Klagarge/Compressor/EliseZanou_RemiHeredero_Compresseur.pdf

# CCO : PROJET

## Compresseur Monocylindre

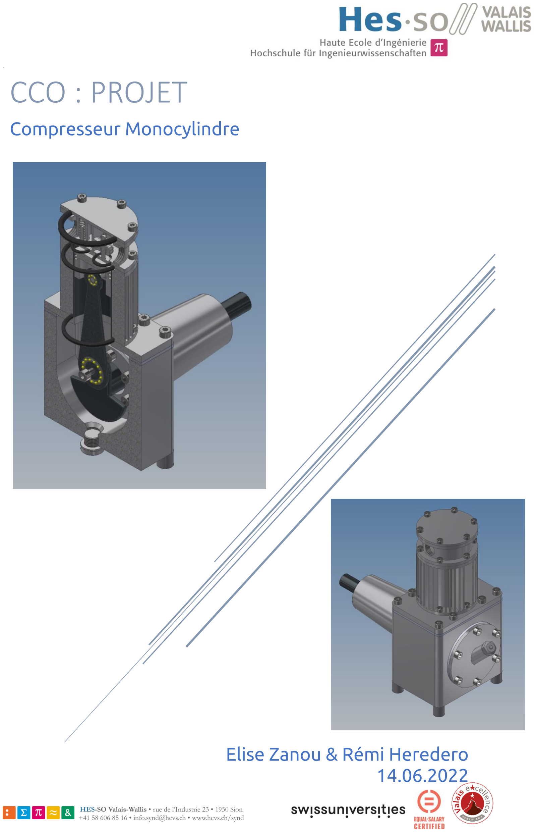
[picture p3: page 1]

HES-SO Valais-Wallis • rue de l’Industrie 23 • 1950 Sion +41 58 606 85 16 • info.synd@hevs.ch • www.hevs.ch/synd

CC

## Elise Zanou & Rémi Heredero

14.06.2022

Elise Zanou & Rémi Heredero | Projet Compresseur | CCO

## Table des matières

5.8 | Carter chapeau P017 | 10
5.9 | Vilebrequin P015 | 10
6 | Bielle P012 | 10
7 | Les roulements | 11
8 | Synthèses et conclusion | 11
9 | Annexes | 12
9.1 | Rapport analyse roulement | 12
9.2 | Choix ressorts | 16
9.3 | Lexique des abréviations et valeurs | 17
Figure 1 Air entrant dans la chambre | 4
Figure 2 Chambre remplie | 4
Figure 3 L'aire ressort | 4
Figure 4 Vue en coupe de la chambre | 5
Figure 7 Piston | 7
Figure 8 Vue en coupe carter | 9

## 1 Introduction

Dans le cours de CCO nous sommes amenés à créer un compresseur monocylindre.

Ce projet est un travail de groupe. Les compétences et les connaissances de chacun ont été nécessaire à la réalisation de ce travail.

Pour cela nous allons utiliser nos connaissances emmagasinées durant le premier et second semestre.

Les notions des propriétés des matériaux, de physique et de statique sont utilisées.

Nous utiliserons essentiellement le logiciel Autodesk Inventor 2021.3 pour la conception 3D et la mise en plan, Pivot V0.62 pour nos roulements. Les logiciels Word et Excel seront utilisés pour la rédaction de ce rapport.

Le projet a été diviser en 3 grande étape :

- Les croquis
- Le dimensionnement
- La réalisation 3D

## 2 Cahier des charges

Les données ci-dessous doivent être respectées tout au long du projet

SP-01 : Fréquence de rotation n 1440 [t/min]

SP-02 : Débit d'air Q 1.85 [m3/h]

SP-03 : Pression nominale P 6 [bar]

SP-04 : Facteur de dimensionnement à la pression nominale Kp 1.5 [-]

SP-05 : Rapport alésage course 1.2 à 1.3

SP-06 : Ø arbre d’entrée D 12 [mm]

SP-07 : Filetage entrée d'air G 1/4

SP-08 : Filetage sortie d'air G 1/4

## 3 Description fonctionnelle

Le compresseur est totalement géré mécaniquement. Nous pouvons diviser en trois parties son principe de fonctionnement.

### 3.1 L’air entre

Dès que le piston se déplace vers le bas, un vide est créé cela fait descendre la soupape de droite et l’aire peut s’introduire à l’intérieur de la chambre.

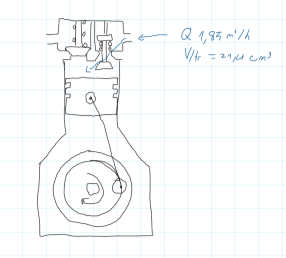
[picture p4: figure]

Figure 1 Air entrant dans la chambre

### 3.2 La chambre est remplie

Une fois le piston au point le plus bas la chambre est remplie à son max.

Figure 2 Chambre remplie

### 3.3 L’air ressort

La soupape de droite va se refermer et celle de gauche va s’ouvrir sous la pression dû au piston qui remonte.

L’air comprimé va être expulsé du compresseur.

Figure 3 L'aire ressort

Une fois le piston de retour à sa position de départ le cycle reprend.

Le compresseur est entraîné par un moteur. Il créé un couple sur un arbre. Nous utilisons ce couple pour mettre en mouvement un vilebrequin qui avec la bielle déplace le piston de haut en bas.

## Chambre E001

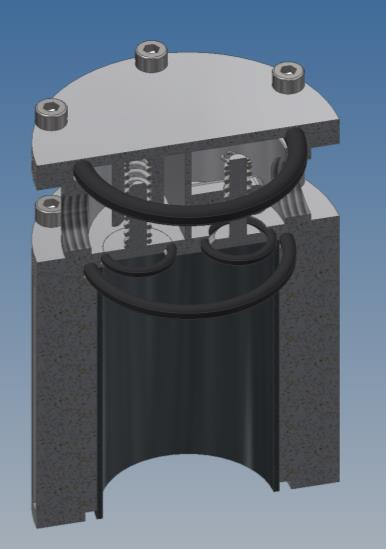
[picture p5: figure]

Figure 4 Vue en coupe de la chambre

### 3.4 Calcule volume du cylindre à 1 bar

Pour calculer le volume du cylindre nous prenons le débit d’air sur le fréquence en tour par heure.

V[m³
] =

Q [

m³
n

]

n [

t
min] ⋅ 60

= 21,41 ∗ 10³

[mm³
]

### 3.5 Calcule du Dcylindre

Afin de pouvoir calculer le diamètre du cylindre nous avons utilisé la formule du débit d’air :

Q =

π ∗ Dcyl
4

2
∗ course ∗ n

A l’aide de la formule établie au point 3.6 sur l’alésage nous pouvons établir l’équation suivante :

Q =

π ∗ Dcyl²
4

∗

Dcyl
1.2

∗ n

Donc nous pouvons isoler le diamètre du cylindre et en déduire la formule suivante :

Dcyl = √
Q∗4∗d
π∗n∗60

3

= √
1.85∗4∗1.2
π∗1440∗60

3
= 31.98 mm

### 3.6 Calcule alésage de la course

L’alésage de la course correspond au rapport entre le diamètre du cylindre et la course :

Dcyl
cours

= 1.2 => course =

Dcyl
1.2

### 3.7 Calcul de la hauteur du cylindre Hcyl

Pour calculer la hauteur du cylindre nous faisons appel à la loi des gaz parfaits

P1 ∗ V1 = P2 ∗ V2

P2 = 9 ∗ P1

↔ V1 = 9 ∗ V2

A une pression de 9 bar (à 9 bar, le facteur de sécurité de 1,5 est compris) donc le volume doit être 9 fois plus petit :

π ∗ d

2
4

∗ Hcyl = 9 ∗

πd

2
4

∗ ( Hcyl − course)

↔ Hcyl = 9 ∗ Hcyl − 9 ∗ course

Hcyl =

9
8

∗

Dcyl
d

=

9
8

∗

31.98
1.2

= 29.98

### 3.8 Calcul de la course

L’alésage de la course correspond au rapport entre le diamètre et la course.

course =

Dcycle
d

=

31.98
1.2

= 26.65

### 3.9 Calcul de la pression max de la chambre

Pmax = Pnominale ∗ kp = 6 ∗ 1.5 = 9Pa

### 3.10Chapeau tête chambre P 0019

La pièce chapeau tête chambre permet de mettre la soupape avec le ressort pour la sortie de l’air.

### 3.11Chapeau chambre P011

La pièce chapeau chambre gère l’entrée et la sortie de l’air. Elle tient les joints d’étanchéité des soupapes. Elle tient la soupape d’entrée.

### 3.12Soupape P006

La Soupape In laisse rentrer l’air. A contrario la Out laisse sortir l’air.

### 3.12.1Calcule des ressorts de soupapes P029 et P030

Pour dimensionner les ressorts il nous faut connaitre la force appliquée sur eux :

w = 2 ∗ π ∗

f
60 = 2 ∗ π ∗

1440
60 = 150.796 m/s

2

accelération piston = w

2

∗ rb ∗ (1 +

course
lb ) ∗ 10⁻³ = 150.796²

∗ 15 ∗ ( 1 +

30
64.8

) ∗ 10⁻³

= 499.004 m/s

2

masse bielle = 29,172g

masse piston = 21,797g

masse roulement = 4g

masse fixarion roulement = 0,739g

mtot = mb + mp + mr + mf = 55.708g = 0.055708 kg

F = a ∗ mtot = 499.004 ∗ 0.055708 = 27.8 N

Le choix des ressorts a été fait sur Inventor avec l’option design voir annexe 9.3.

### 3.13Bati Chambre P002

Il fait le refroidissement du compresseur. Il sert de bâti pour la chambre de compression.

### 3.14Couverture P001

La couverture a été faite en acier. Pour les segments qui sont aussi en acier fassent étanchéité.

Le calcul du diamètre de la couverture est calculé au point 4.1

### 3.15 Joint

Joint Oring bien que les éléments soient normalisés, il faut se veiller lors de la commande à prendre des joints FKM ( Viton ) ou tout autre dérivé de polytétrafluoréthylène car cette matière tient sans problème jusqu’à 200°C.

### 3.16Circlip

Il est posé sur la soupape afin de retenir le ressort

## 4 Piston

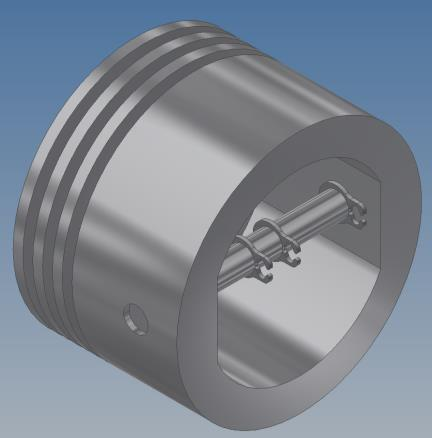
[picture p6: figure]

Figure 5 Piston

### 4.1 Calcule du diamètre extérieur du piston par rapport à la dilation thermique

Lors du fonctionnement du compresseur de la chaleur est générée.

Cela engendre pour le piston une situation critique de 190°C et pour le cylindre 100°C

Nous admettons que la température ambiante est de 20°C

αacier = 12 ∗ 10⁻⁶1/k

αalu = 23 ∗ 10⁻⁶1/k

Variation unitaire de longeur = ε = α( Tfinale − Tinitiale)

Variation de dimension Diamètre linéarie = D( Tfinale) = D(Tinitlae) ∗ ( 1 + ε)

Le diamètre de référence pris est celui de la chemise à 20°C qui est de 30 mm

Le diamètre du piston est calculé en fonction de celui de la chemise – le jeu

Nous devons avoir un jeu afin que dans le cylindre le piston se déplace de haut en bas.

Diamètre piston

T = 20°C | 29.9437 | [mm]
T = 100°C | 29.9988 | [mm]
T = 190°C | 29.9988 | [mm]

Diamètre cylindre

T = 20°C | 32 | [mm]
T = 100°C | 32.05888 | [mm]
T = 190°C | 32.1179 | [mm]

Diamètre chemise

T = 20°C | 30 | [mm]
T = 100°C | 30.0288 | [mm]
T = 190°C | 30.0612 | [mm]

Jeu chemise piston

T = 20°C | 0.0563
T = 100&20°C | 0.03

### 4.2 Axe P005

Cette pièce fait tient le roulement sur le piston pour faire la liaison entre le piston et la bielle.

### 4.3 Corp P003

Cette pièce permet de tenir les segments.

### 4.4 Segments P027 et P028

Fait la jointure dynamique pour compresser l’air avec la couverture.

### 4.5 Circlip

Sur l’axe du piston : tient l’axe et le roulement du piston.

## 5 Carter

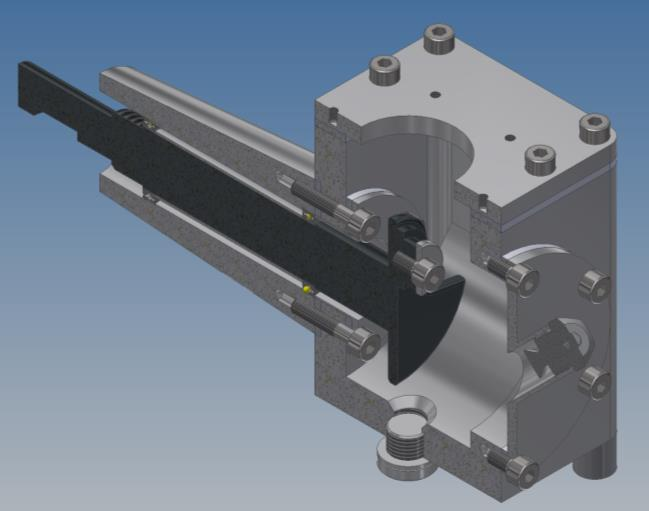
[picture p7: figure]

Figure 6 Vue en coupe carter

T = 190°C | 0.0292

Jeu chemise cylindre

T = 20°C | 0
T = 100&20°C | -0.03008
T = 190°C | 0.0567

### 5.1 Carter Corps P016

Il a été créé de la façon suivante :

- Pour faciliter la sortie
- Un coté fixation vilebrequin
- De l’autre ouverture
- Pour passer la bielle par-dessus

### 5.2 Butée P026

Fixe la bague extérieure du roulement de l’arbre coté carter.

### 5.3 Joint P018, P022 et P025

Ils sont en polytétrafluoréthylène

Ce sont des plaques de jointure découpées au jet d’eau. Elles servent à faire l’étanchéité de l’huile entre deux pièces.

### 5.4 Entretoise P024

Sert à fixer les deux bagues intérieures des roulements.

### 5.5 Cage P023

Maintient l’arbre au travers des roulement.

### 5.6 Bouchon vilebrequin P021

Cette pièce sert de montage pour rentrer le vilebrequin dans le carter. Et sert à remplir d’huile et mettre le bouchon du respirateur.

### 5.7 Fixation roulement P020

Cet élément fixe le roulement qui maintient le vilebrequin et la bielle.

### 5.8 Carter chapeau P017

Cette pièce ferme le carter sur le haut. On y vient viser la chambre.

### 5.9 Vilebrequin P015

Le système dispose d’une tenue d’un côté.

Les deux roulements qui tiennent le vilebrequin sont du même côté afin de simplifier le montage.

Il a déjà l’arbre relier au moteur avec la place pour la clavette.

## 6 Bielle P012

Le rapport suivant est fixé

rb =

course
2

= 13.325

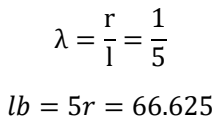
[picture p8: figure]

## 7 Les roulements

Voir annexe 11.1 Rapport analyse roulement

Fpiston = ( mPiston + mBielle) ∗ apmax

Fcarter = mCompresseur ∗ aCompresseur

aCompresseur = Fpiston/mCompresseur = aSoupape

= (mPiston + mBielle) ∗ w

2
∗ r ∗

1 + λ
mCompresseur

Fressort > mSoupape ∗ aSoupape =

(mPiston + mBielle)w

2
∗ r ( 1 + λ)
mCompresseur | ∗ mSoupape

## 8 Synthèses et conclusion

Lors de la conception de ce projet, nous avons utilisé essentiellement de l’aluminium. Ses propriétés sont très intéressantes. Il est léger, robuste et a un coefficient de température élevé. Nous avons aussi utilisé le l’acier pour la chemise et pour les ressorts.

La lubrification est faite selon le processus suivant : L’huile dans le carter, à chaque passage du vilebrequin est tapée et donc repartie dans le carter.

Sion le 17.06.2022

Elise Zanou | Rémi Heredero

## 9 Annexes

### 9.1 Rapport analyse roulement

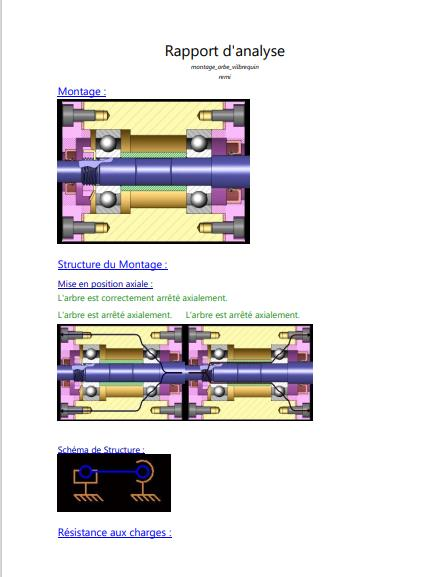
[picture p9: figure]

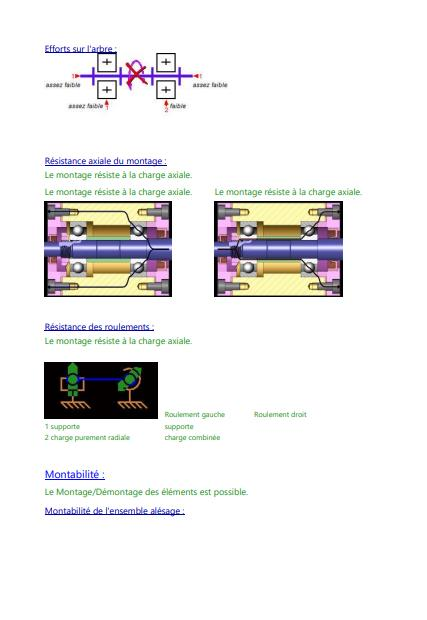
[picture p10: figure]

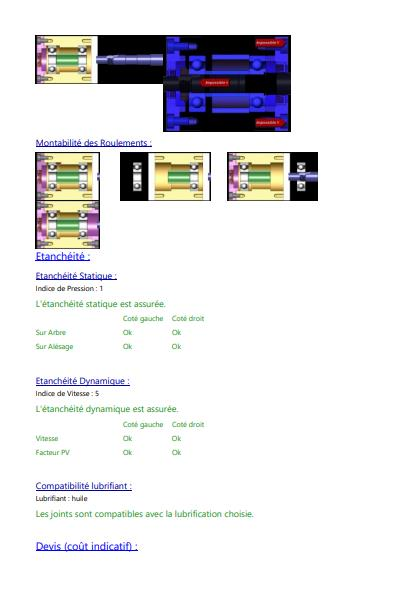
[picture p11: figure]
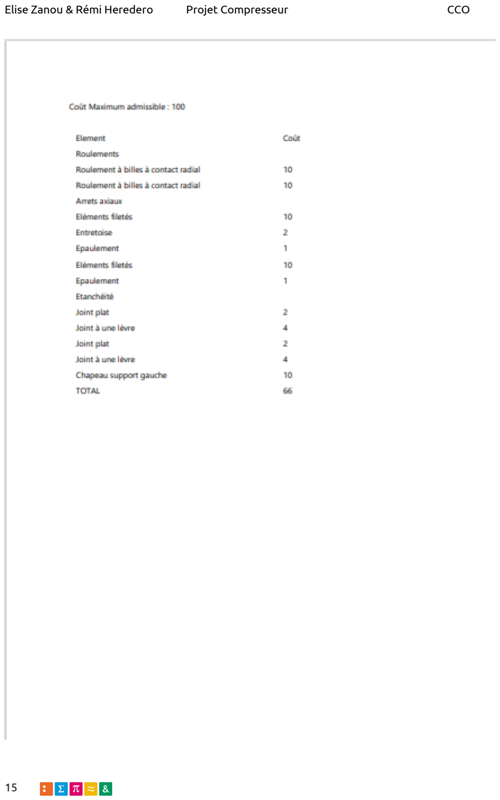
[picture p12: page 16]

### 9.2 Choix ressorts

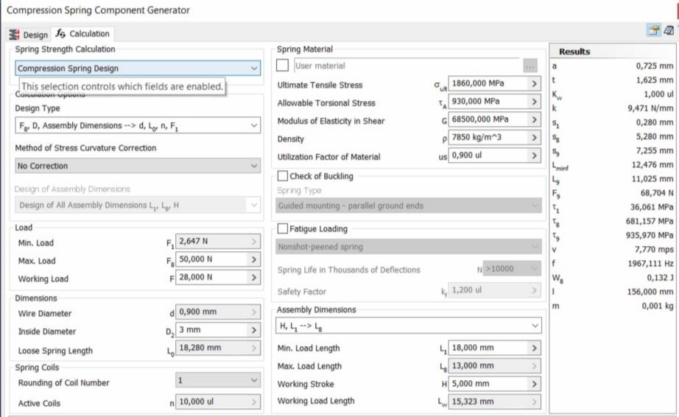
[picture p13: figure]
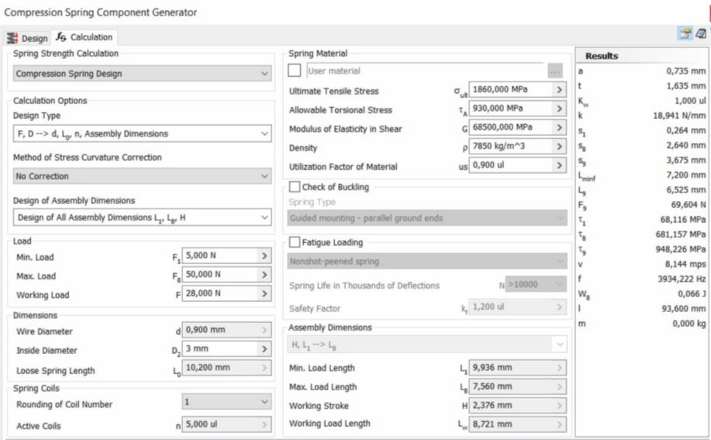
[picture p14: figure]

### 9.3 Lexique des abréviations et valeurs

Q = Débit d’aire [ m3/h]

n = Vitesse de rotation[ tr/h]

P = Pression

f= fréquence de rotation = 1440

Dcyl =diamètre cylindre =

Vcyl = Volume cylindre [mm3]

Hcyl =Hauteur cylindre = 30[ mm]

mb = masse bielle = 29,172[g]

mp = masse piston = 21,797[g]

mr = masse roulement = 0,739 [g]

mf= masse fixation roulement = 0,739[g]

a= accélération

Rb = rayon bielle = 15

Lb = longueur bielle= 64.8

α= Coefficient de dilatation thermique

T = température
