Klagarge/Compressor/R2021/part-nr-12140-45013-part-name-piston-ring-set-std-1.snapshot.4/olieschraapveer-01.jpg

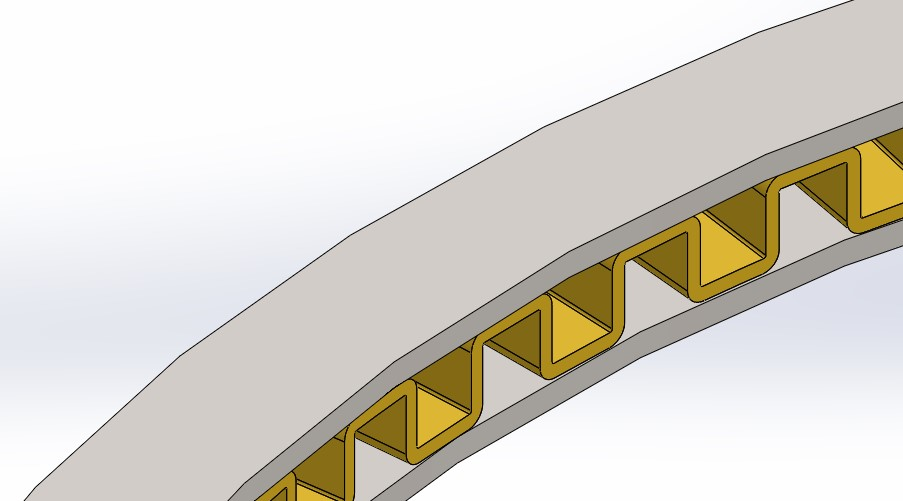
R2021/part-nr-12140-45013-part-name-piston-ring-set-std-1.snapshot.4/olieschraapveer-01.jpg
