Klagarge/Compressor/Circlips/einbaufertig_61799403.stp

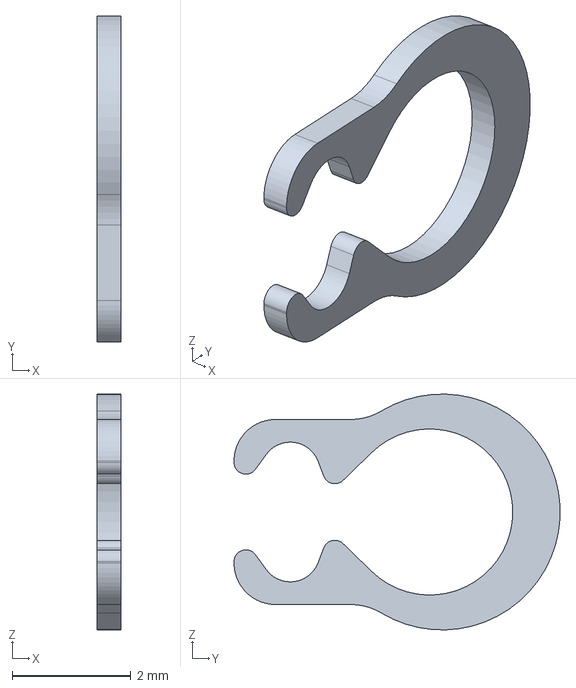
[picture p20: CAD file, 2022-05-29]
Circlips/einbaufertig_61799403.stp
0.4 x 5.50 x 3.98 mm
