Klagarge/Compressor/P016-Carter_corps.stl

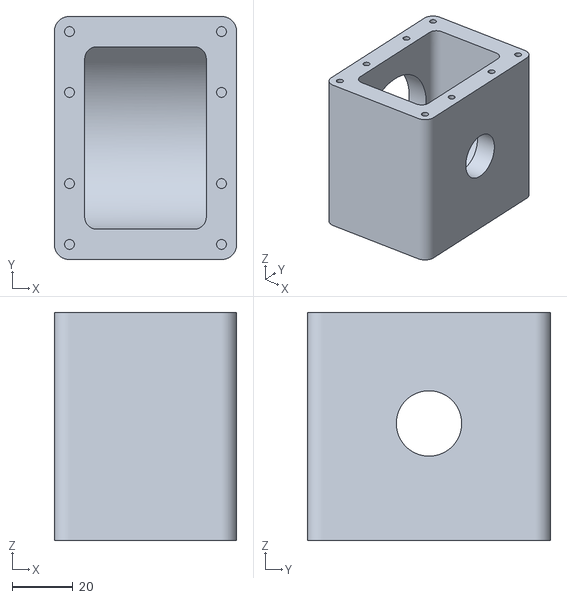
[picture p21: CAD file, 2022-06-11]
P016-Carter_corps.stl
60.0 x 80.0 x 75.0
