Klagarge/Compressor/Circlips/ungespannt_61799403.stp

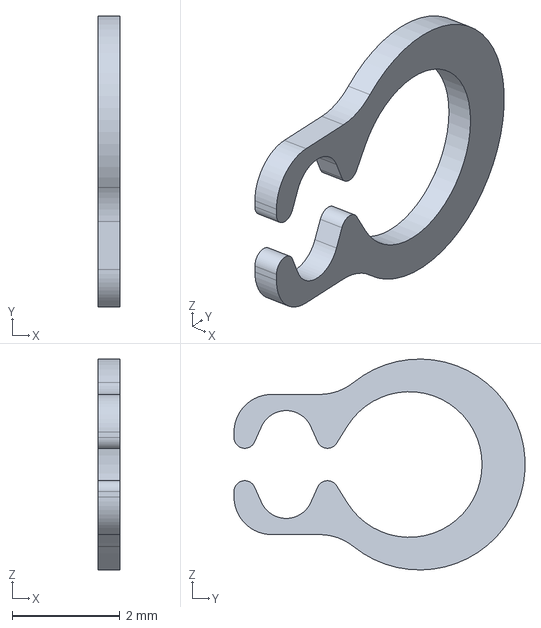
[picture p22: CAD file, 2022-05-29]
Circlips/ungespannt_61799403.stp
0.4 x 5.40 x 3.91 mm
