Klagarge/Compressor/P011-Chapeau_chambre.stl

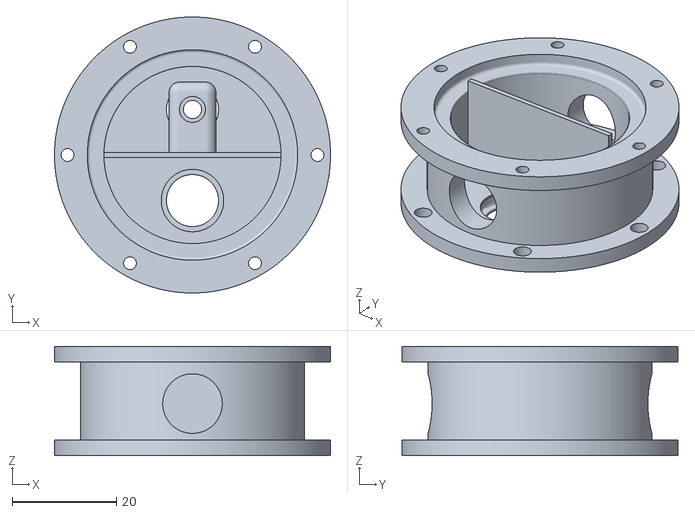
[picture p23: CAD file, 2022-06-03]
P011-Chapeau_chambre.stl
53.0 x 53.0 x 21.0
