Klagarge/Compressor/R2021/part-nr-12140-45013-part-name-piston-ring-set-std-1.snapshot.4/12140-45013.SLDASM

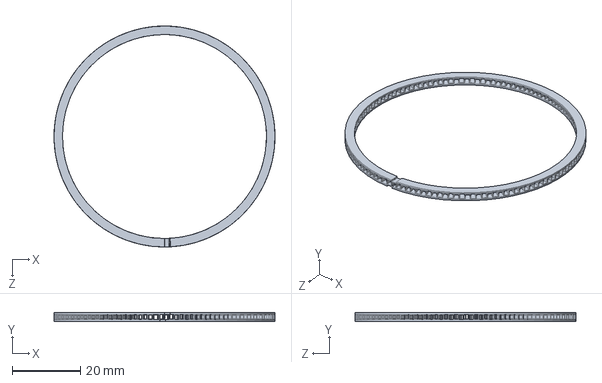
[picture p24: CAD file, 2022-06-15]
R2021/part-nr-12140-45013-part-name-piston-ring-set-std-1.snapshot.4/12140-45013.SLDASM
65.0 x 2.50 x 65.0 mm
