Klagarge/Compressor/R2021/piston-assembly-68.snapshot.2/12111-45002.SLDASM

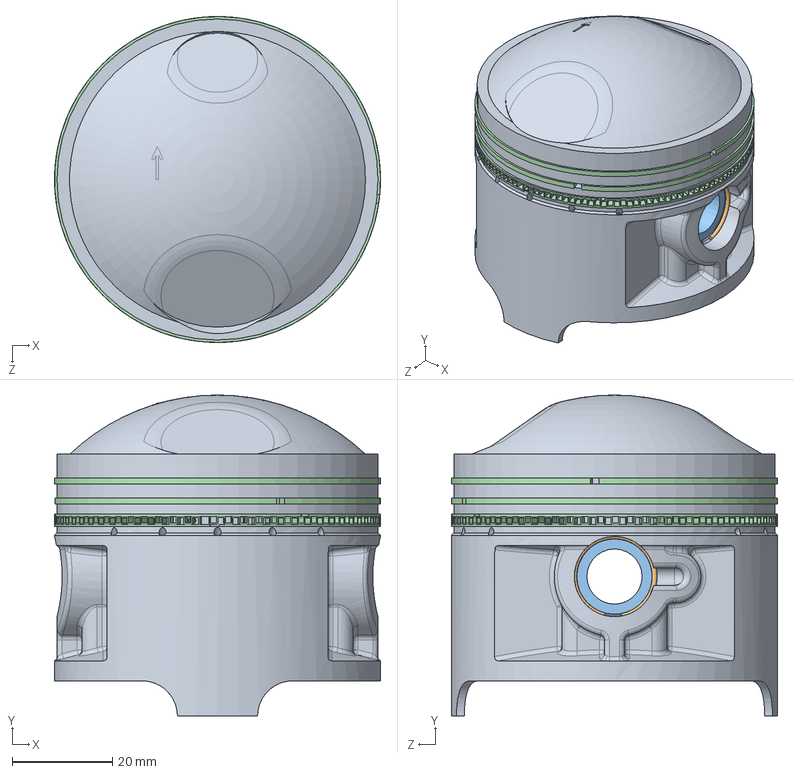
[picture p25: CAD file, 2022-06-15]
R2021/piston-assembly-68.snapshot.2/12111-45002.SLDASM
65.0 x 64.0 x 65.0 mm
