Klagarge/Compressor/R2021/piston-assembly-68.snapshot.2/12140-45013.SLDASM

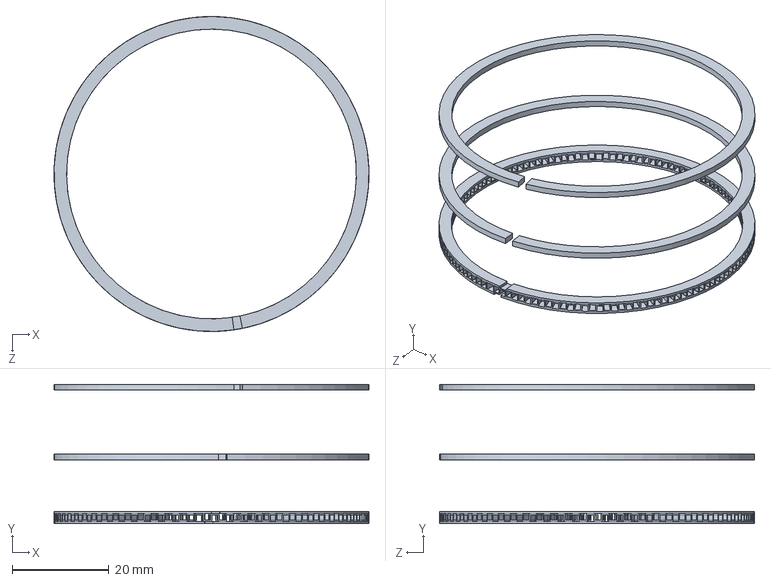
[picture p26: CAD file, 2022-06-15]
R2021/piston-assembly-68.snapshot.2/12140-45013.SLDASM
65.0 x 28.7 x 65.0 mm
