Klagarge/Compressor/R2021/64790059.stp

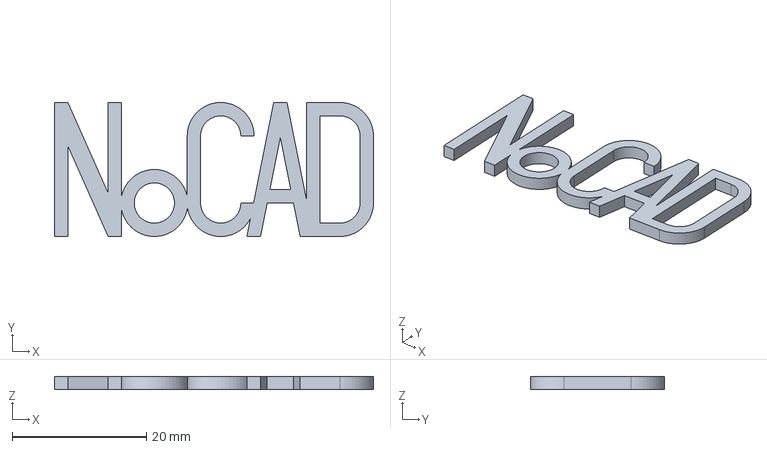
[picture p27: CAD file, 2022-06-15]
R2021/64790059.stp
47.6 x 20.0 x 2.00 mm
