Klagarge/Compressor/R2021/piston-assembly-68.snapshot.2/12151-29001.SLDPRT

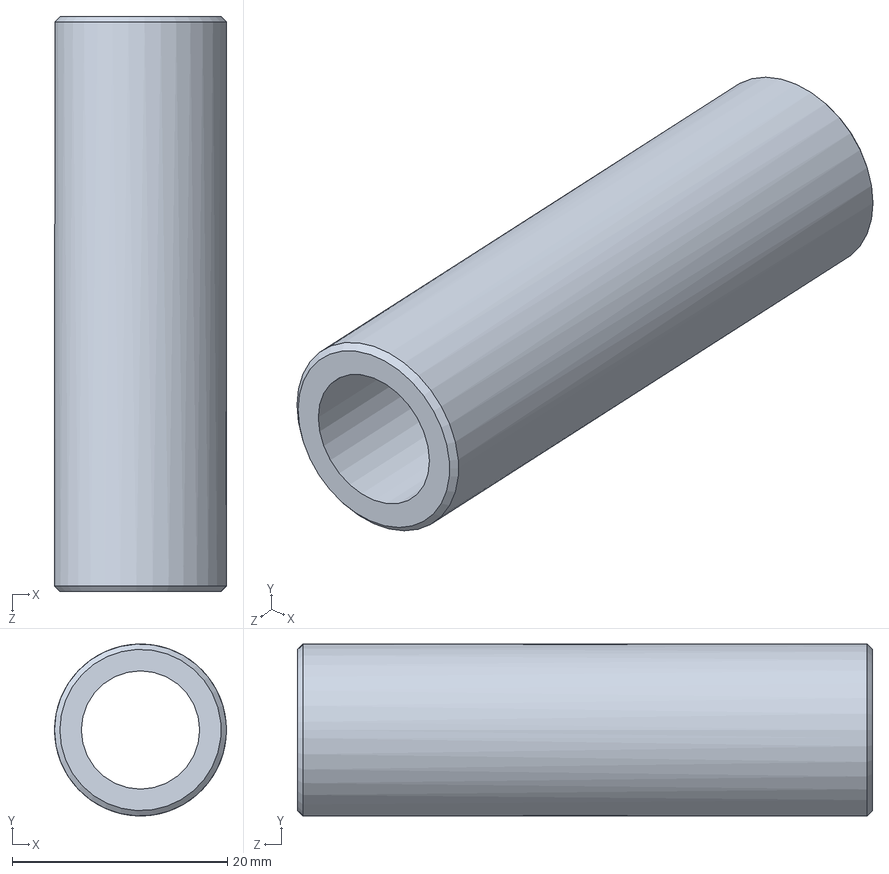
[picture p28: CAD file, 2022-06-15]
R2021/piston-assembly-68.snapshot.2/12151-29001.SLDPRT
16.0 x 16.0 x 53.5 mm
