Klagarge/Compressor/R2021/part-nr-12140-45013-part-name-piston-ring-set-std-1.snapshot.4/12111-45013.SLDPRT

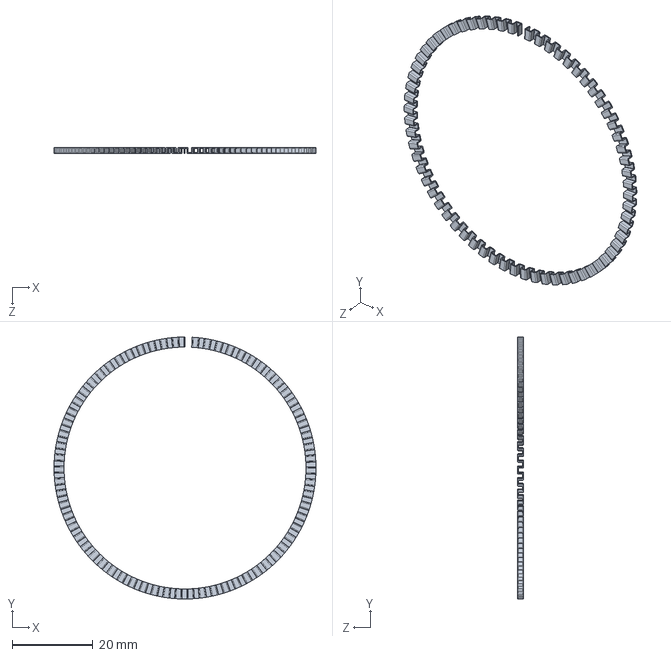
[picture p29: CAD file, 2022-06-15]
R2021/part-nr-12140-45013-part-name-piston-ring-set-std-1.snapshot.4/12111-45013.SLDPRT
65.0 x 65.0 x 1.60 mm
