Klagarge/Compressor/R2021/piston-assembly-68.snapshot.2/12111-45013.SLDPRT

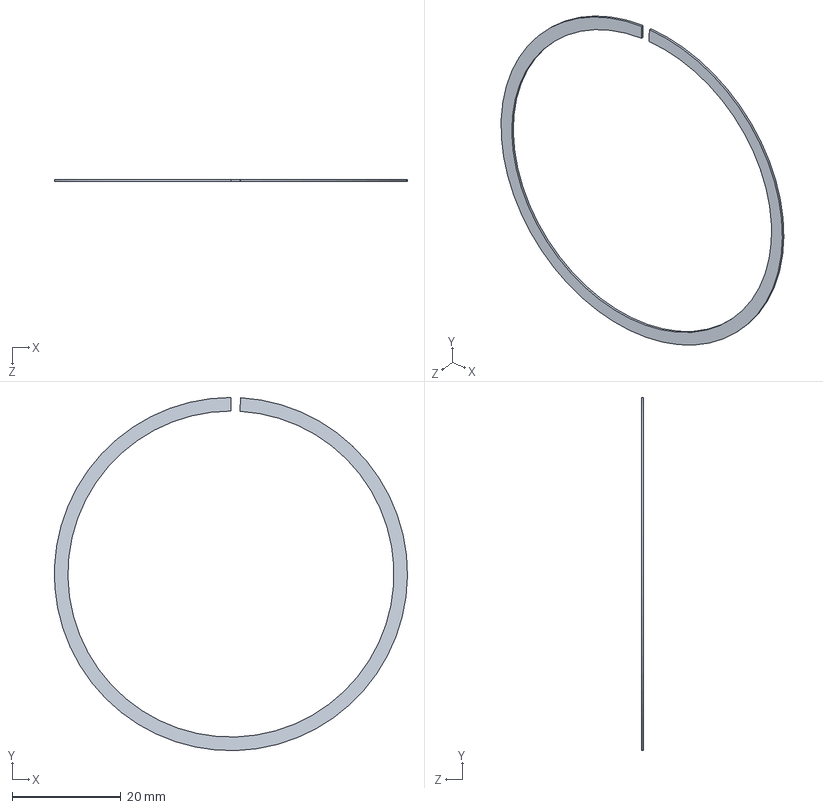
[picture p30: CAD file, 2022-06-15]
R2021/piston-assembly-68.snapshot.2/12111-45013.SLDPRT
65.0 x 65.0 x 0.45 mm
