Klagarge/Compressor/R2021/piston-assembly-68.snapshot.2/09381-16002.SLDPRT

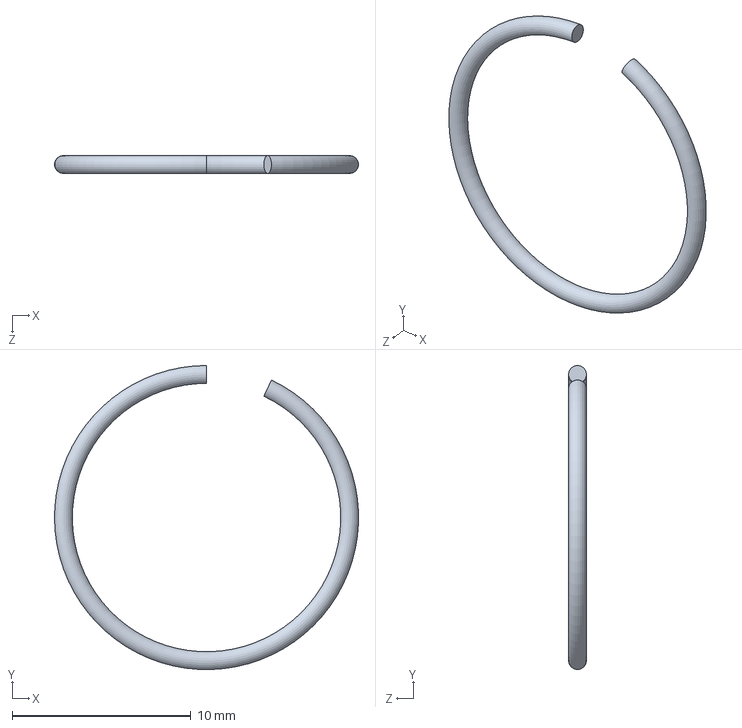
[picture p31: CAD file, 2022-06-15]
R2021/piston-assembly-68.snapshot.2/09381-16002.SLDPRT
17.0 x 17.0 x 1.00 mm
