Klagarge/Compressor/(list of files, cad)

Other CAD files:
R2021/64790021.stp
Circlips/OldVersions/ungespannt_61799403.0001.ipt
Circlips/einbaufertig_61799403.ipt
Circlips/ungespannt_61799403.ipt
Compress Spring14.ipt
Compress Spring15.ipt
Drawing/E000-Compresseur.idw
Drawing/E001-Chambre.idw
Drawing/E002-Piston.idw
Drawing/E006-Carter.idw
Drawing/OldVersions/E000-Compresseur.0011.idw
Drawing/OldVersions/E001-Chambre.0013.idw
Drawing/OldVersions/E002-Piston.0015.idw
Drawing/OldVersions/E006-Carter.0009.idw
Drawing/OldVersions/P001-Couverture.0006.idw
Drawing/OldVersions/P002-Bati_chambre.0014.idw
Drawing/OldVersions/P003-Corps_piston.0011.idw
Drawing/OldVersions/P005-Axe_piston.0007.idw
Drawing/OldVersions/P006-Soupape_IN.0008.idw
Drawing/OldVersions/P006-Soupape_OUT.0003.idw
Drawing/OldVersions/P011-Chapeau_chambre.0018.idw
Drawing/OldVersions/P012-Bielle.0008.idw
Drawing/OldVersions/P014-Chapeau_bielle.0002.idw
Drawing/OldVersions/P015-Vilbrequin.0013.idw
Drawing/OldVersions/P016-Carter_corps.0004.idw
Drawing/OldVersions/P016-Carter_corps.0013.idw
Drawing/OldVersions/P016-Carter_corps_V2.0002.idw
Drawing/OldVersions/P017-Carter_chapeau.0006.idw
Drawing/OldVersions/P018-Joint_carter_chapeau.0008.idw
Drawing/OldVersions/P019-Chapeau_tete_chambre.0009.idw
Drawing/OldVersions/P020-Fixation_roulement_vilebrequin.0004.idw
Drawing/OldVersions/P021-Bouchon_carter_vilbrequin.0010.idw
Drawing/OldVersions/P022-Joint_carter_bouchon_vilbrequin.0005.idw
Drawing/OldVersions/P023-Cage_arbre.0006.idw
Drawing/OldVersions/P024-Entretoise_roulements.0004.idw
Drawing/OldVersions/P025-Joint_carter_arbre.0005.idw
Drawing/OldVersions/P026-Butée_carter_arbre.0004.idw
Drawing/OldVersions/P027-Segment.0002.idw
Drawing/OldVersions/P028-Segment_racleur.0004.idw
Drawing/OldVersions/P029-Ressort.0002.idw
Drawing/OldVersions/P030-Ressort.0002.idw
Drawing/P001-Couverture.idw
Drawing/P002-Bati_chambre.idw
Drawing/P003-Corps_piston.idw
Drawing/P005-Axe_piston.idw
Drawing/P006-Soupape_IN.idw
Drawing/P006-Soupape_OUT.idw
Drawing/P011-Chapeau_chambre.idw
Drawing/P012-Bielle.idw
Drawing/P015-Vilbrequin.idw
Drawing/P016-Carter_corps.idw
Drawing/P016-Carter_corps_V2.idw
Drawing/P017-Carter_chapeau.idw
Drawing/P018-Joint_carter_chapeau.idw
Drawing/P019-Chapeau_tete_chambre.idw
Drawing/P020-Fixation_roulement_vilebrequin.idw
Drawing/P021-Bouchon_carter_vilbrequin.idw
Drawing/P022-Joint_carter_bouchon_vilbrequin.idw
Drawing/P023-Cage_arbre.idw
Drawing/P024-Entretoise_roulements.idw
Drawing/P025-Joint_carter_arbre.idw
Drawing/P026-Butée_carter_arbre.idw
Drawing/P027-Segment.idw
Drawing/P028-Segment_racleur.idw
Drawing/P029-Ressort.idw
Drawing/P030-Ressort.idw
E000-Compresseur.iam
E000-Compresseur/Design Accelerator/O-Ring1.iam
E001-Chambre.iam
E001-Chambre/Design Accelerator/O-Ring1.iam
E001-Chambre/Design Accelerator/O-Ring2.iam
E001-Chambre/Design Accelerator/O-Ring3.iam
E001-Chambre/Design Accelerator/O-Ring4.iam
E001-Chambre/Design Accelerator/O-Ring5.iam
E001-Chambre/Design Accelerator/O-Ring6.iam
E001-Chambre/Design Accelerator/O-Ring8.iam
E002-Piston.iam
E006-Carter.iam
E006-Carter/Design Accelerator/Key Connection2.iam
E006-Carter/Design Accelerator/O-Ring1.iam
E006-Carter/Design Accelerator/OldVersions/Key Connection2.0001.iam
OldVersions/Compress Spring14.0001.ipt
OldVersions/Compress Spring15.0001.ipt
OldVersions/E000-Compresseur.0072.iam
OldVersions/E001-Chambre.0042.iam
OldVersions/E002-Piston.0026.iam
OldVersions/E005-Bielle.0005.iam
OldVersions/E006-Carter.0088.iam
OldVersions/P001-Couverture.0007.ipt
OldVersions/P002-Bati_chambre.0014.ipt
OldVersions/P003-Corps_piston.0015.ipt
OldVersions/P005-Axe_piston.0011.ipt
OldVersions/P005_Axe_piston.0001.ipt
OldVersions/P006-Soupape.0012.ipt
OldVersions/P006-Soupape_entree.0001.ipt
OldVersions/P006-Soupape_entree.0002.ipt
OldVersions/P011-Chapeau_chambre.0024.ipt
OldVersions/P012-Bielle.0019.ipt
OldVersions/P012-Corps_bielle.0012.ipt
OldVersions/P014-Chapeau_bielle.0006.ipt
OldVersions/P015-Vilbrequin.0024.ipt
OldVersions/P016-Carter_corps.0040.ipt
OldVersions/P017-Carter_chapeau.0024.ipt
OldVersions/P018-Joint_carter_chapeau.0013.ipt
OldVersions/P019-Chapeau_tete_chambre.0018.ipt
OldVersions/P019-Joint_chambre_chapeau.0002.ipt
OldVersions/P020-Fixation_roulement_vilebrequin.0003.ipt
OldVersions/P021-Bouchon_carter_vilbrequin.0007.ipt
OldVersions/P022-Joint_carter_bouchon_vilbrequin.0006.ipt
OldVersions/P023-Cage_arbre.0011.ipt
OldVersions/P024-Entretoise_roulements.0002.ipt
OldVersions/P025-Joint_carter_arbre.0006.ipt
OldVersions/P026-Butée_carter_arbre.0008.ipt
OldVersions/P027-Segment.0004.ipt
OldVersions/P027-Segments.0002.ipt
OldVersions/P028-Segment_racleur.0006.ipt
OldVersions/P029-Ressort.0002.ipt
OldVersions/P030-Ressort.0002.ipt
P001-Couverture.ipt
P002-Bati_chambre.ipt
P003-Corps_piston.ipt
P005-Axe_piston.ipt
P005_Axe_piston.ipt
P006-Soupape.ipt
P006-Soupape/OldVersions/P006-Soupape_IN.0005.ipt
P006-Soupape/OldVersions/P006-Soupape_OUT.0003.ipt
P006-Soupape/P006-Soupape_IN.ipt
P006-Soupape/P006-Soupape_OUT.ipt
P006-Soupape_entree.ipt
P011-Chapeau_chambre.ipt
P012-Bielle.ipt
P012-Corps_bielle.ipt
P015-Vilbrequin.ipt
P016-Carter_corps.ipt
P017-Carter_chapeau.ipt
P018-Joint_carter_chapeau.ipt
P019-Chapeau_tete_chambre.ipt
P020-Fixation_roulement_vilebrequin.ipt
P021-Bouchon_carter_vilbrequin.ipt
P022-Joint_carter_bouchon_vilbrequin.ipt
P023-Cage_arbre.ipt
P024-Entretoise_roulements.ipt
P025-Joint_carter_arbre.ipt
P026-Butée_carter_arbre.ipt
P027-Segment.ipt
P028-Segment_racleur.ipt
P029-Ressort.ipt
P030-Ressort.ipt
R2021/54-2-3-Durovis.ipt
R2021/64790021.ipt
R2021/64790059.ipt
R2021/68978100.ipt
R2021/8631T11_Breather Vent.ipt
R2021/en-US/AS 1420/AS 1420 - 1973 - M3 x 6.ipt
R2021/en-US/AS 1420/AS 1420 - 1973 - M3 x 8.ipt
R2021/en-US/AS 1420/AS 1420 - 1973 - M4 x 12.ipt
R2021/en-US/AS 1420/AS 1420 - 1973 - M4 x 14.ipt
R2021/en-US/AS 1420/AS 1420 - 1973 - M4 x 20.ipt
R2021/en-US/AS 1420/AS 1420 - 1973 - M4 x 8.ipt
R2021/en-US/AS 1420/OldVersions/AS 1420 - 1973 - M3 x 6.0001.ipt
R2021/en-US/AS 1420/OldVersions/AS 1420 - 1973 - M3 x 8.0001.ipt
R2021/en-US/AS 1420/OldVersions/AS 1420 - 1973 - M4 x 12.0001.ipt
R2021/en-US/AS 1420/OldVersions/AS 1420 - 1973 - M4 x 8.0001.ipt
R2021/en-US/AS 1427(02)/AS 1427 - M10 x 20(2).ipt
R2021/en-US/Bearing GB_T 5800-2003/Rolling bearing GB_T 5800-2003 -619_3.ipt
R2021/en-US/Bearing GB_T 5800-2003/Rolling bearing GB_T 5800-2003 -639_3.ipt
R2021/en-US/DIN 7985 (Z)/DIN 7985 (Z) - M2,5x3-Z.ipt
R2021/en-US/DIN 7985 (Z)/DIN 7985 (Z) - M2,5x5-Z.ipt
R2021/en-US/DIN 7985 (Z)/DIN 7985 (Z) - M4x10-Z.ipt
R2021/en-US/DIN 7985 (Z)/DIN 7985 (Z) - M4x5-Z.ipt
R2021/en-US/E 2076/_E 2076-10_.ipt
R2021/en-US/E 2076/_E 2076-14_.ipt
R2021/en-US/ISO 2491 - A/ISO 2491 - A 6 x 4 x 14.ipt
R2021/en-US/ISO 3601-1(2)/ISO 3601-1 - A 0018 G(2).ipt
R2021/en-US/ISO 3601-1(3)/ISO 3601-1 - B 0170 G(3).ipt
R2021/en-US/ISO 3601-1(5)/ISO 3601-1 - B 0325 G 32(5).ipt
R2021/en-US/ISO 3601-1(8)/ISO 3601-1 - A 0100 G 10(8).ipt
R2021/en-US/ISO 3601-1(8)/ISO 3601-1 - A 0112 G 11(8).ipt
R2021/en-US/ISO 3601-1(8)/ISO 3601-1 - A 0118 G 12(8).ipt
R2021/en-US/ISO 3601-1(8)/ISO 3601-1 - B 0236 G 23(8).ipt
R2021/en-US/ISO 3601-1(8)/ISO 3601-1 - B 0325 G 32(8).ipt
R2021/en-US/ISO 3601-1(8)/ISO 3601-1 - C 0300 G 30(8).ipt
R2021/en-US/ISO 3601-1(8)/ISO 3601-1 - C 0345 G 34(8).ipt
R2021/en-US/ISO 3601-1(8)/ISO 3601-1 - D 0412 G 40(8).ipt
R2021/en-US/ISO 4027/ISO 4027 - M2 x 6 - ISO.ipt
R2021/en-US/ISO 4027/ISO 4027 - M4 x 6 - ISO.ipt
R2021/en-US/ISO 7434(2)/ISO 7434 - M4 x 6ISO.ipt
R2021/en-US/UNI 6049/UNI 6049 - M4 x 20 - 0,7.ipt
R2021/piston-assembly-68.snapshot.2/12111-45002.SLDPRT
Roulements/AIS2021/OldVersions/SKF_W 61701-2RS1.0001.iam
Roulements/AIS2021/OldVersions/SKF_W 61701-2RS1.0002.iam
Roulements/AIS2021/OldVersions/SKF_W 61701-2RS1_PART1.0001.ipt
Roulements/AIS2021/OldVersions/SKF_W 61701-2RS1_PART2.0001.ipt
Roulements/AIS2021/OldVersions/SKF_W 61701-2RS1_PART3.0001.ipt
Roulements/AIS2021/OldVersions/SKF_W 61701-2RS1_PART4.0001.ipt
Roulements/AIS2021/OldVersions/SKF_W 619_3-2Z.0001.iam
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
