Klagarge/Compressor/Roulements/rapport_montage_arbre_vilbrequin.pdf

## Rapport d'analyse

montage_arbe_vilbrequin
remi

### Montage :

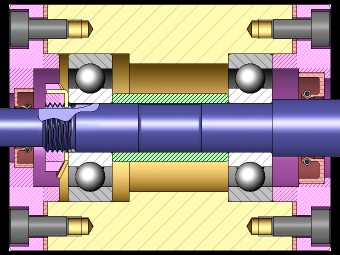
[picture p32: figure]

### Structure du Montage :

Mise en position axiale :
L'arbre est correctement arrêté axialement.
L'arbre est arrêté axialement. L'arbre est arrêté axialement.

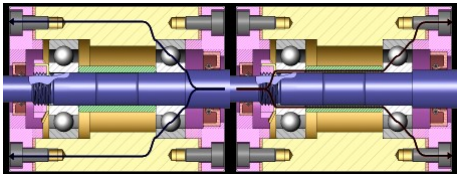
[picture p33: figure]

Schéma de Structure :

### Résistance aux charges :

Efforts sur l'arbre :

Résistance axiale du montage :
Le montage résiste à la charge axiale.
Le montage résiste à la charge axiale. Le montage résiste à la charge axiale.

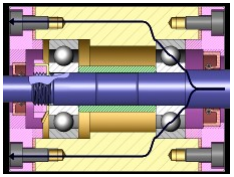
[picture p34: figure]

Résistance des roulements :
Le montage résiste à la charge axiale.

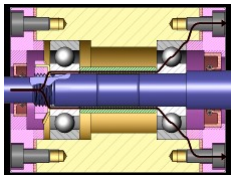
[picture p35: figure]

Roulement gauche | Roulement droit
1 supporte | supporte
2 charge purement radiale | charge combinée

### Montabilité :

Le Montage/Démontage des éléments est possible. Montabilité de l'ensemble alésage :

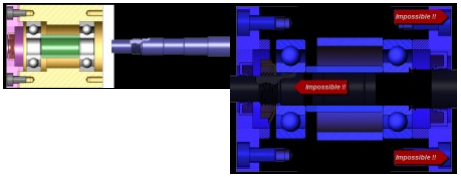
[picture p36: figure]

Montabilité des Roulements :

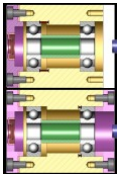
[picture p37: figure]

### Etanchéité :

Etanchéité Statique :
Indice de Pression : 1

L'étanchéité statique est assurée.
Coté gauche Coté droit
Sur Arbre | Ok | Ok
Sur Alésage | Ok | Ok

Etanchéité Dynamique :
Indice de Vitesse : 5
L'étanchéité dynamique est assurée.
Coté gauche Coté droit
Vitesse | Ok | Ok
Facteur PV | Ok | Ok

Compatibilité lubrifiant :
Lubrifiant : huile

Les joints sont compatibles avec la lubrification choisie.

### Devis (coût indicatif) :

Coût Maximum admissible : 100

Element | Coût
Roulements
Roulement à billes à contact radial | 10
Roulement à billes à contact radial | 10
Arrets axiaux
Eléments filetés | 10
Entretoise | 2
Epaulement | 1
Eléments filetés | 10
Epaulement | 1
Etanchéité
Joint plat | 2
Joint à une lèvre | 4
Joint plat | 2
Joint à une lèvre | 4
Chapeau support gauche | 10
TOTAL | 66
