Klagarge/Compressor/R2021/piston-assembly-68.snapshot.2/piston-01.jpg

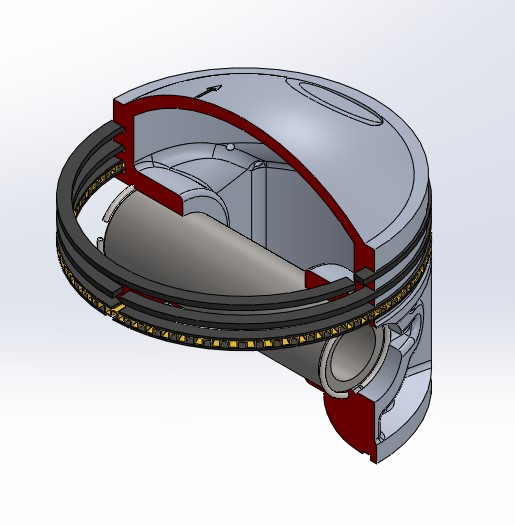
R2021/piston-assembly-68.snapshot.2/piston-01.jpg
