Klagarge/Compressor/R2021/piston-assembly-68.snapshot.2/piston-07.jpg

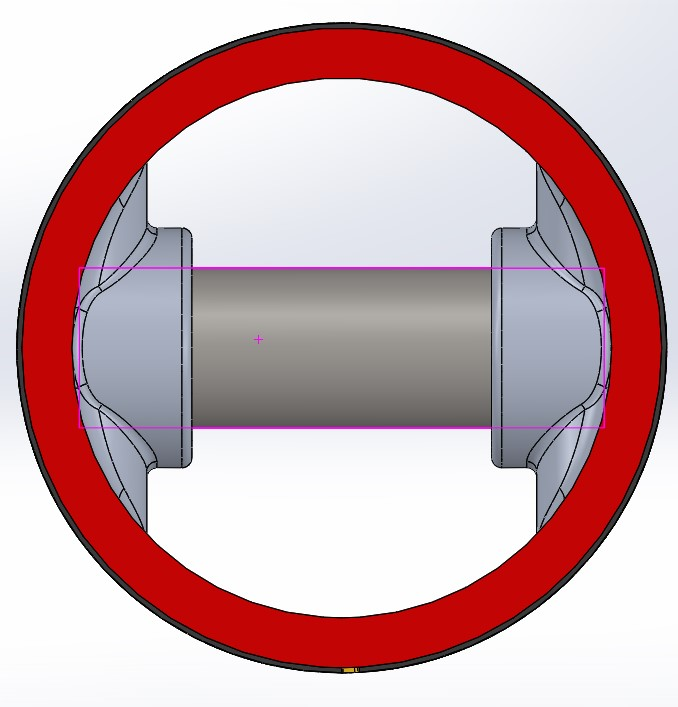
R2021/piston-assembly-68.snapshot.2/piston-07.jpg
