Klagarge/Compressor/R2021/piston-assembly-68.snapshot.2/piston.jpg

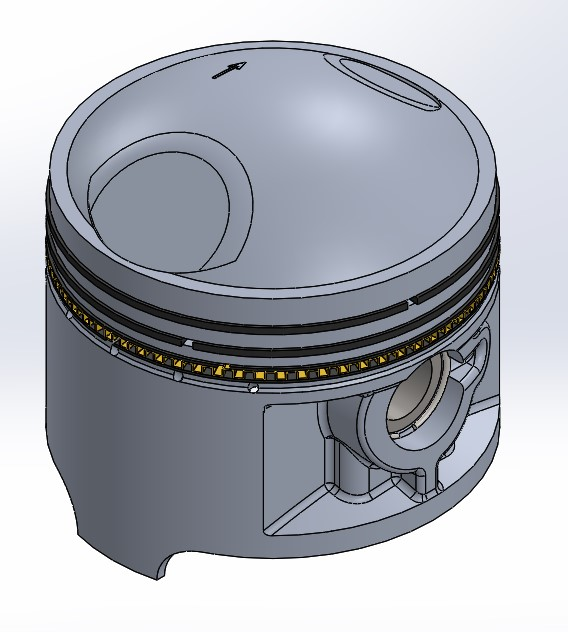
R2021/piston-assembly-68.snapshot.2/piston.jpg
