Klagarge/Compressor/PDF/E001-Chambre.pdf

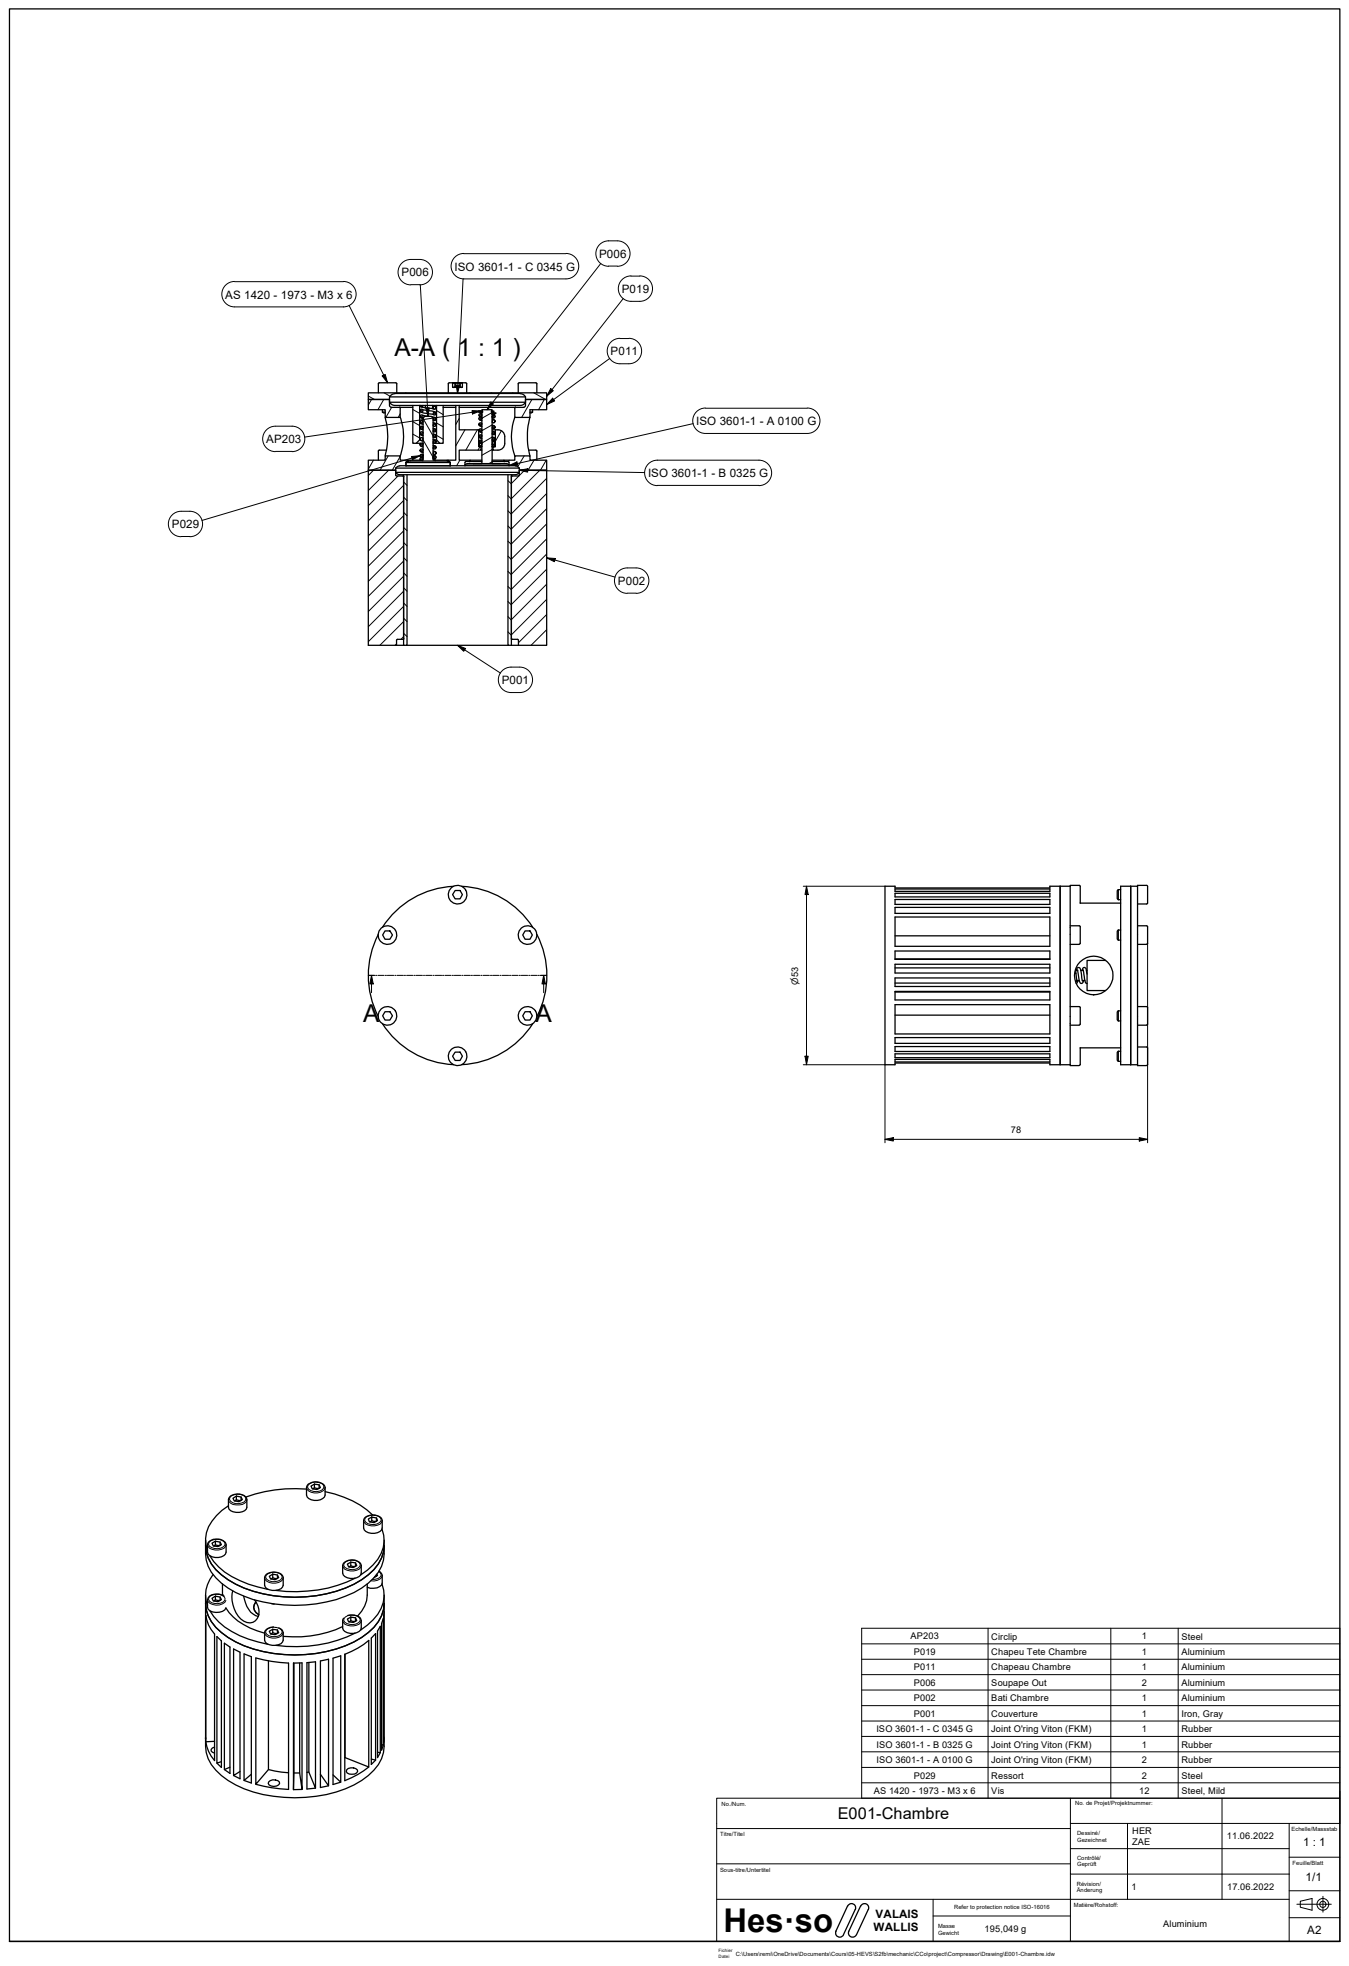
[picture p46: page 1]
ISO 3601-1 - C 0345 G P006; ISO 3601-1 - B 0325 G; ISO 3601-1 - A 0100 G

AP203 | Circlip | 1 | Steel
P019 | Chapeu Tete Chambre | 1 | Aluminium
P011 | Chapeau Chambre | 1 | Aluminium
P006 | Soupape Out | 2 | Aluminium
P002 | Bati Chambre | 1 | Aluminium
P001 | Couverture | 1 | Iron, Gray

ISO 3601-1 - C 0345 G | Joint O'ring Viton (FKM) | 1 | Rubber
ISO 3601-1 - B 0325 G | Joint O'ring Viton (FKM) | 1 | Rubber
ISO 3601-1 - A 0100 G | Joint O'ring Viton (FKM) | 2 | Rubber

P029 | Ressort | 2 | Steel

AS 1420 - 1973 - M3 x 6 | Vis | 12 | Steel, Mild

No./Num. E001-Chambre | No. de Projet/Projektnummer:

Dessinp/ Gezeichnet | HER ZAE | 11.06.2022 | Echelle/Massstab 1 : 1

Contr{lp/ Geprüft

Sous-titre/Untertitel

Rpvision/ bnderung | 1 | 17.06.2022

Hesso VALAIS WALLIS | Refer to protection notice ISO-16016 | Matiqre/Rohstoff: Aluminium

Masse 195,049 g Gewicht | | A2
