Klagarge/Compressor/PDF/E002-Piston.pdf

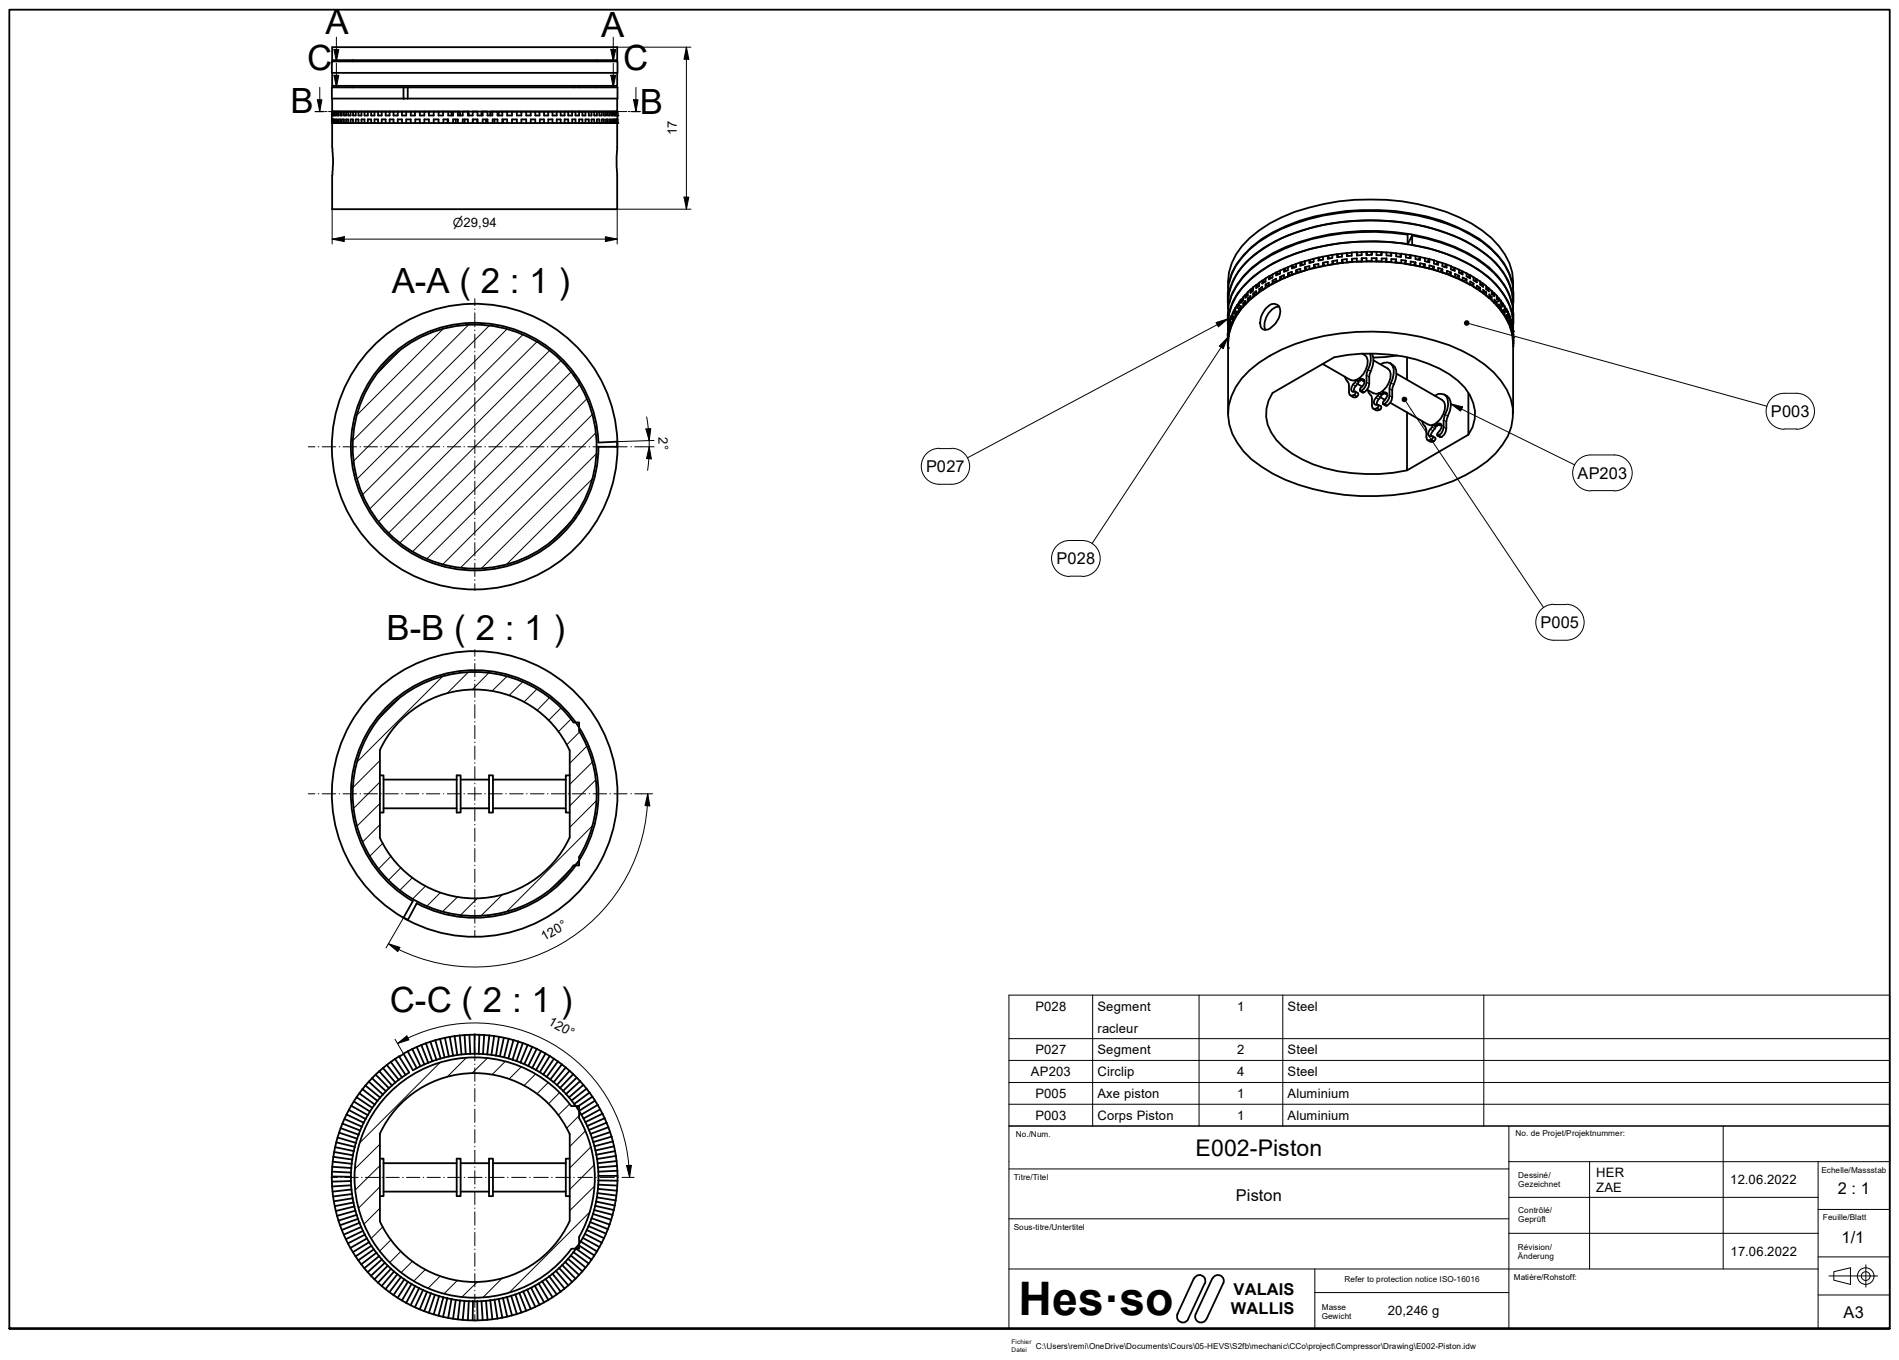
[picture p47: page 1]
Segment; Steel

P028 | racleur

P027 | Segment | 2 | Steel
AP203 | Circlip | 4 | Steel
P005 | Axe piston | 1 | Aluminium
P003 | Corps Piston | 1 | Aluminium
No./Num. E002-Piston | No. de Projet/Projektnummer:

Dessinp/ Gezeichnet | HER ZAE | 12.06.2022 | Echelle/Massstab 2 : 1

Contr{lp/ Geprüft

Sous-titre/Untertitel

Rpvision/ bnderung | | 17.06.2022

Hesso VALAIS WALLIS | R | Matiqre/Rohstoff: efer to protection notice ISO-16016

Masse 20,246 g Gewicht | | A3
