Klagarge/Compressor/PDF/E006-Carter.pdf

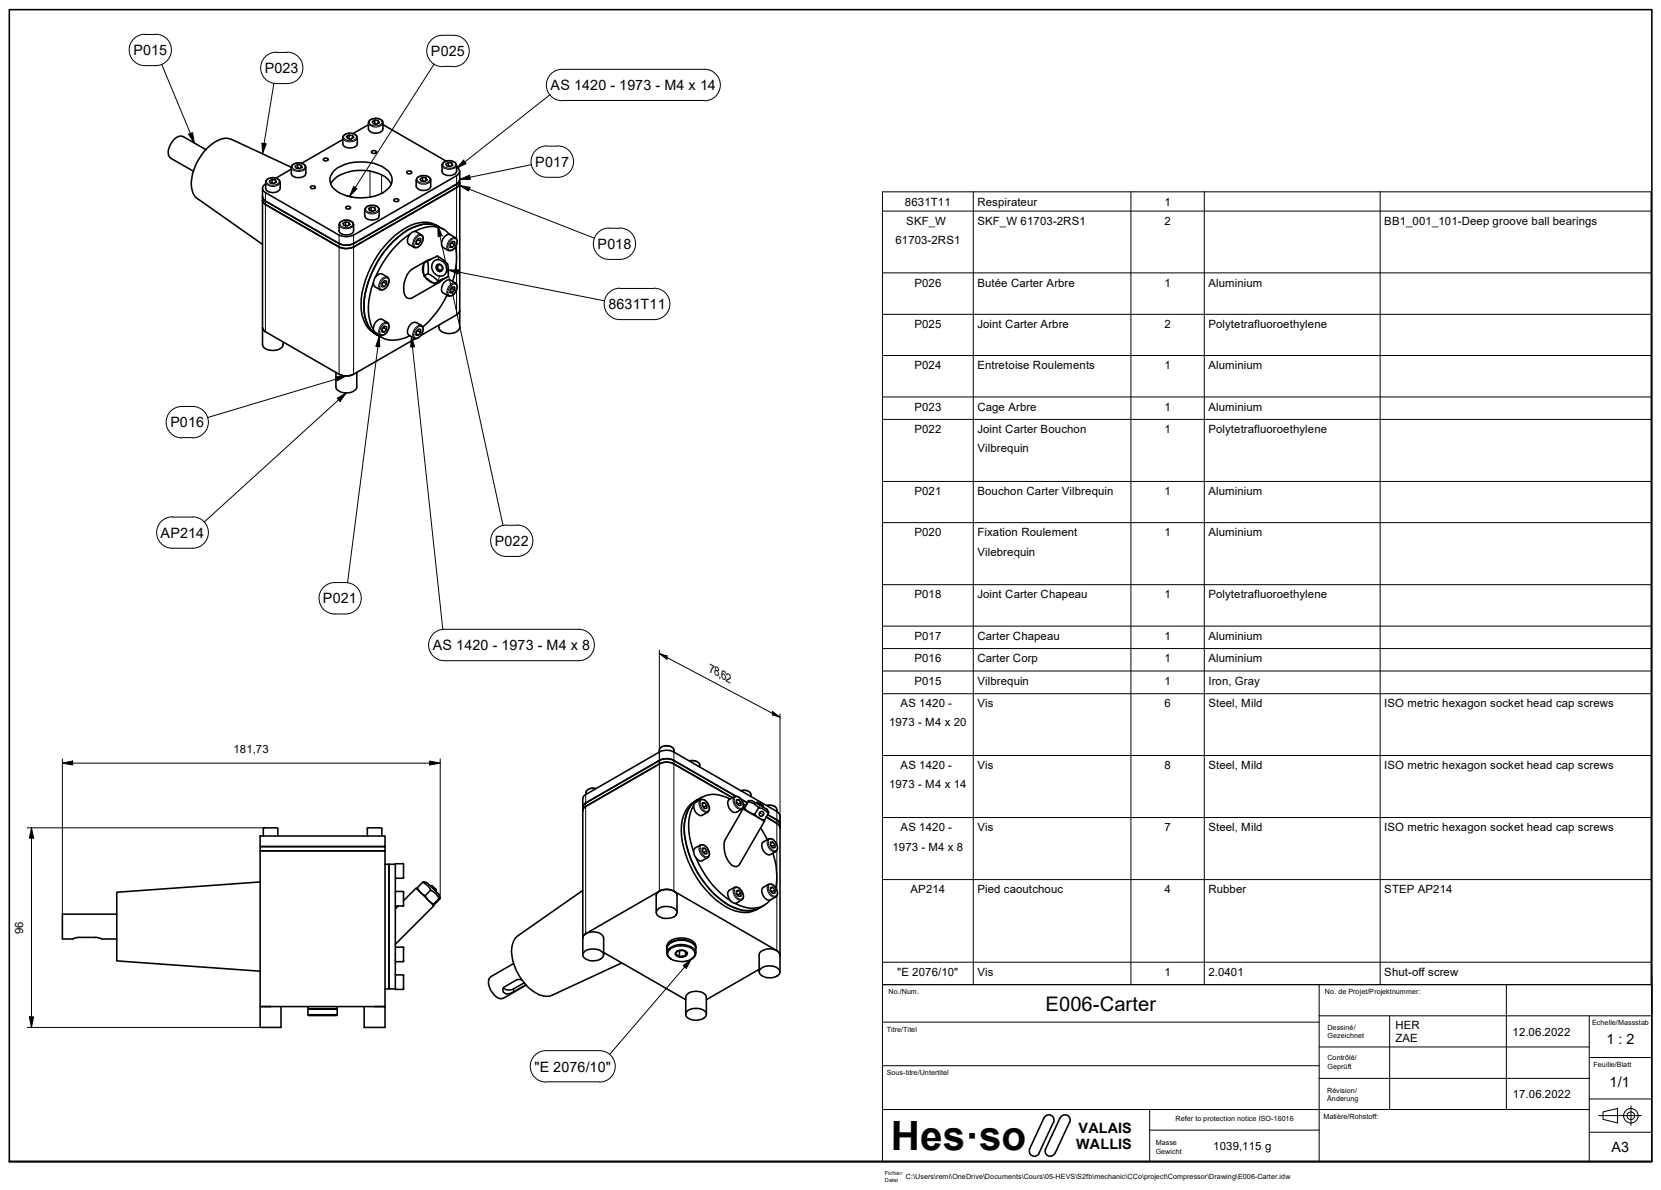
[picture p48: page 1]

8631T11 | Respirateur | 1
SKF_W 61703-2RS1 | SKF_W 61703-2RS1 | 2 | | BB1_001_101-Deep groove ball bearings

P026 | Butpe Carter Arbre | 1 | Aluminium

P025 | Joint Carter Arbre | 2 | Polytetrafluoroethylene

P024 | Entretoise Roulements | 1 | Aluminium

P023 | Cage Arbre | 1 | Aluminium

P022 | Joint Carter Bouchon Vilbrequin | 1 | Polytetrafluoroethylene

P021 | Bouchon Carter Vilbrequin | 1 | Aluminium

P020 | Fixation Roulement Vilebrequin | 1 | Aluminium

P016 | Carter Corp | 1 | Aluminium

P015 | Vilbrequin | 1 | Iron, Gray

AS 1420 -1973 - M4 x 20 | Vis | 6 | Steel, Mild | ISO metric hexagon socket head cap screws

AS 1420 -1973 - M4 x 14 | Vis | 8 | Steel, Mild | ISO metric hexagon socket head cap screws

AS 1420 -1973 - M4 x 8 | Vis | 7 | Steel, Mild | ISO metric hexagon socket head cap screws

AP214 | Pied caoutchouc | 4 | Rubber | STEP AP214

"E 2076/10" | Vis | 1 | 2.0401 | Shut-off screw
No./Num. E006-Carter | No. de Projet/Projektnummer:

Dessinp/ Gezeichnet | HER ZAE | 12.06.2022 | Echelle/Massstab 1 : 2

Contr{lp/ Geprüft

Rpvision/ bnderung | | 17.06.2022

Hesso VALAIS WALLIS | R | Matiqre/Rohstoff: efer to protection notice ISO-16016

Masse 1039,115 g Gewicht | | A3
