Klagarge/Compressor/PDF/P003-Corps_piston.pdf

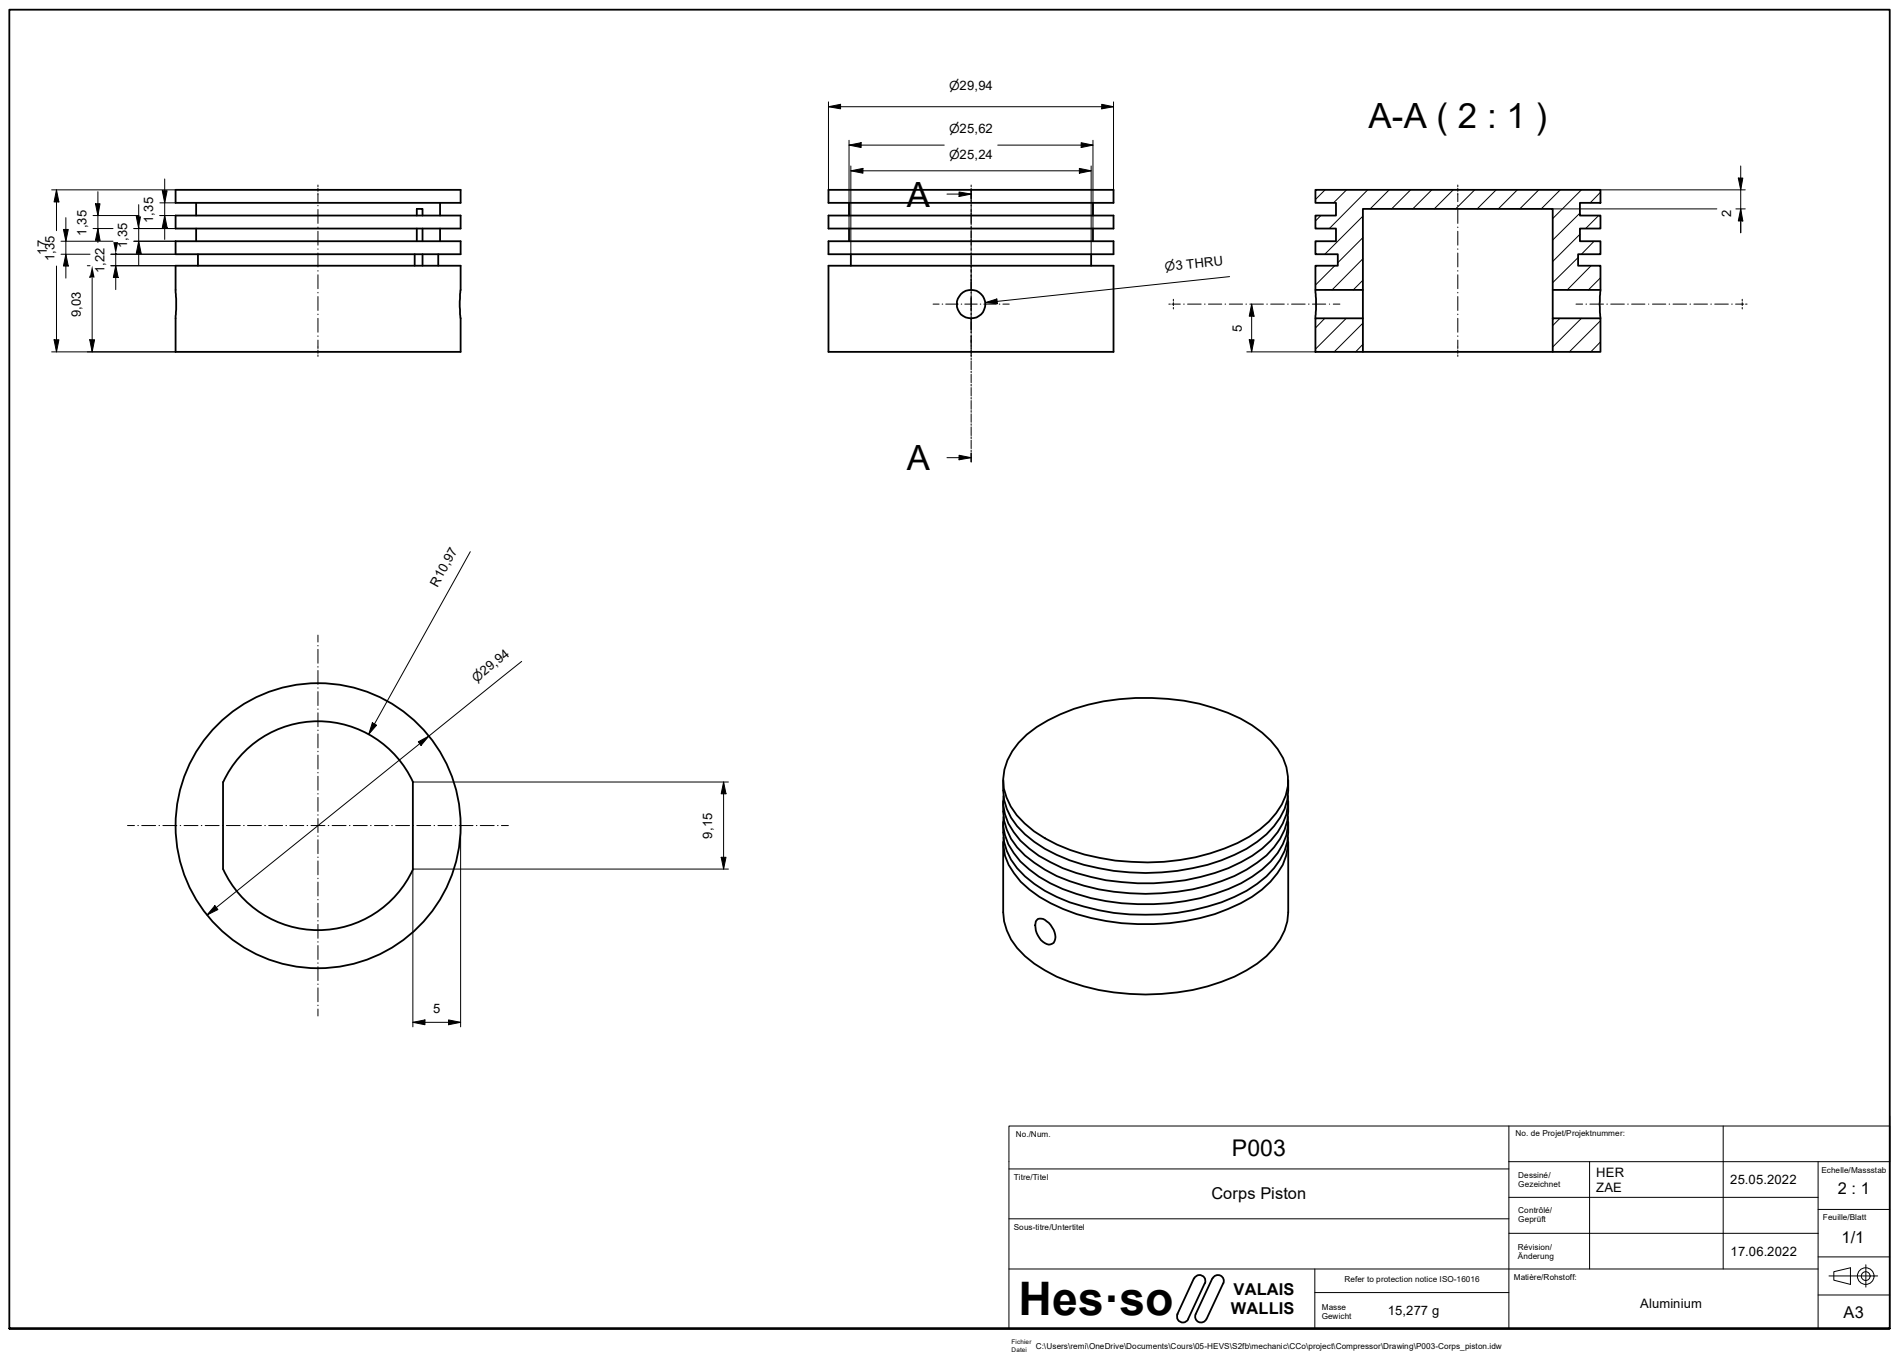
[picture p49: page 1]
Corps Piston

No./Num. P003 | No. de Projet/Projektnummer:

Dessinp/ Gezeichnet | HER ZAE | 25.05.2022 | Echelle/Massstab 2 : 1

Contr{lp/ Geprüft

Sous-titre/Untertitel

Rpvision/ bnderung | | 17.06.2022

Hesso VALAIS WALLIS | Refer to protection notice ISO-16016 | Matiqre/Rohstoff: Aluminium

Masse 15,277 g Gewicht | | A3
