Klagarge/Compressor/PDF/P005-Axe_piston.pdf

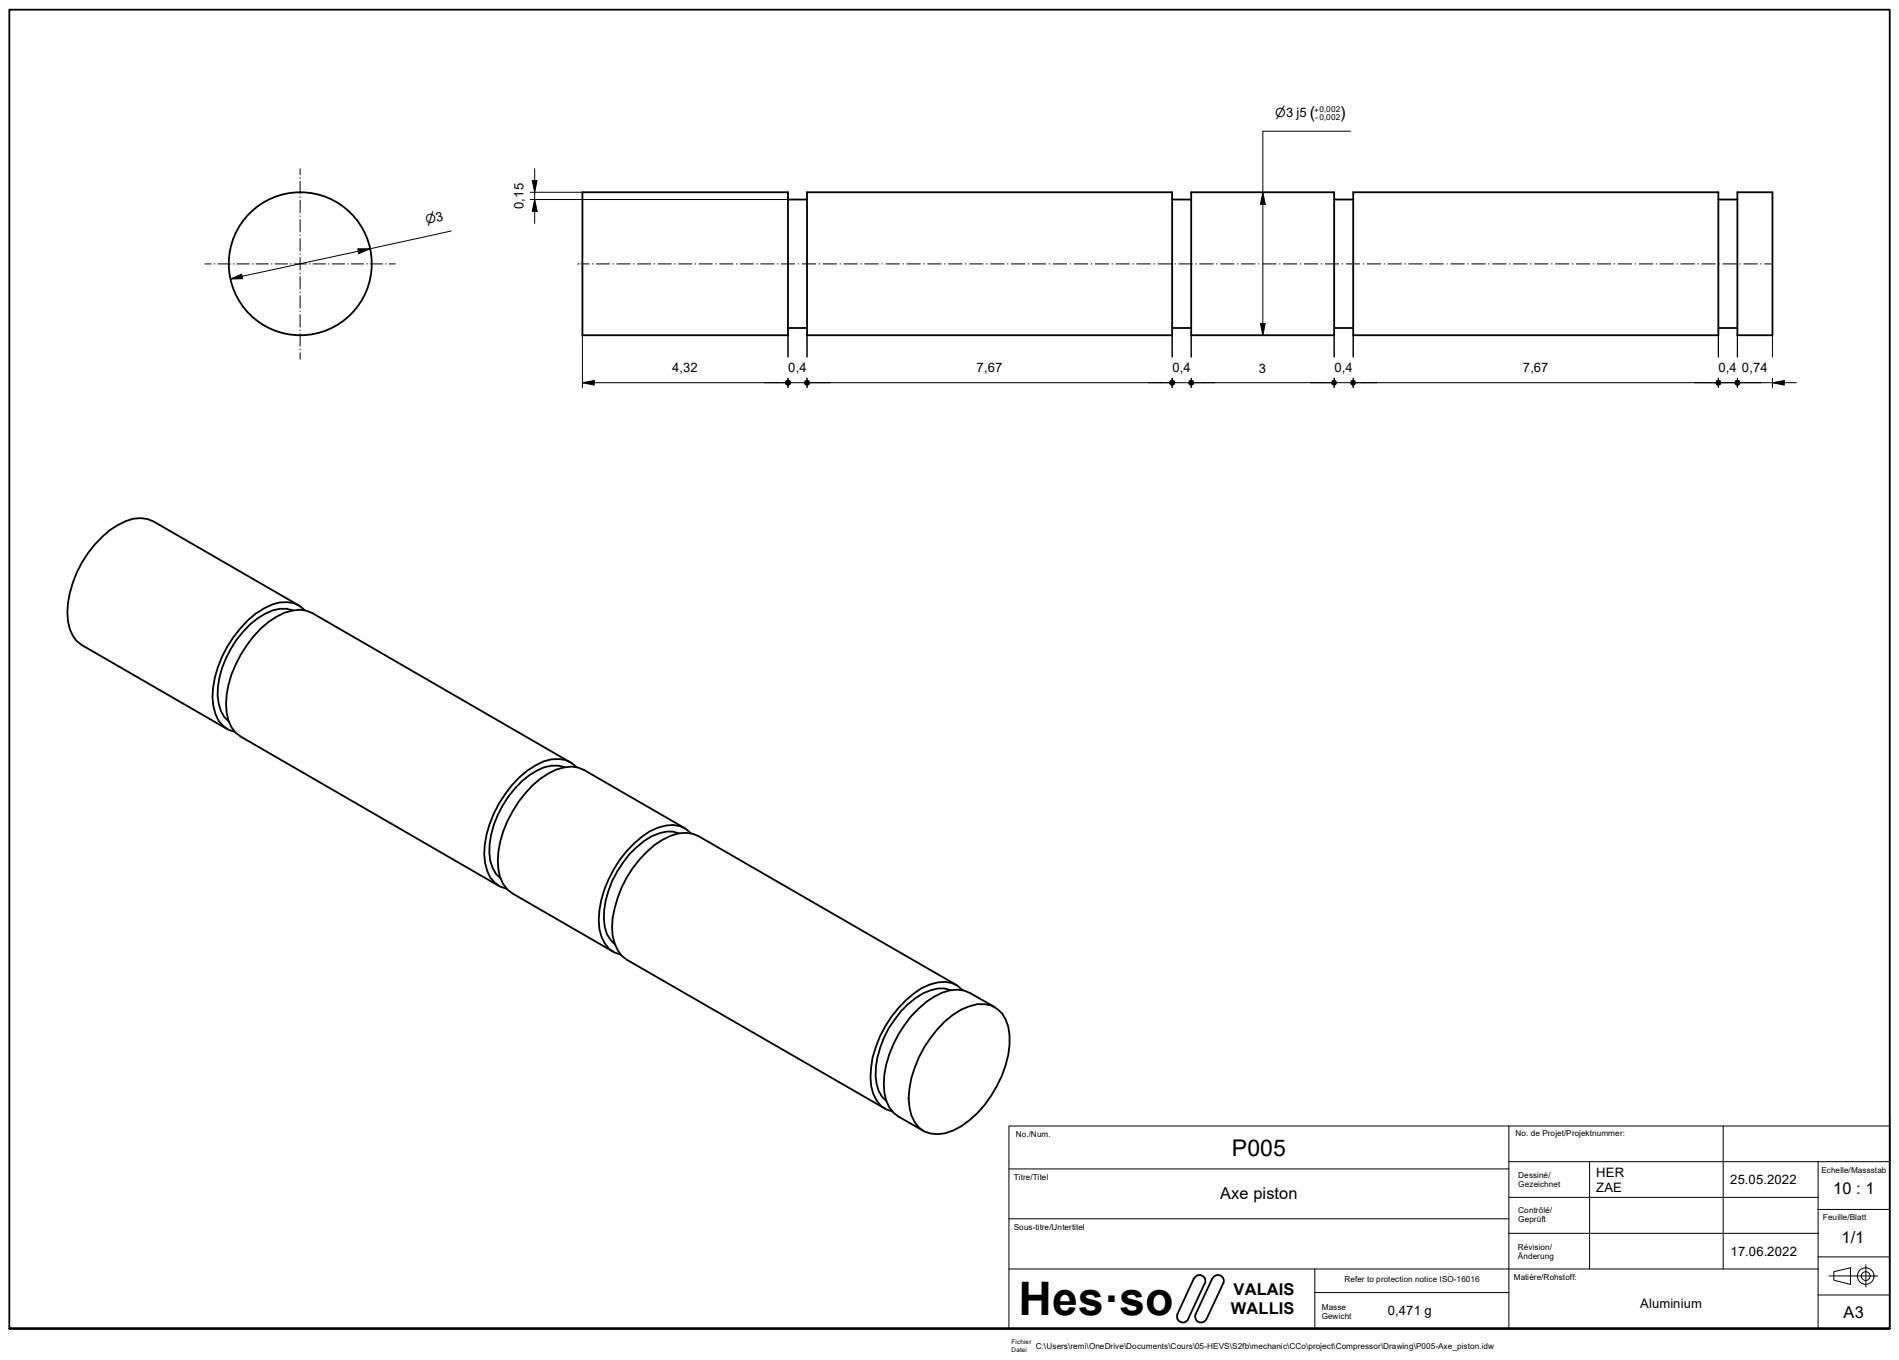
[picture p50: page 1]
Axe piston

No./Num. P005 | No. de Projet/Projektnummer:

Dessinp/ Gezeichnet | HER ZAE | 25.05.2022 | Echelle/Massstab 10 : 1

Contr{lp/ Geprüft

Sous-titre/Untertitel

Rpvision/ bnderung | | 17.06.2022

Hesso VALAIS WALLIS | Refer to protection notice ISO-16016 | Matiqre/Rohstoff: Aluminium

Masse 0,471 g Gewicht | | A3
