Klagarge/Compressor/PDF/P006-Soupape_IN.pdf

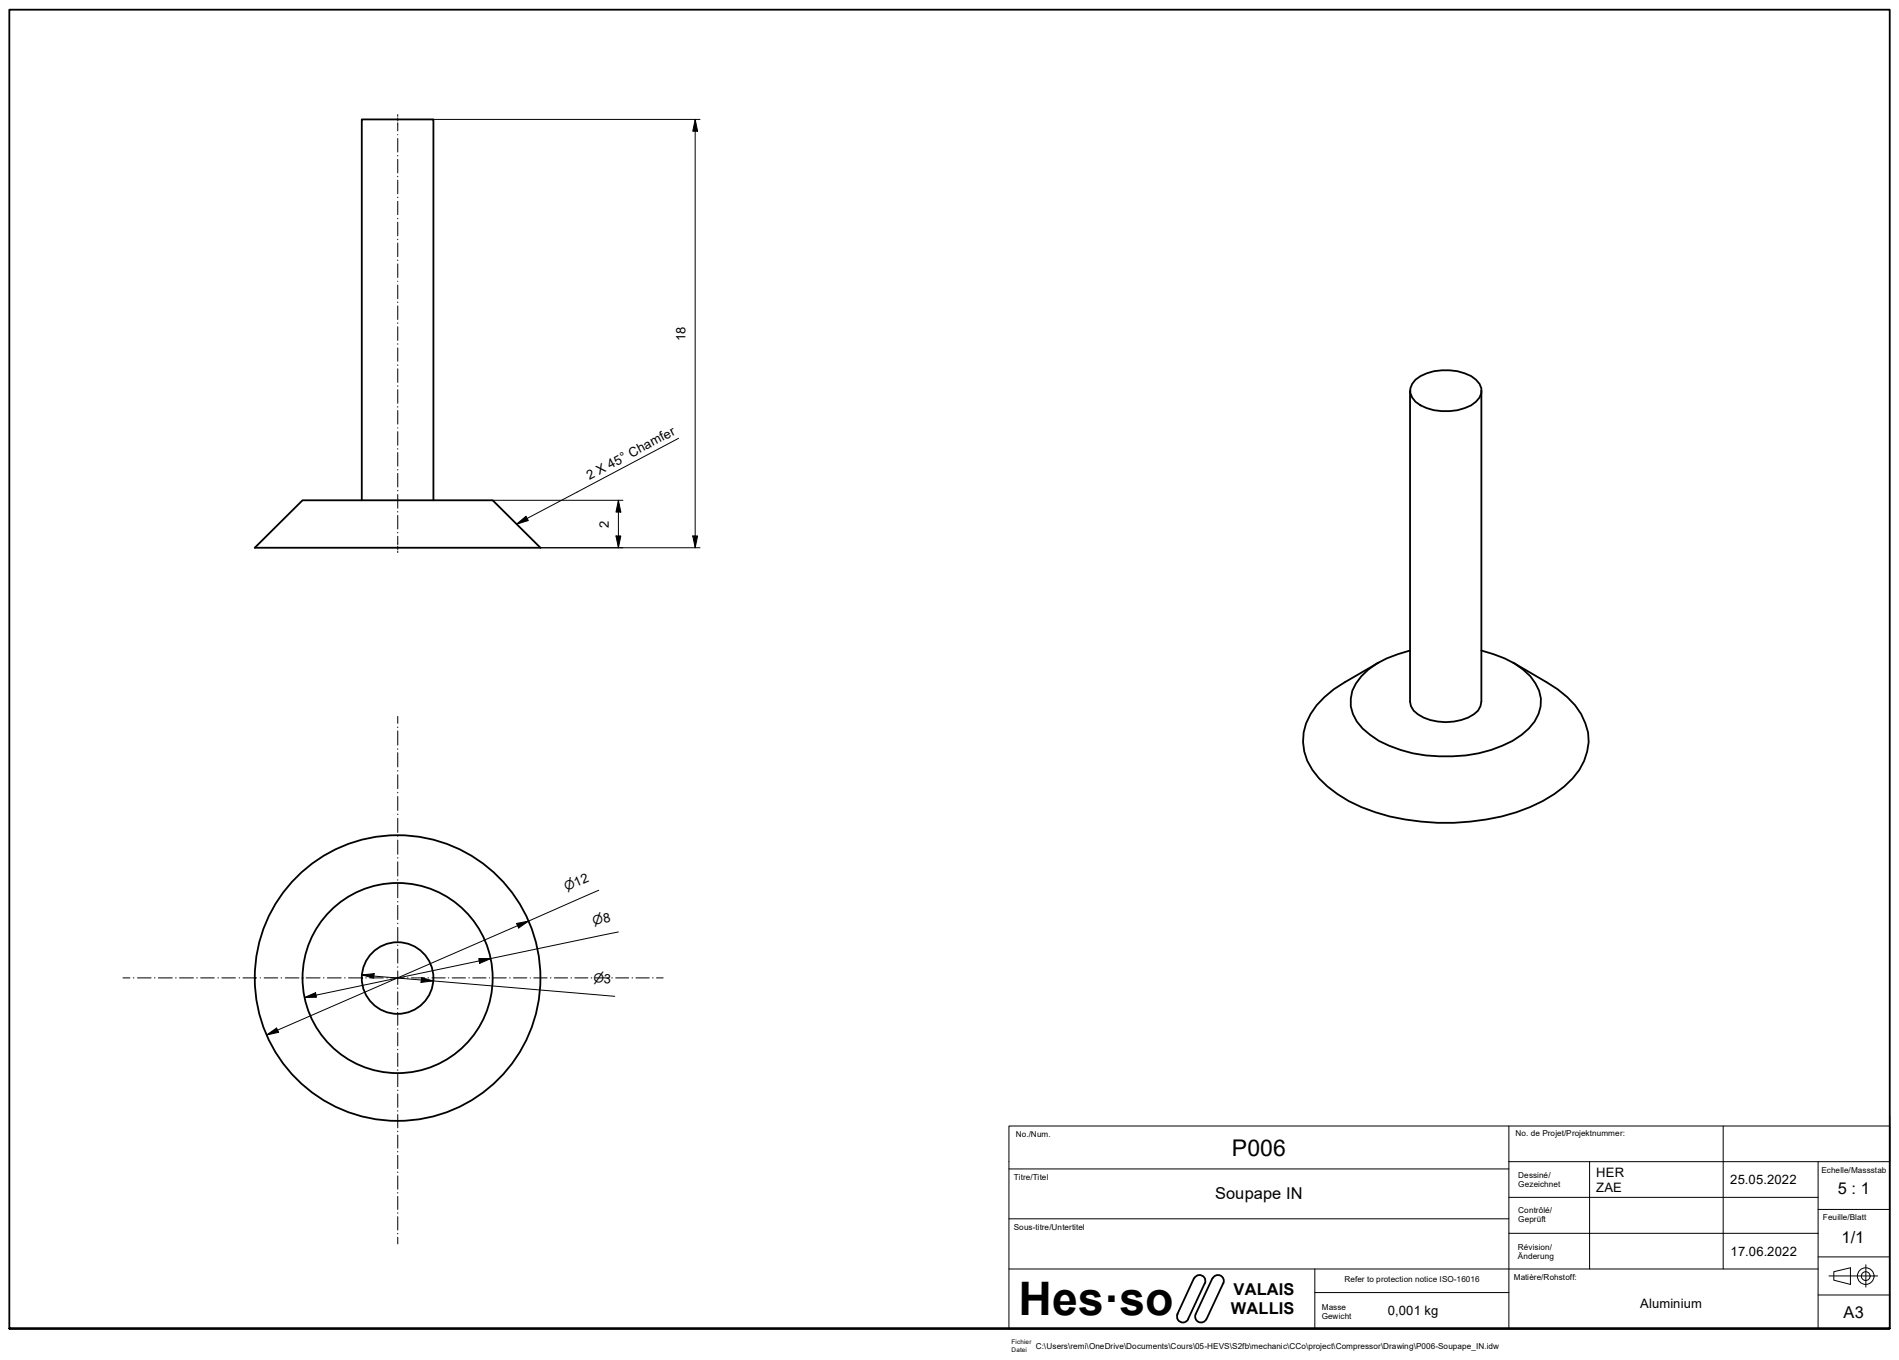
[picture p51: page 1]
Soupape IN; 2 X 45° Chamfer

No./Num. P006 | No. de Projet/Projektnummer:

Dessinp/ Gezeichnet | HER ZAE | 25.05.2022 | Echelle/Massstab 5 : 1

Contr{lp/ Geprüft

Sous-titre/Untertitel

Rpvision/ bnderung | | 17.06.2022

Hesso VALAIS WALLIS | Refer to protection notice ISO-16016 | Matiqre/Rohstoff: Aluminium

Masse 0,001 kg Gewicht | | A3
