Klagarge/Compressor/PDF/P018-Joint_carter_chapeau.pdf

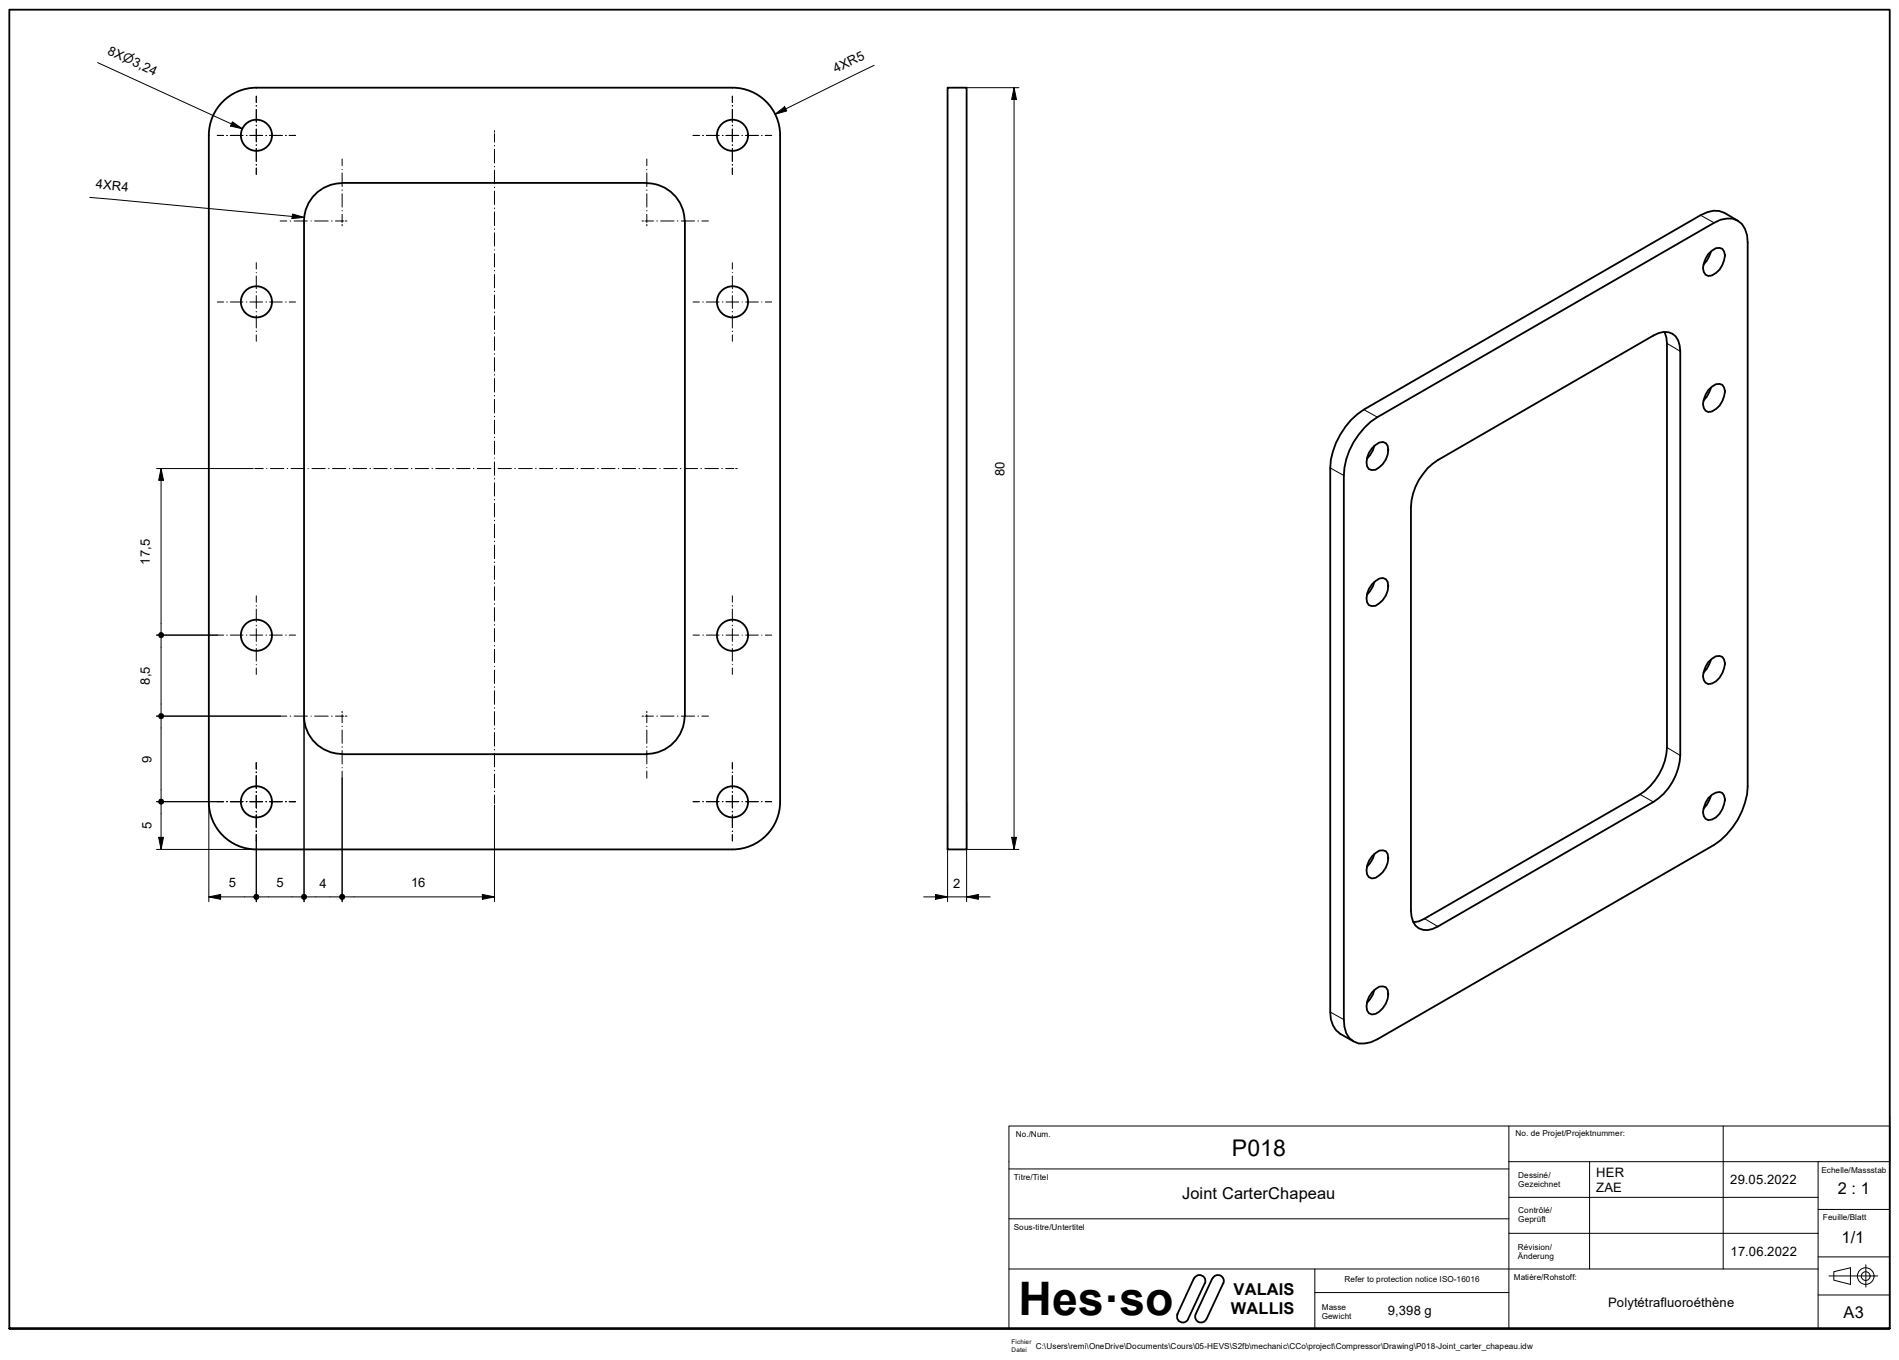
[picture p52: page 1]
Joint CarterChapeau

No./Num. P018 | No. de Projet/Projektnummer:

Dessinp/ Gezeichnet | HER ZAE | 29.05.2022 | Echelle/Massstab 2 : 1

Contr{lp/ Geprüft

Sous-titre/Untertitel

Rpvision/ bnderung | | 17.06.2022

Hesso VALAIS WALLIS | Refer to protection notice ISO-16016 | Matiqre/Rohstoff: Polytptrafluoropthqne

Masse 9,398 g Gewicht | | A3
