Klagarge/Compressor/PDF/P022-Joint_carter_bouchon_vilbrequin.pdf

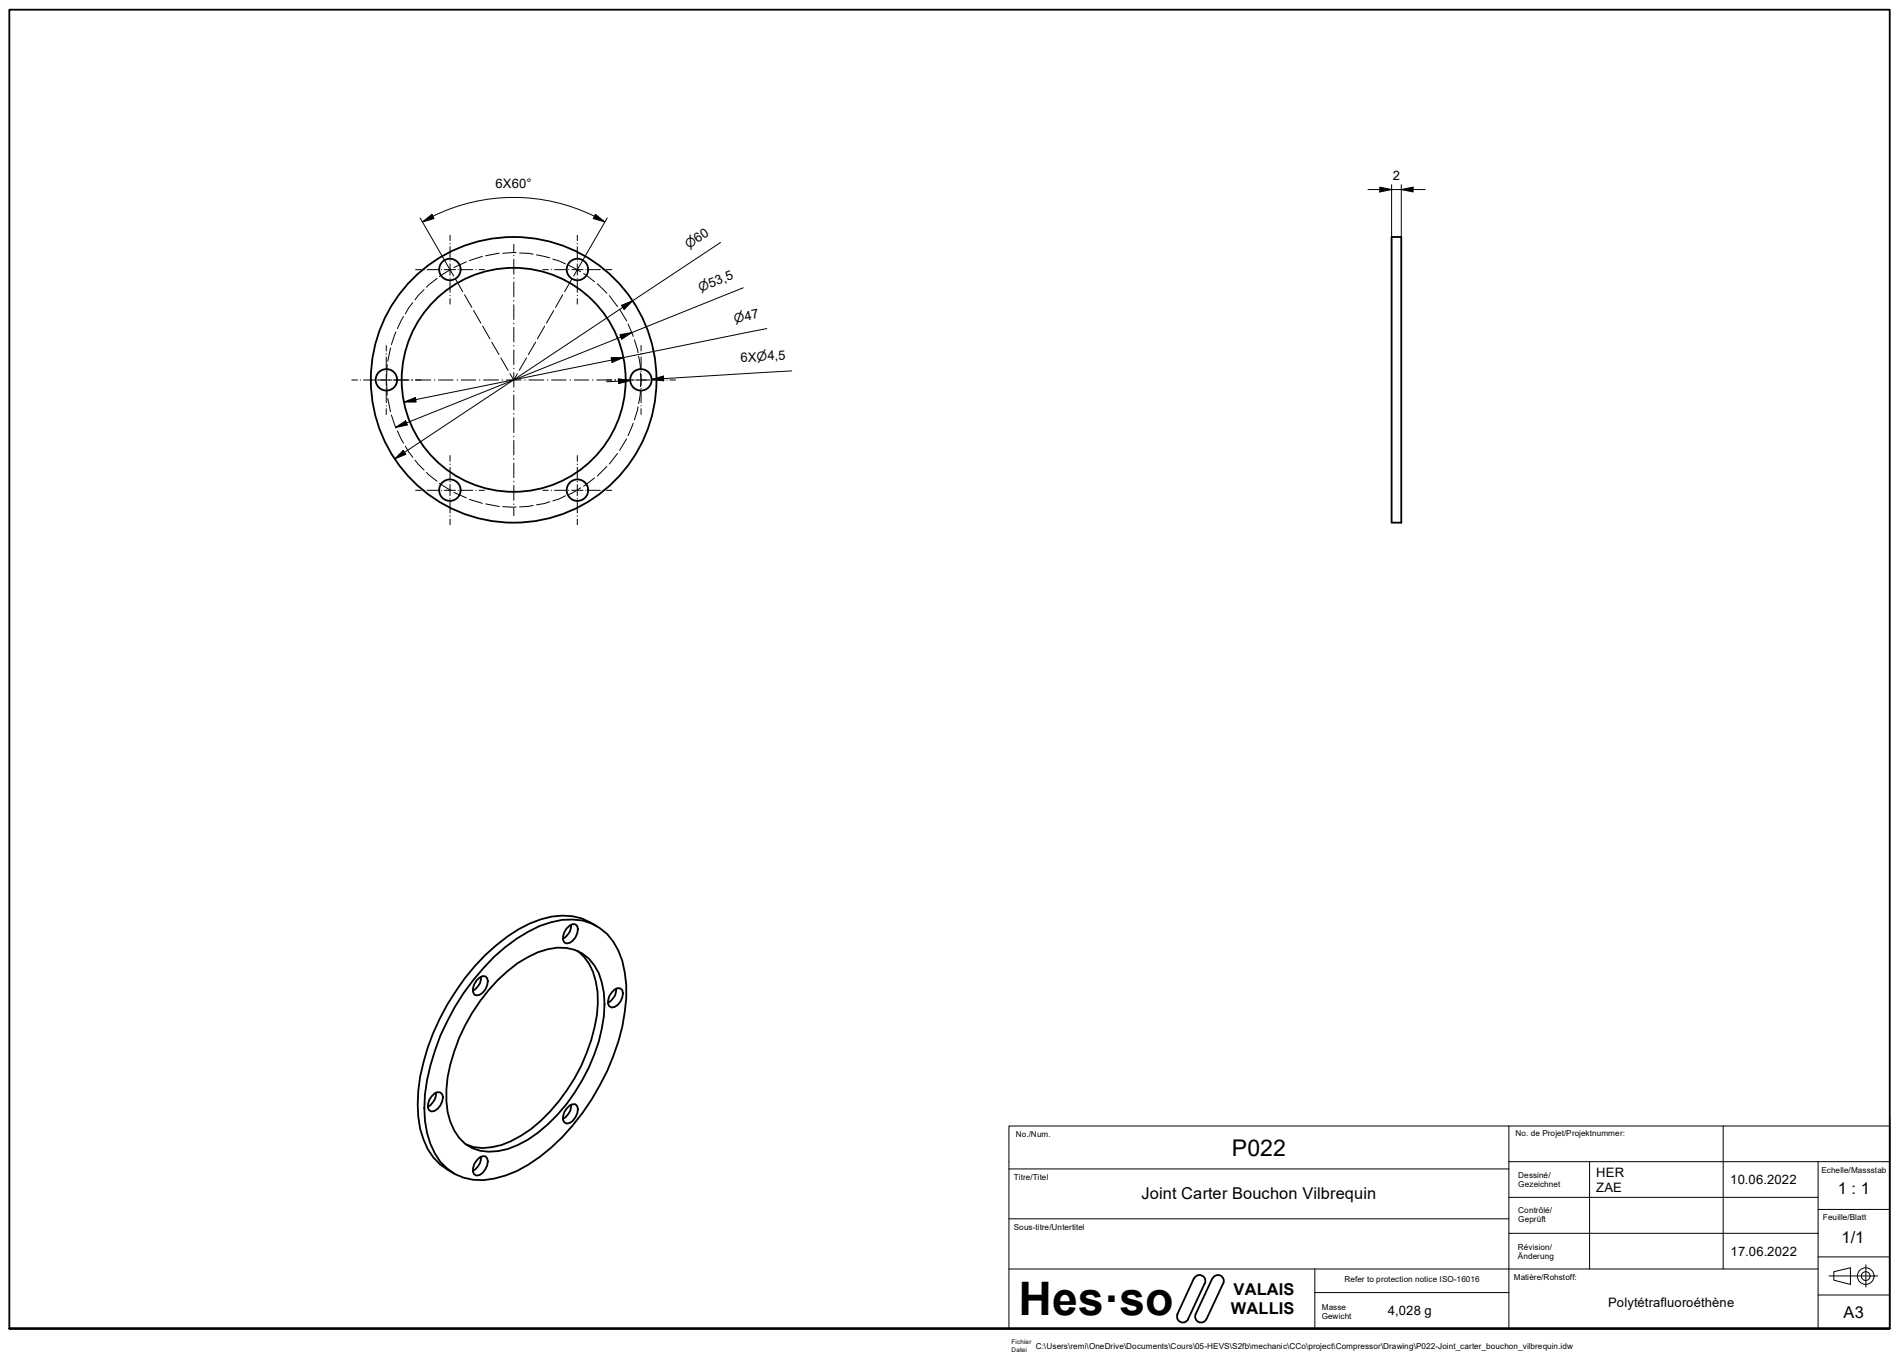
[picture p53: page 1]

No./Num. P022 | No. de Projet/Projektnummer:

Dessinp/ Gezeichnet | HER ZAE | 10.06.2022 | Echelle/Massstab 1 : 1

Joint Carter Bouchon Vilbrequin

Contr{lp/ Geprüft

Sous-titre/Untertitel

Rpvision/ bnderung | | 17.06.2022

Hesso VALAIS WALLIS | Refer to protection notice ISO-16016 | Matiqre/Rohstoff: Polytptrafluoropthqne

Masse 4,028 g Gewicht | | A3
