Klagarge/Compressor/PDF/P025-Joint_carter_arbre.pdf

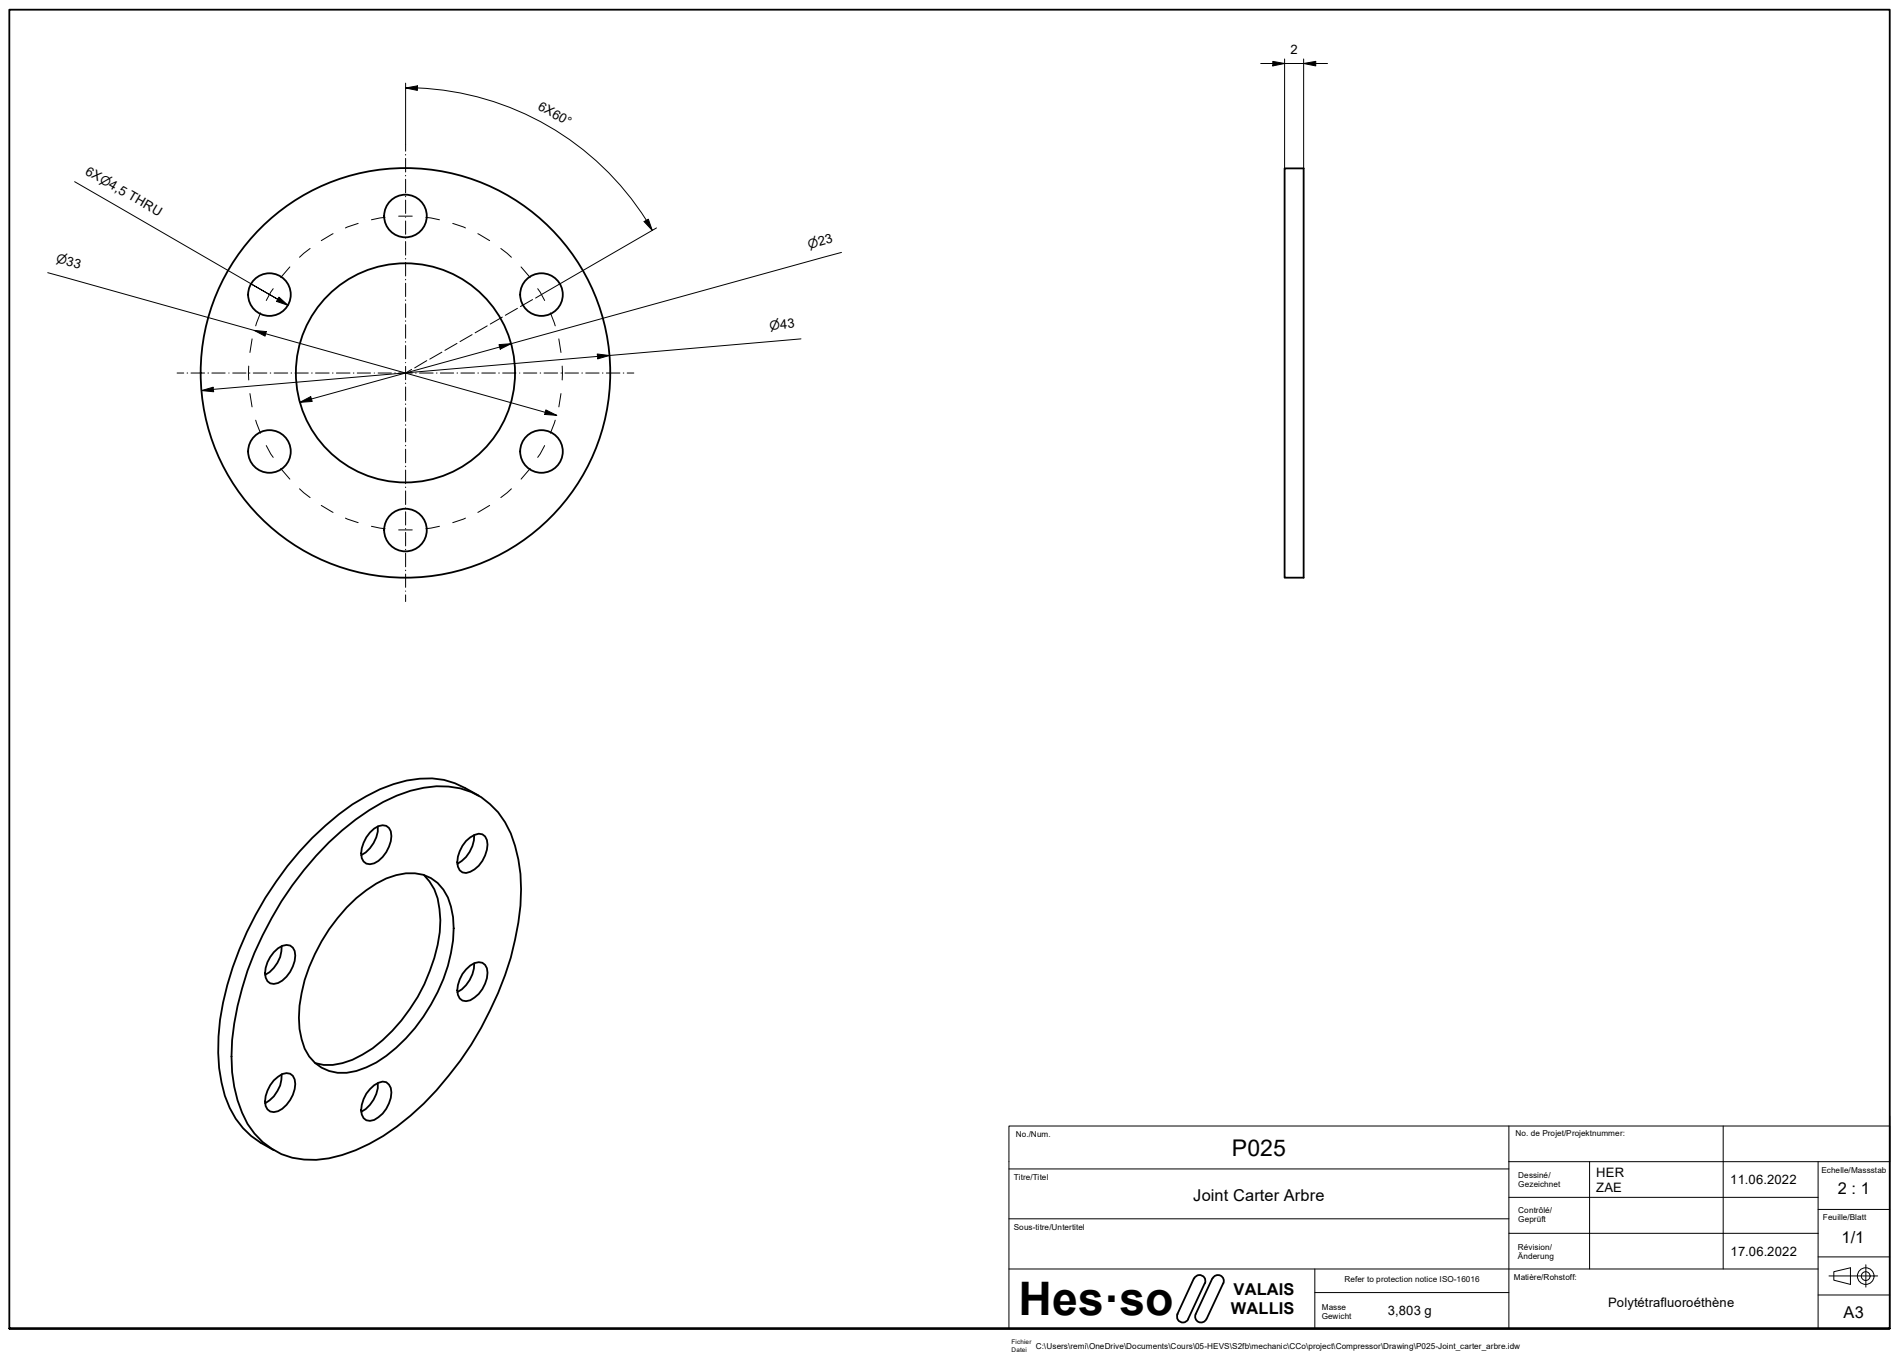
[picture p54: page 1]

No./Num. P025 | No. de Projet/Projektnummer:

Dessinp/ Gezeichnet | HER ZAE | 11.06.2022 | Echelle/Massstab 2 : 1

Joint Carter Arbre

Contr{lp/ Geprüft

Sous-titre/Untertitel

Rpvision/ bnderung | | 17.06.2022

Hesso VALAIS WALLIS | Refer to protection notice ISO-16016 | Matiqre/Rohstoff: Polytptrafluoropthqne

Masse 3,803 g Gewicht | | A3
