Klagarge/Compressor/PDF/P001-Couverture.pdf

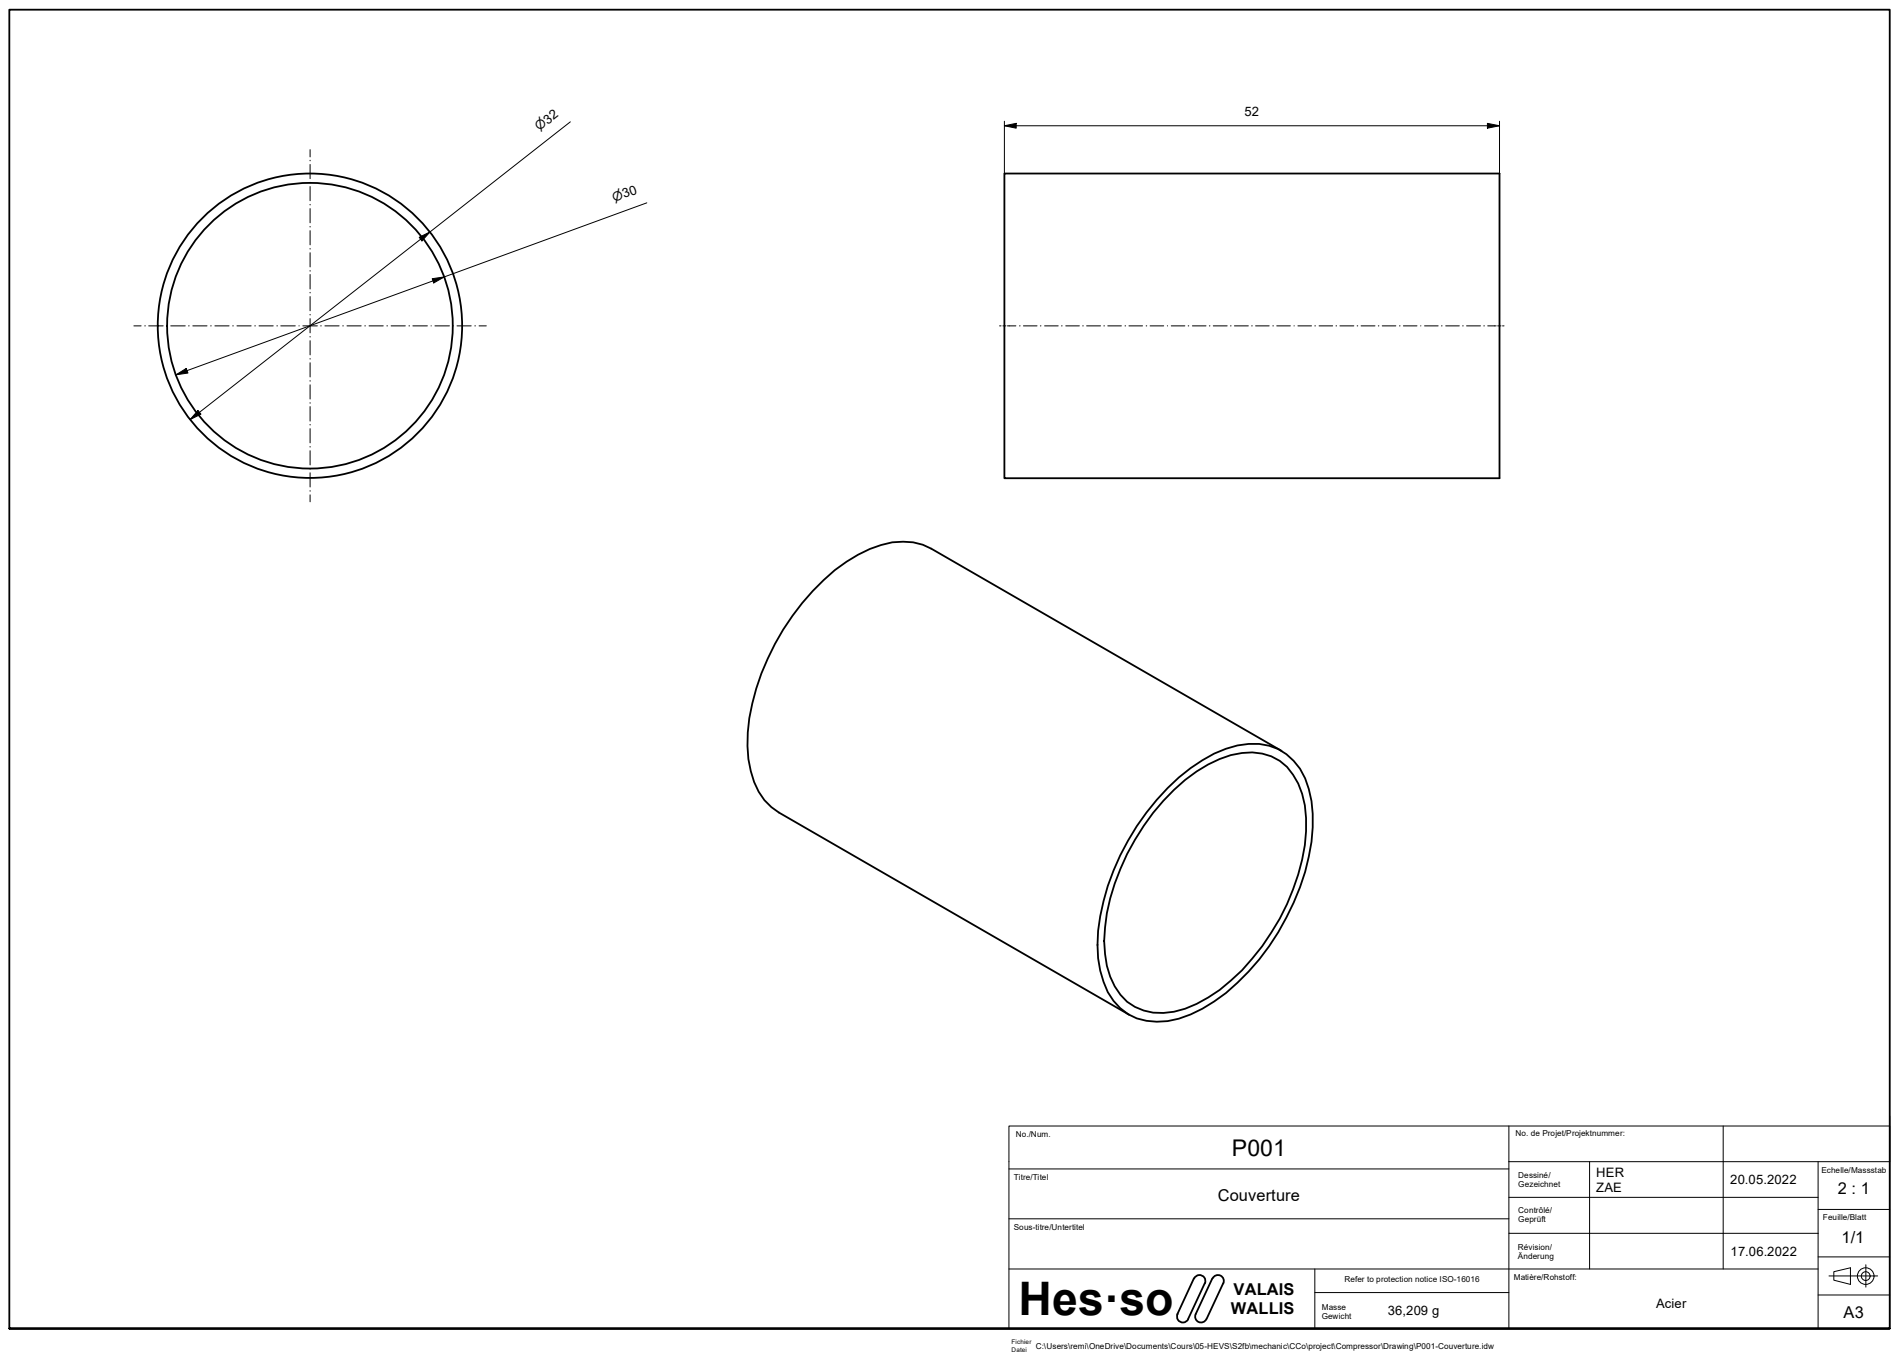
[picture p55: page 1]

No./Num. P001 | No. de Projet/Projektnummer:

Dessinp/ Gezeichnet | HER ZAE | 20.05.2022 | Echelle/Massstab 2 : 1

Contr{lp/ Geprüft

Sous-titre/Untertitel

Rpvision/ bnderung | | 17.06.2022

Hesso VALAIS WALLIS | Refer to protection notice ISO-16016 | Matiqre/Rohstoff: Acier

Masse 36,209 g Gewicht | | A3
