Klagarge/Compressor/PDF/P002-Bati_chambre.pdf

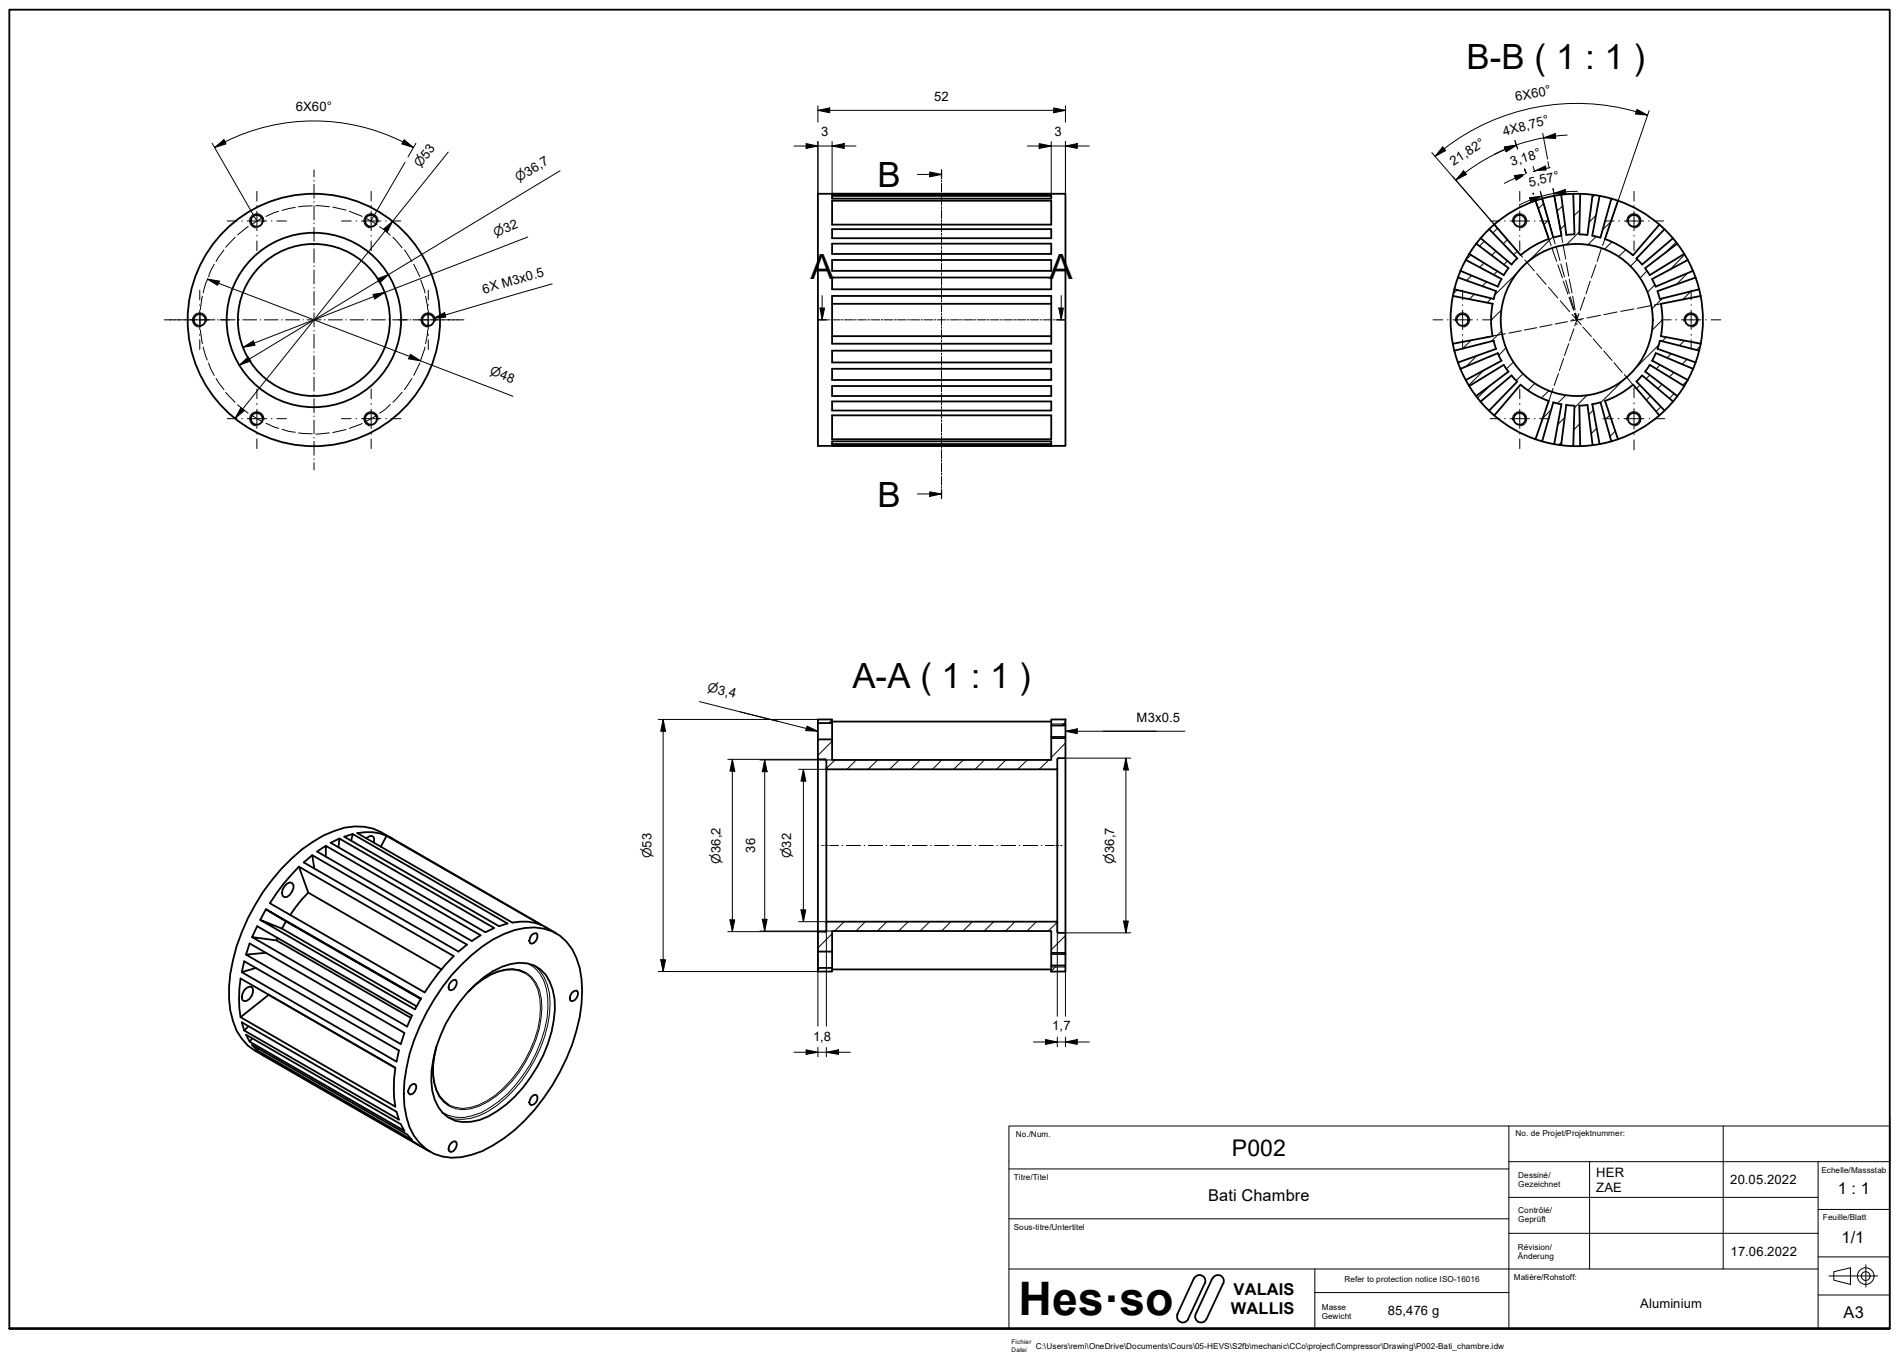
[picture p56: page 1]
Bati Chambre

No./Num. P002 | No. de Projet/Projektnummer:

Dessinp/ Gezeichnet | HER ZAE | 20.05.2022 | Echelle/Massstab 1 : 1

Contr{lp/ Geprüft

Sous-titre/Untertitel

Rpvision/ bnderung | | 17.06.2022

Hesso VALAIS WALLIS | Refer to protection notice ISO-16016 | Matiqre/Rohstoff: Aluminium

Masse 85,476 g Gewicht | | A3
