Klagarge/Compressor/PDF/P011-Chapeau_chambre.pdf

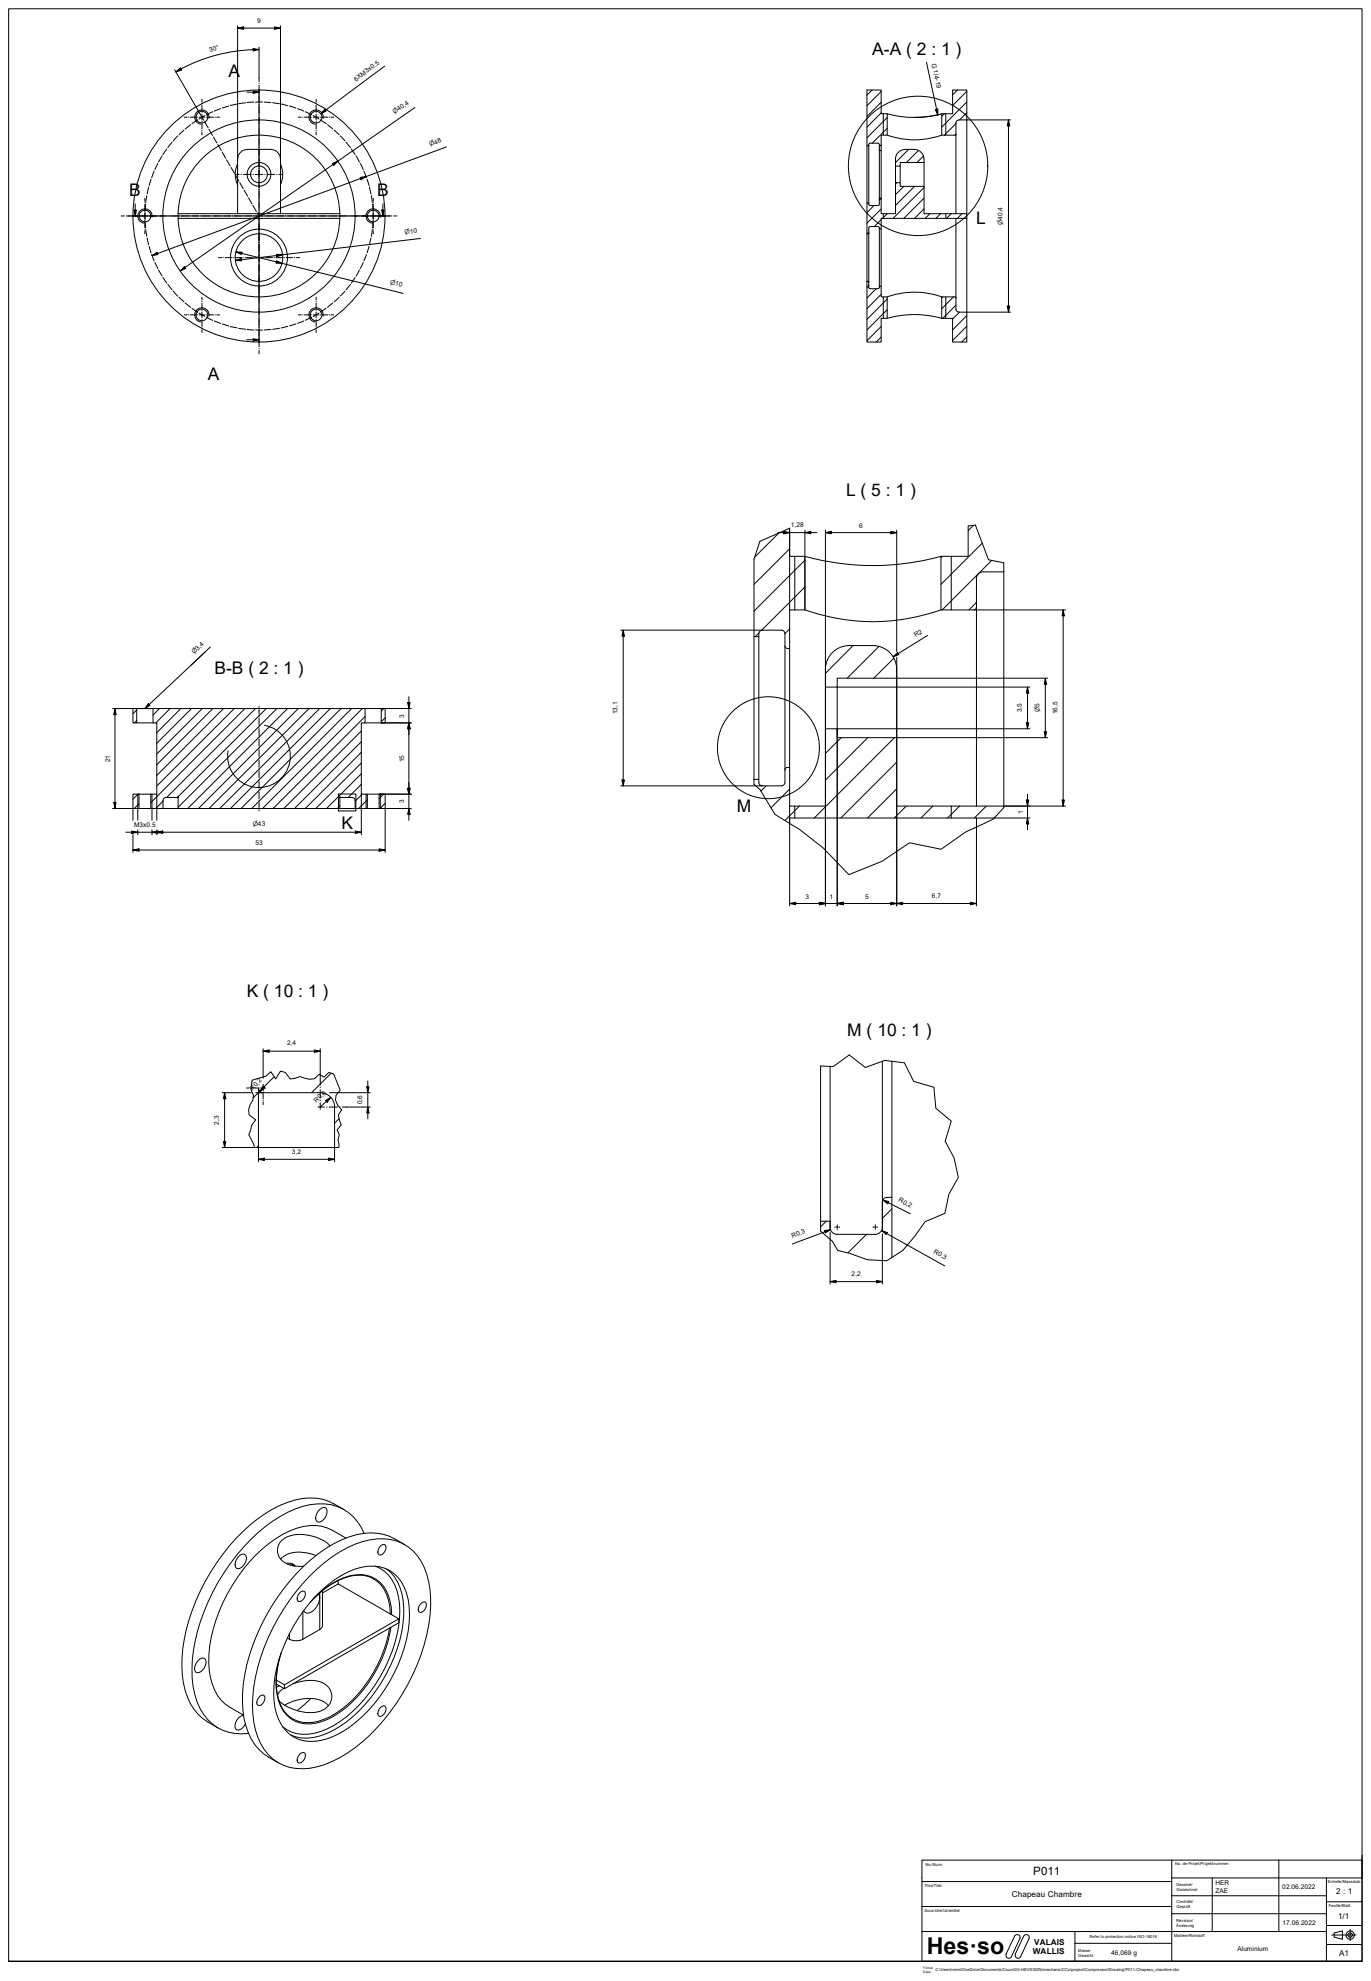
[picture p57: page 1]
Chapeau Chambre

No./Num. P011 | No. de Projet/Projektnummer:

Dessinp/ Gezeichnet | HER ZAE | 02.06.2022 | Echelle/Massstab 2 : 1

Contr{lp/ Geprüft

Sous-titre/Untertitel

Rpvision/ bnderung | | 17.06.2022

Hesso VALAIS WALLIS | Refer to protection notice ISO-16016 | Matiqre/Rohstoff: Aluminium

Masse 46,069 g Gewicht | | A1
