Klagarge/Compressor/PDF/P016-Carter_corps.pdf

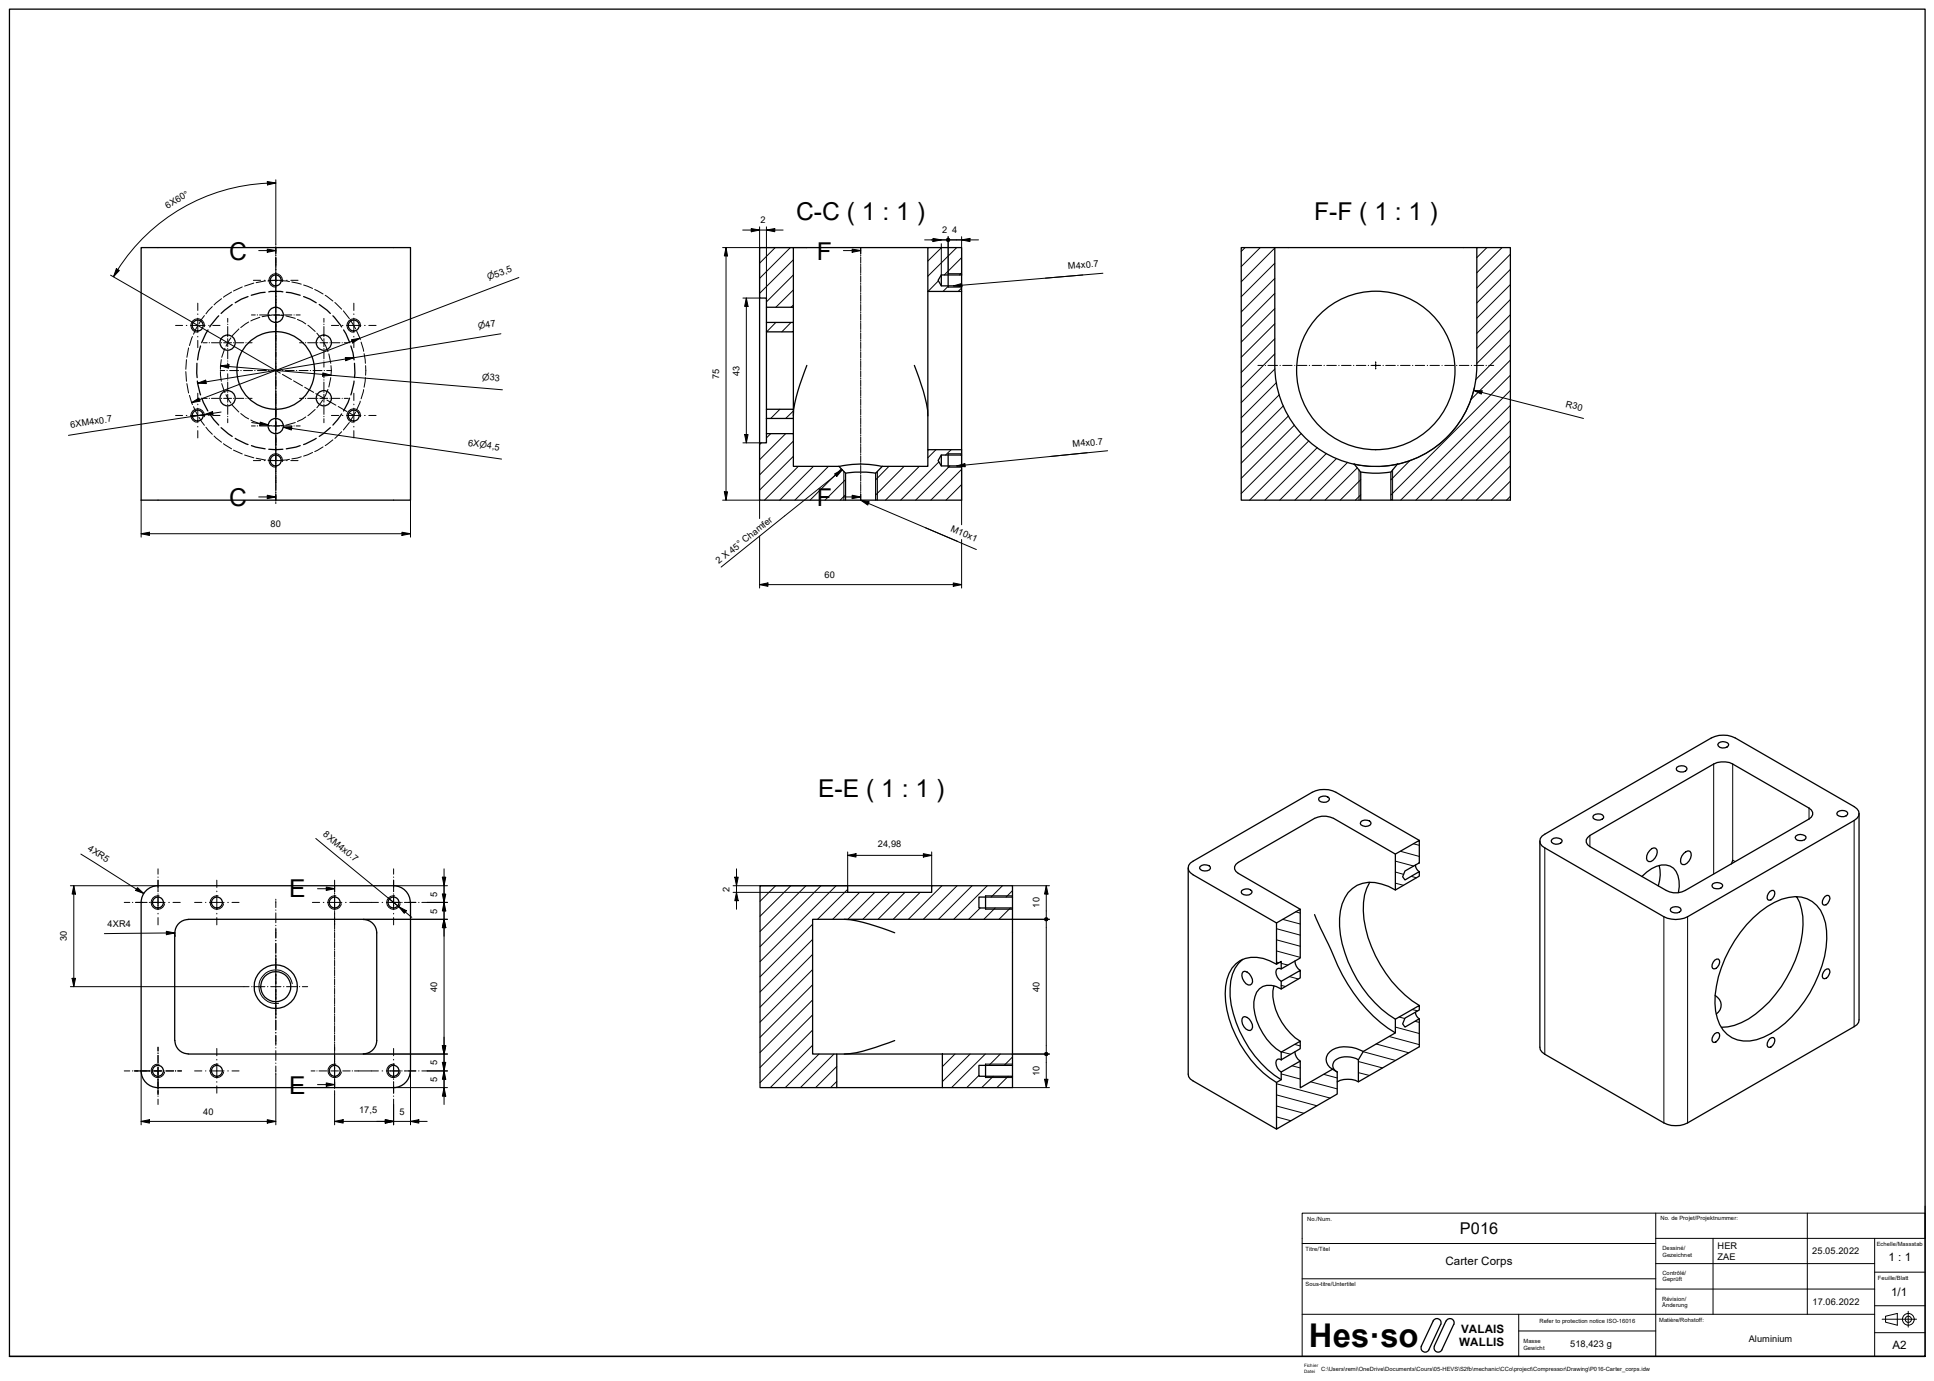
[picture p58: page 1]
Carter Corps; 2 X 45° Chamfer

No./Num. P016 | No. de Projet/Projektnummer:

Dessinp/ Gezeichnet | HER ZAE | 25.05.2022 | Echelle/Massstab 1 : 1

Contr{lp/ Geprüft

Sous-titre/Untertitel

Rpvision/ bnderung | | 17.06.2022

Hesso VALAIS WALLIS | Refer to protection notice ISO-16016 | Matiqre/Rohstoff: Aluminium

Masse 518,423 g Gewicht | | A2
