Klagarge/Compressor/PDF/P019-Chapeau_tete_chambre.pdf

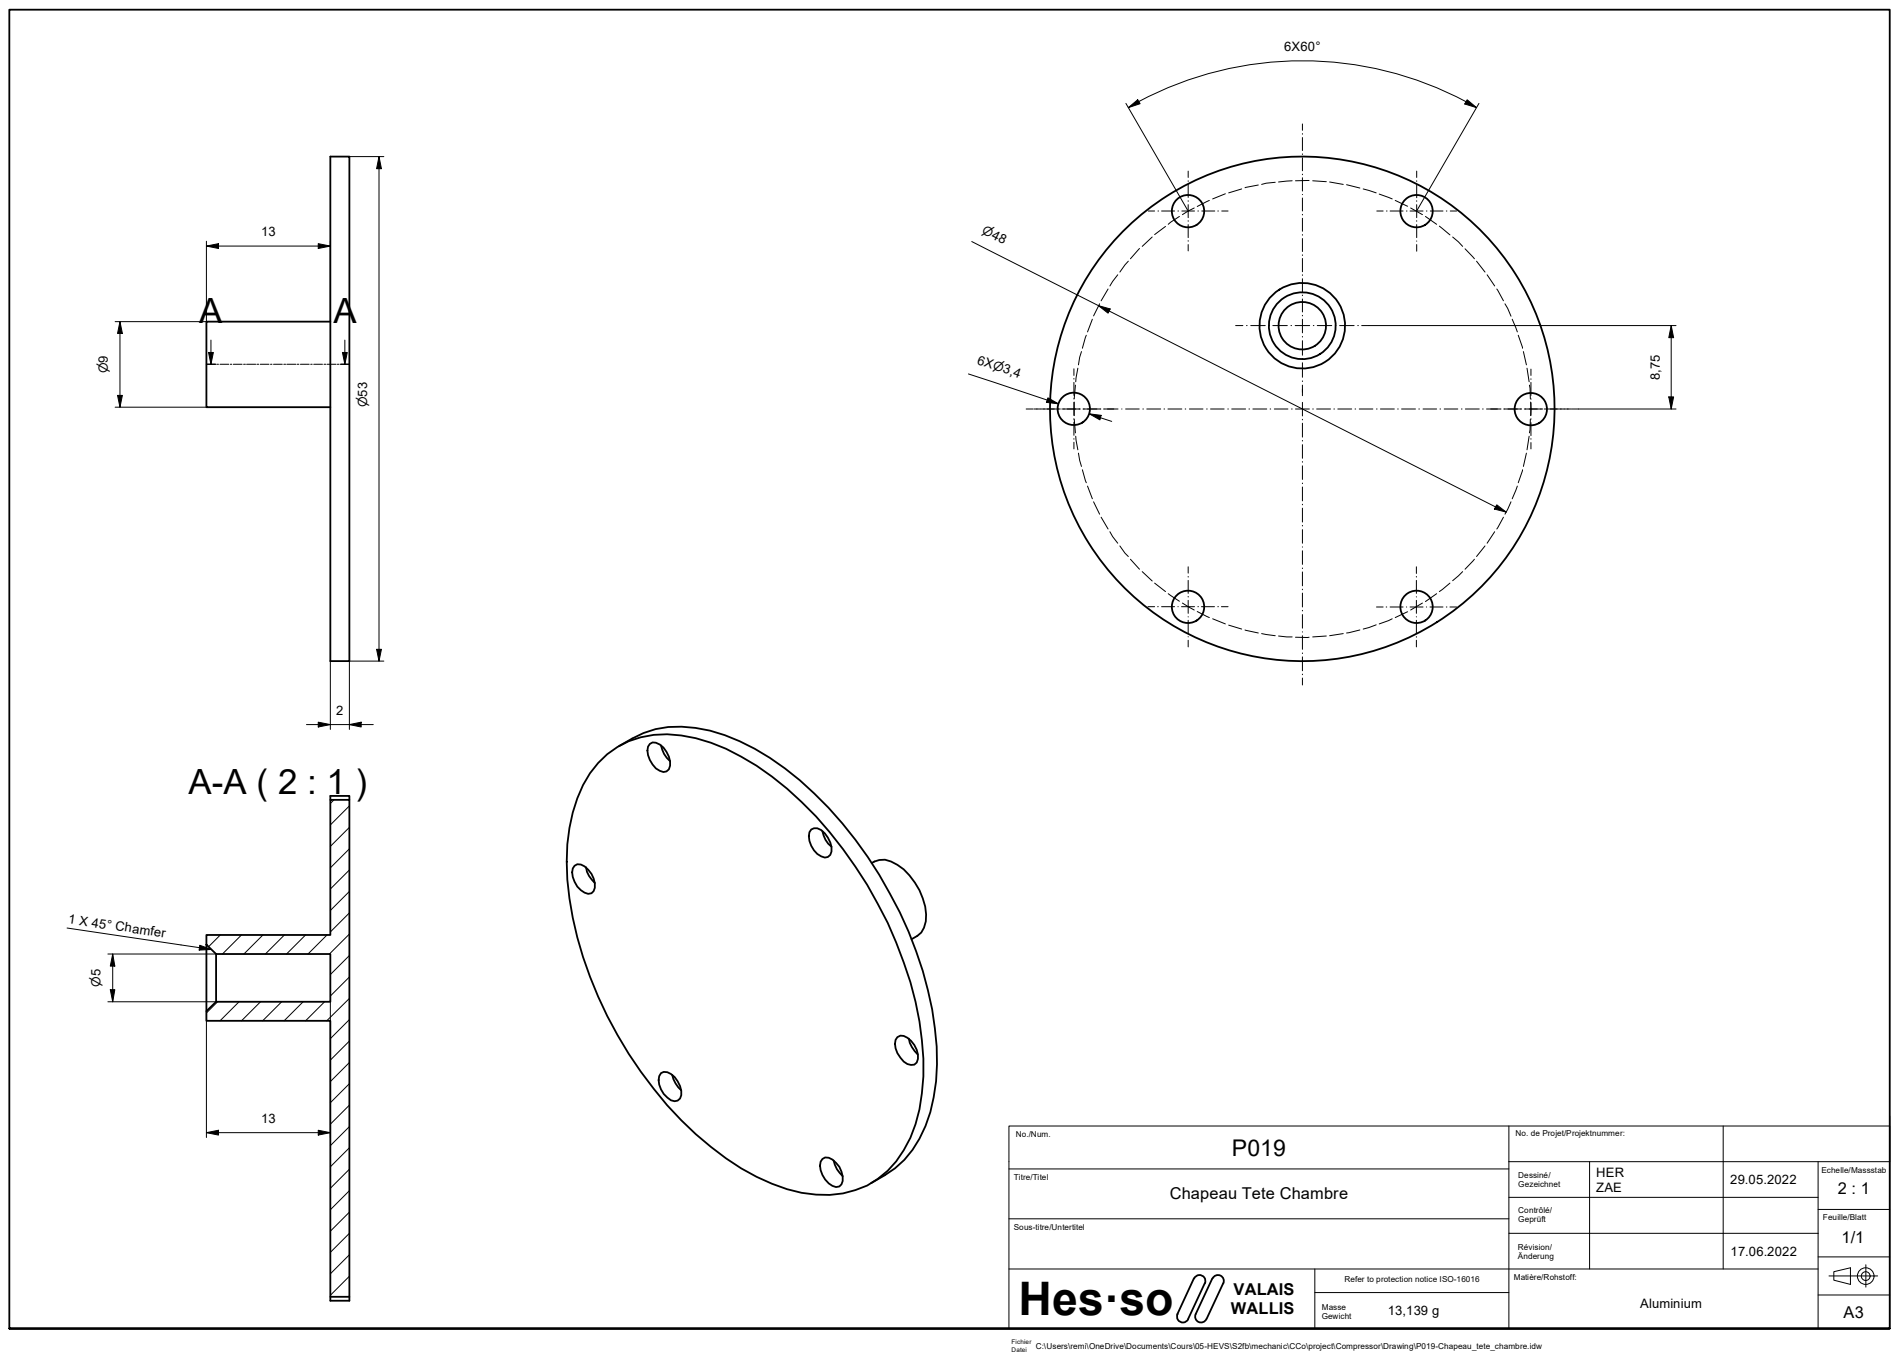
[picture p59: page 1]
1 X 45° Chamfer

No./Num. P019 | No. de Projet/Projektnummer:

Dessinp/ Gezeichnet | HER ZAE | 29.05.2022 | Echelle/Massstab 2 : 1

Chapeau Tete Chambre

Contr{lp/ Geprüft

Sous-titre/Untertitel

Rpvision/ bnderung | | 17.06.2022

Hesso VALAIS WALLIS | Refer to protection notice ISO-16016 | Matiqre/Rohstoff: Aluminium

Masse 13,139 g Gewicht | | A3
