Klagarge/Compressor/PDF/P020-Fixation_roulement_vilebrequin.pdf

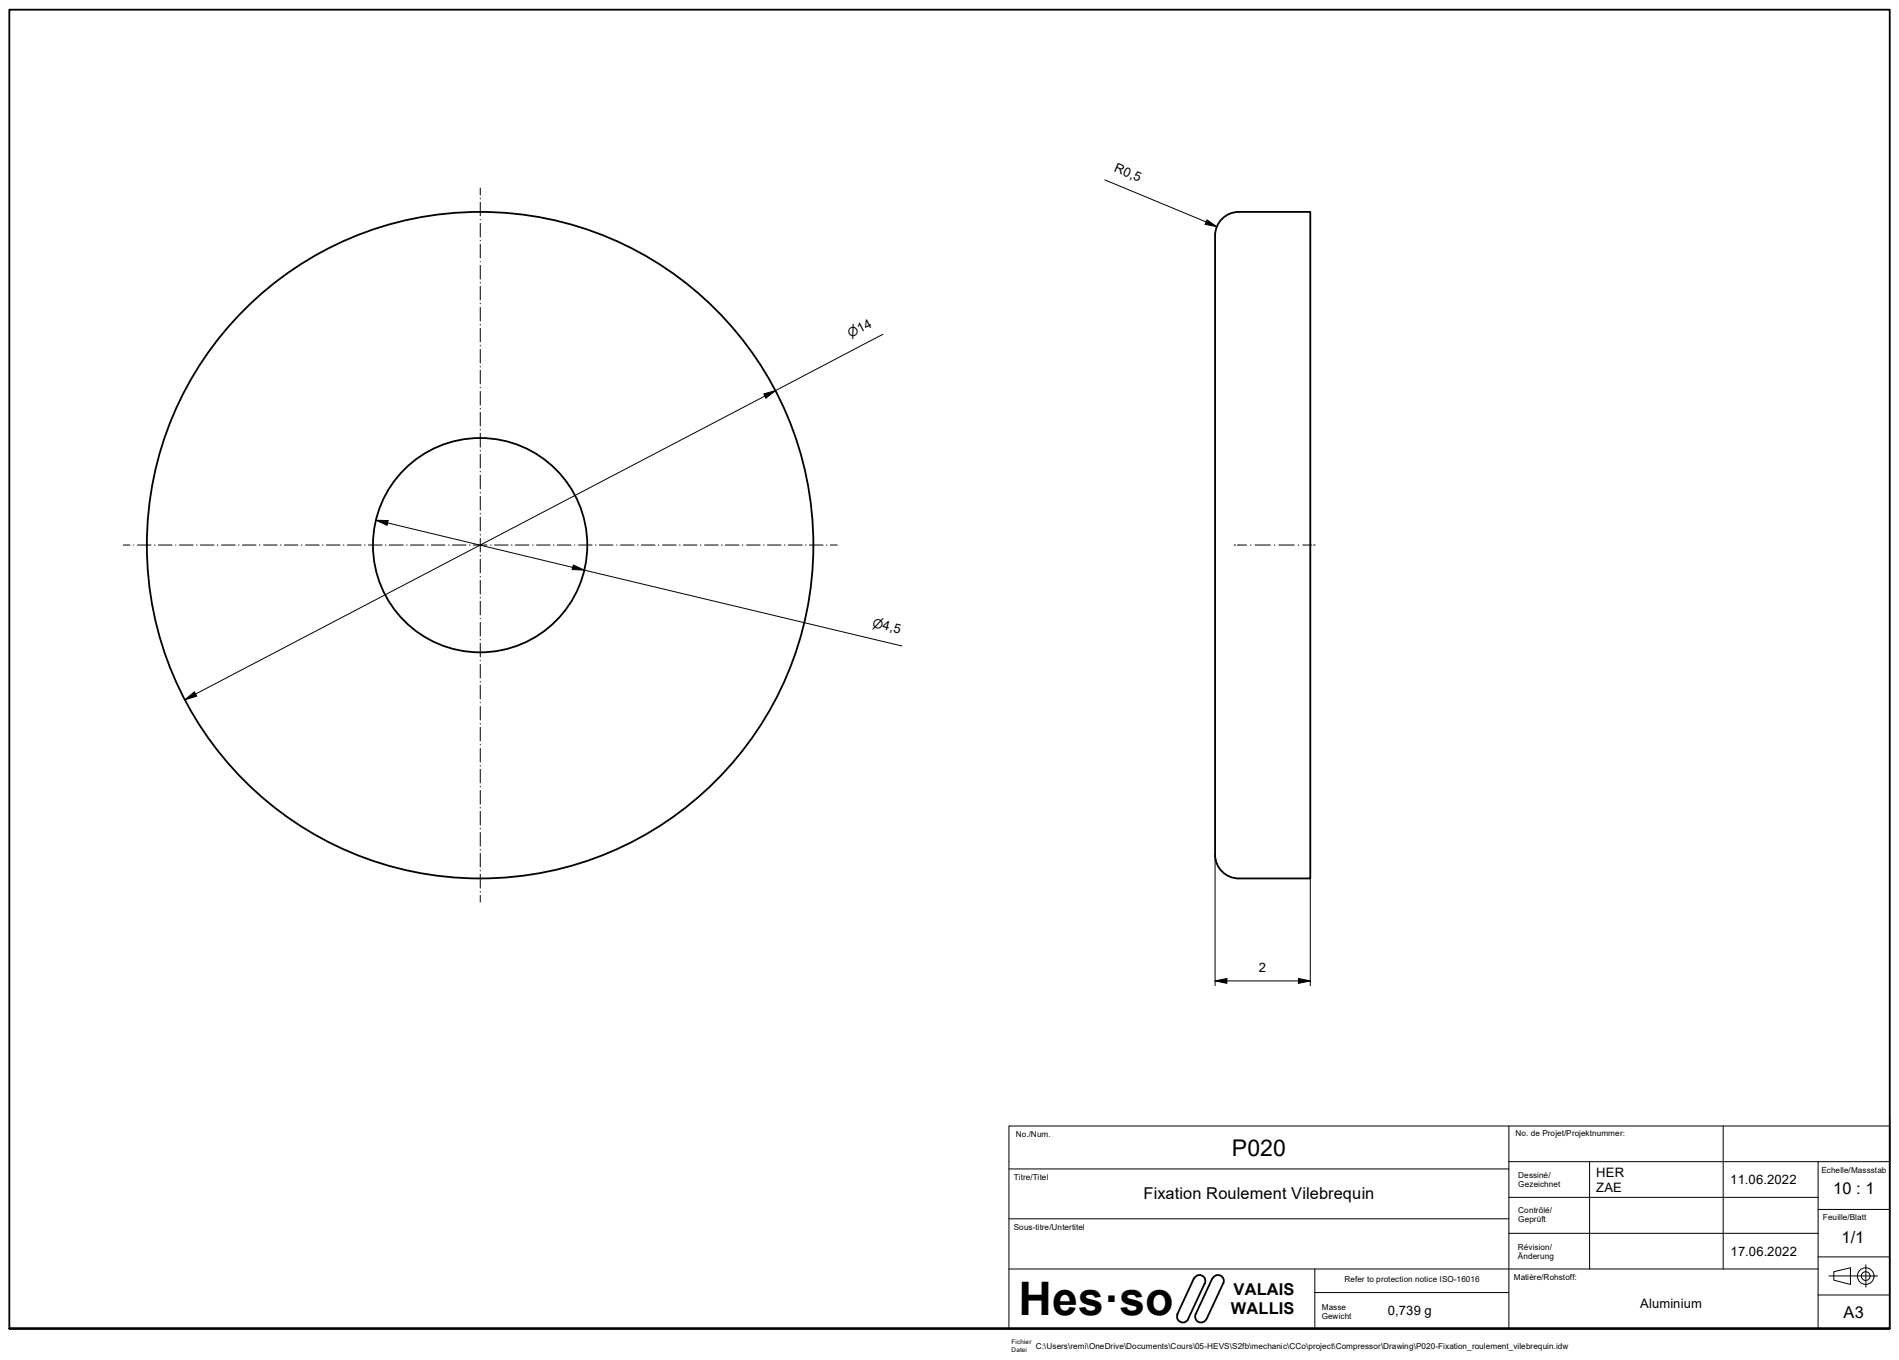
[picture p60: page 1]

No./Num. P020 | No. de Projet/Projektnummer:

Dessinp/ Gezeichnet | HER ZAE | 11.06.2022 | Echelle/Massstab 10 : 1

Fixation Roulement Vilebrequin

Contr{lp/ Geprüft

Sous-titre/Untertitel

Rpvision/ bnderung | | 17.06.2022

Hesso VALAIS WALLIS | Refer to protection notice ISO-16016 | Matiqre/Rohstoff: Aluminium

Masse 0,739 g Gewicht | | A3
