Klagarge/Compressor/PDF/P021-Bouchon_carter_vilbrequin.pdf

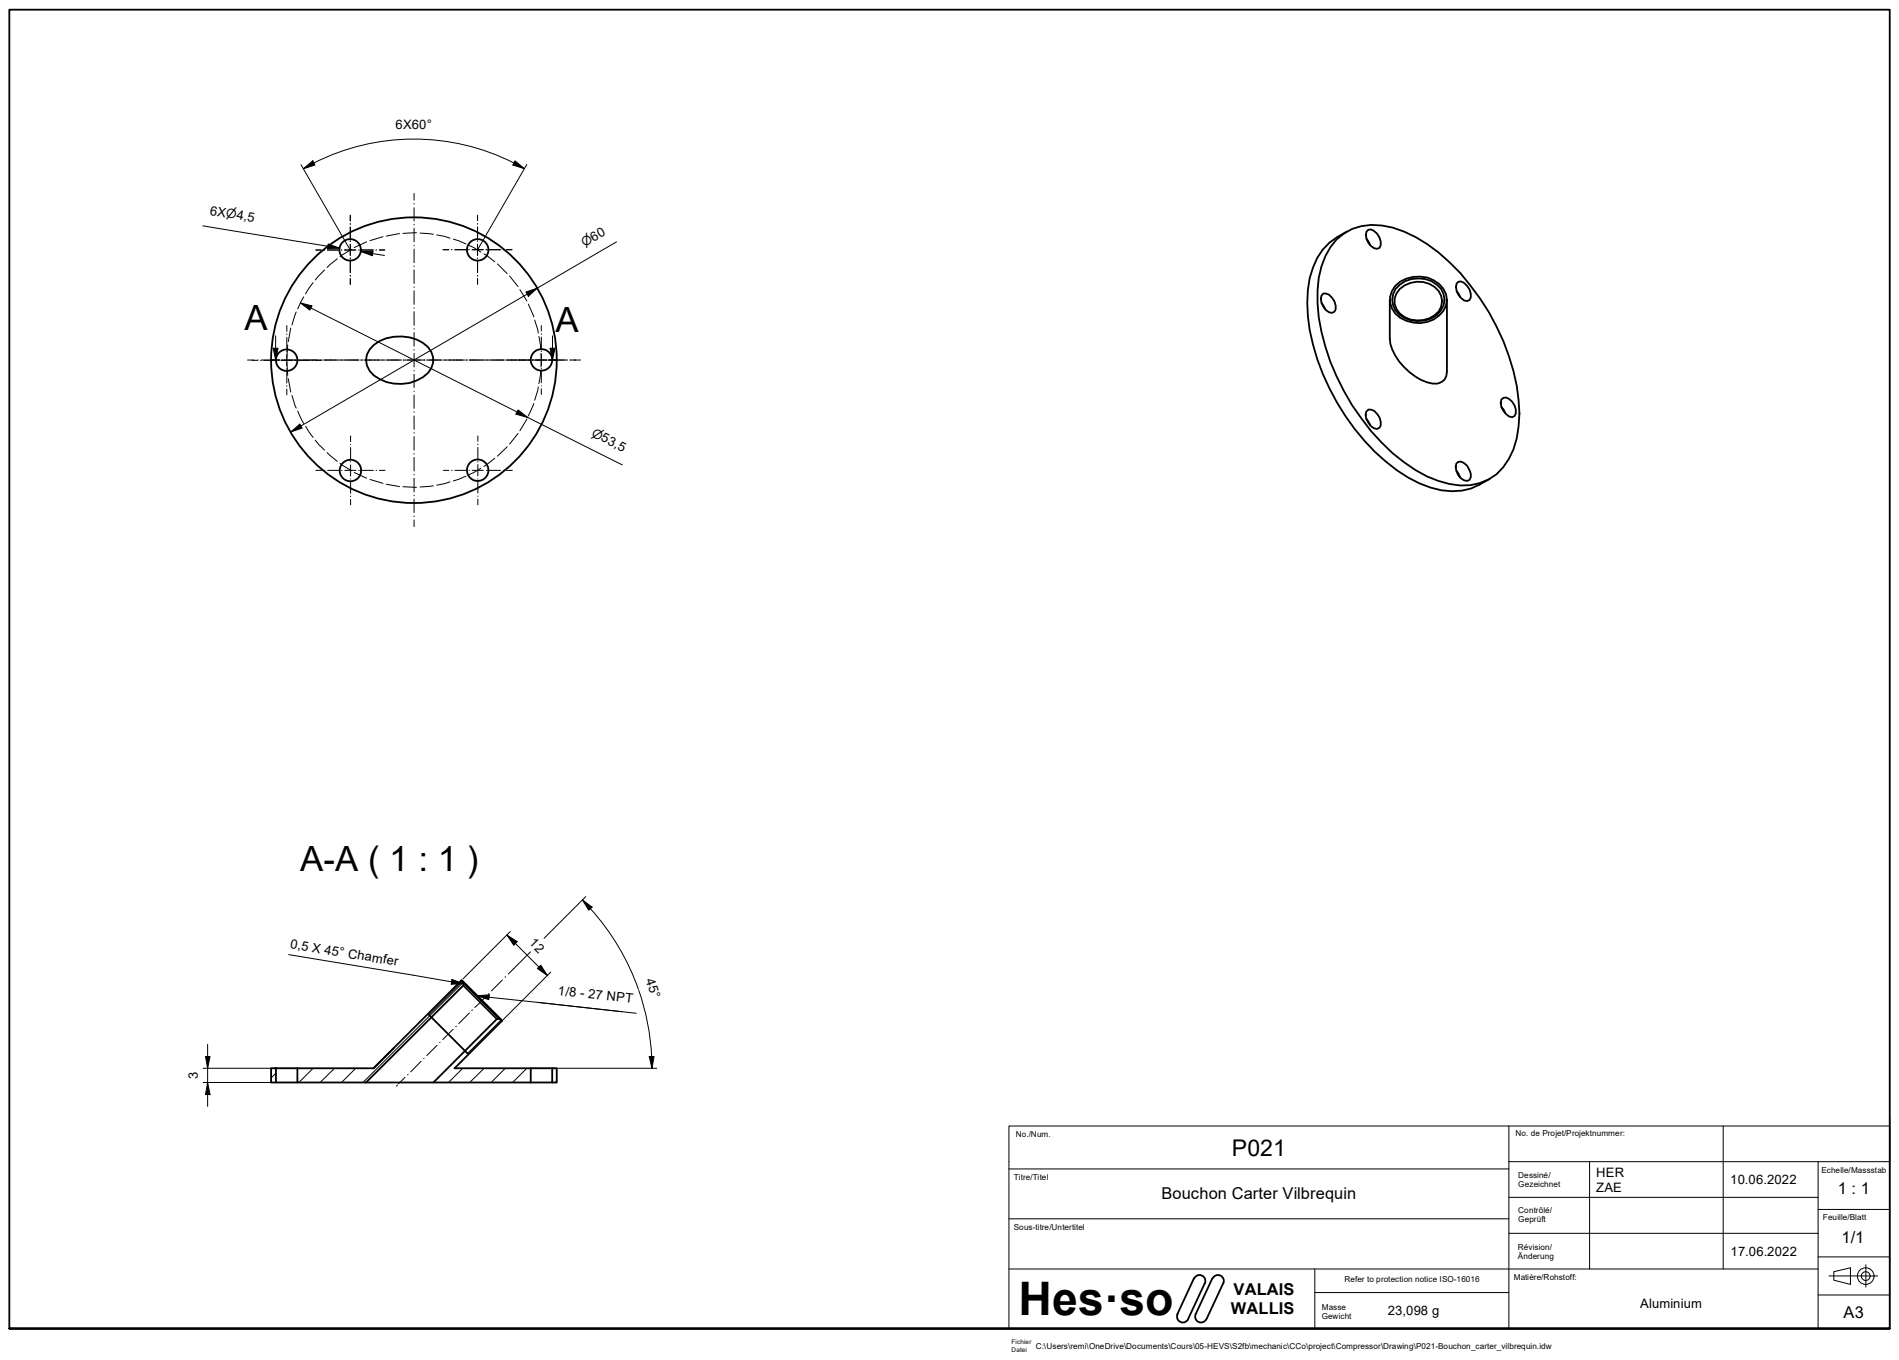
[picture p61: page 1]
- 27 NPT; 45° Chamfer

No./Num. P021 | No. de Projet/Projektnummer:

Dessinp/ Gezeichnet | HER ZAE | 10.06.2022 | Echelle/Massstab 1 : 1

Bouchon Carter Vilbrequin

Contr{lp/ Geprüft

Sous-titre/Untertitel

Rpvision/ bnderung | | 17.06.2022

Hesso VALAIS WALLIS | Refer to protection notice ISO-16016 | Matiqre/Rohstoff: Aluminium

Masse 23,098 g Gewicht | | A3
