Klagarge/Compressor/PDF/P024-Entretoise_roulements.pdf

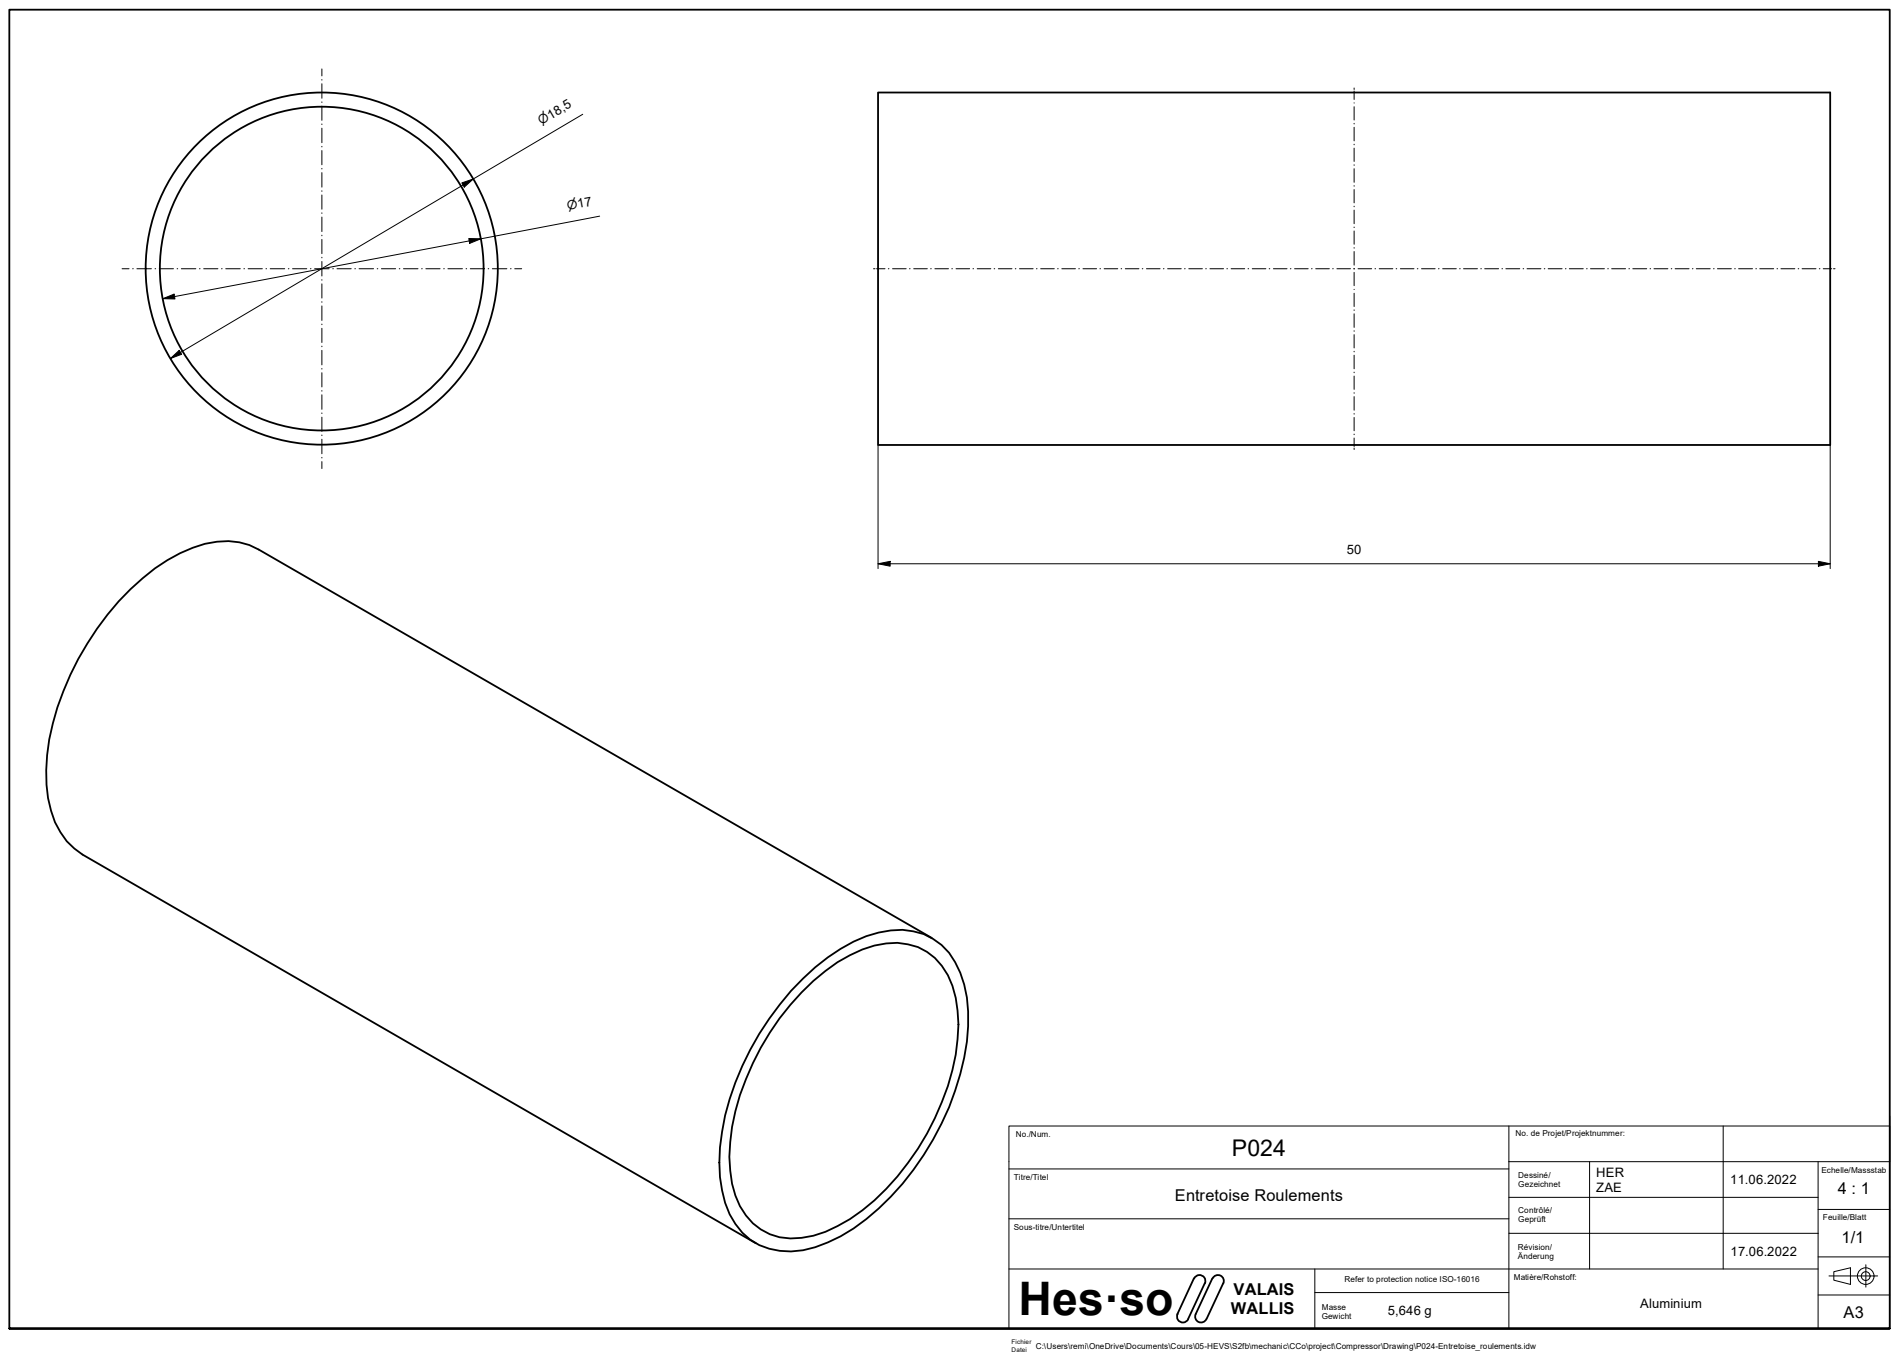
[picture p62: page 1]
Entretoise Roulements

No./Num. P024 | No. de Projet/Projektnummer:

Dessinp/ Gezeichnet | HER ZAE | 11.06.2022 | Echelle/Massstab 4 : 1

Contr{lp/ Geprüft

Sous-titre/Untertitel

Rpvision/ bnderung | | 17.06.2022

Hesso VALAIS WALLIS | Refer to protection notice ISO-16016 | Matiqre/Rohstoff: Aluminium

Masse 5,646 g Gewicht | | A3
