Klagarge/Compressor/PDF/P026-Butée_carter_arbre.pdf

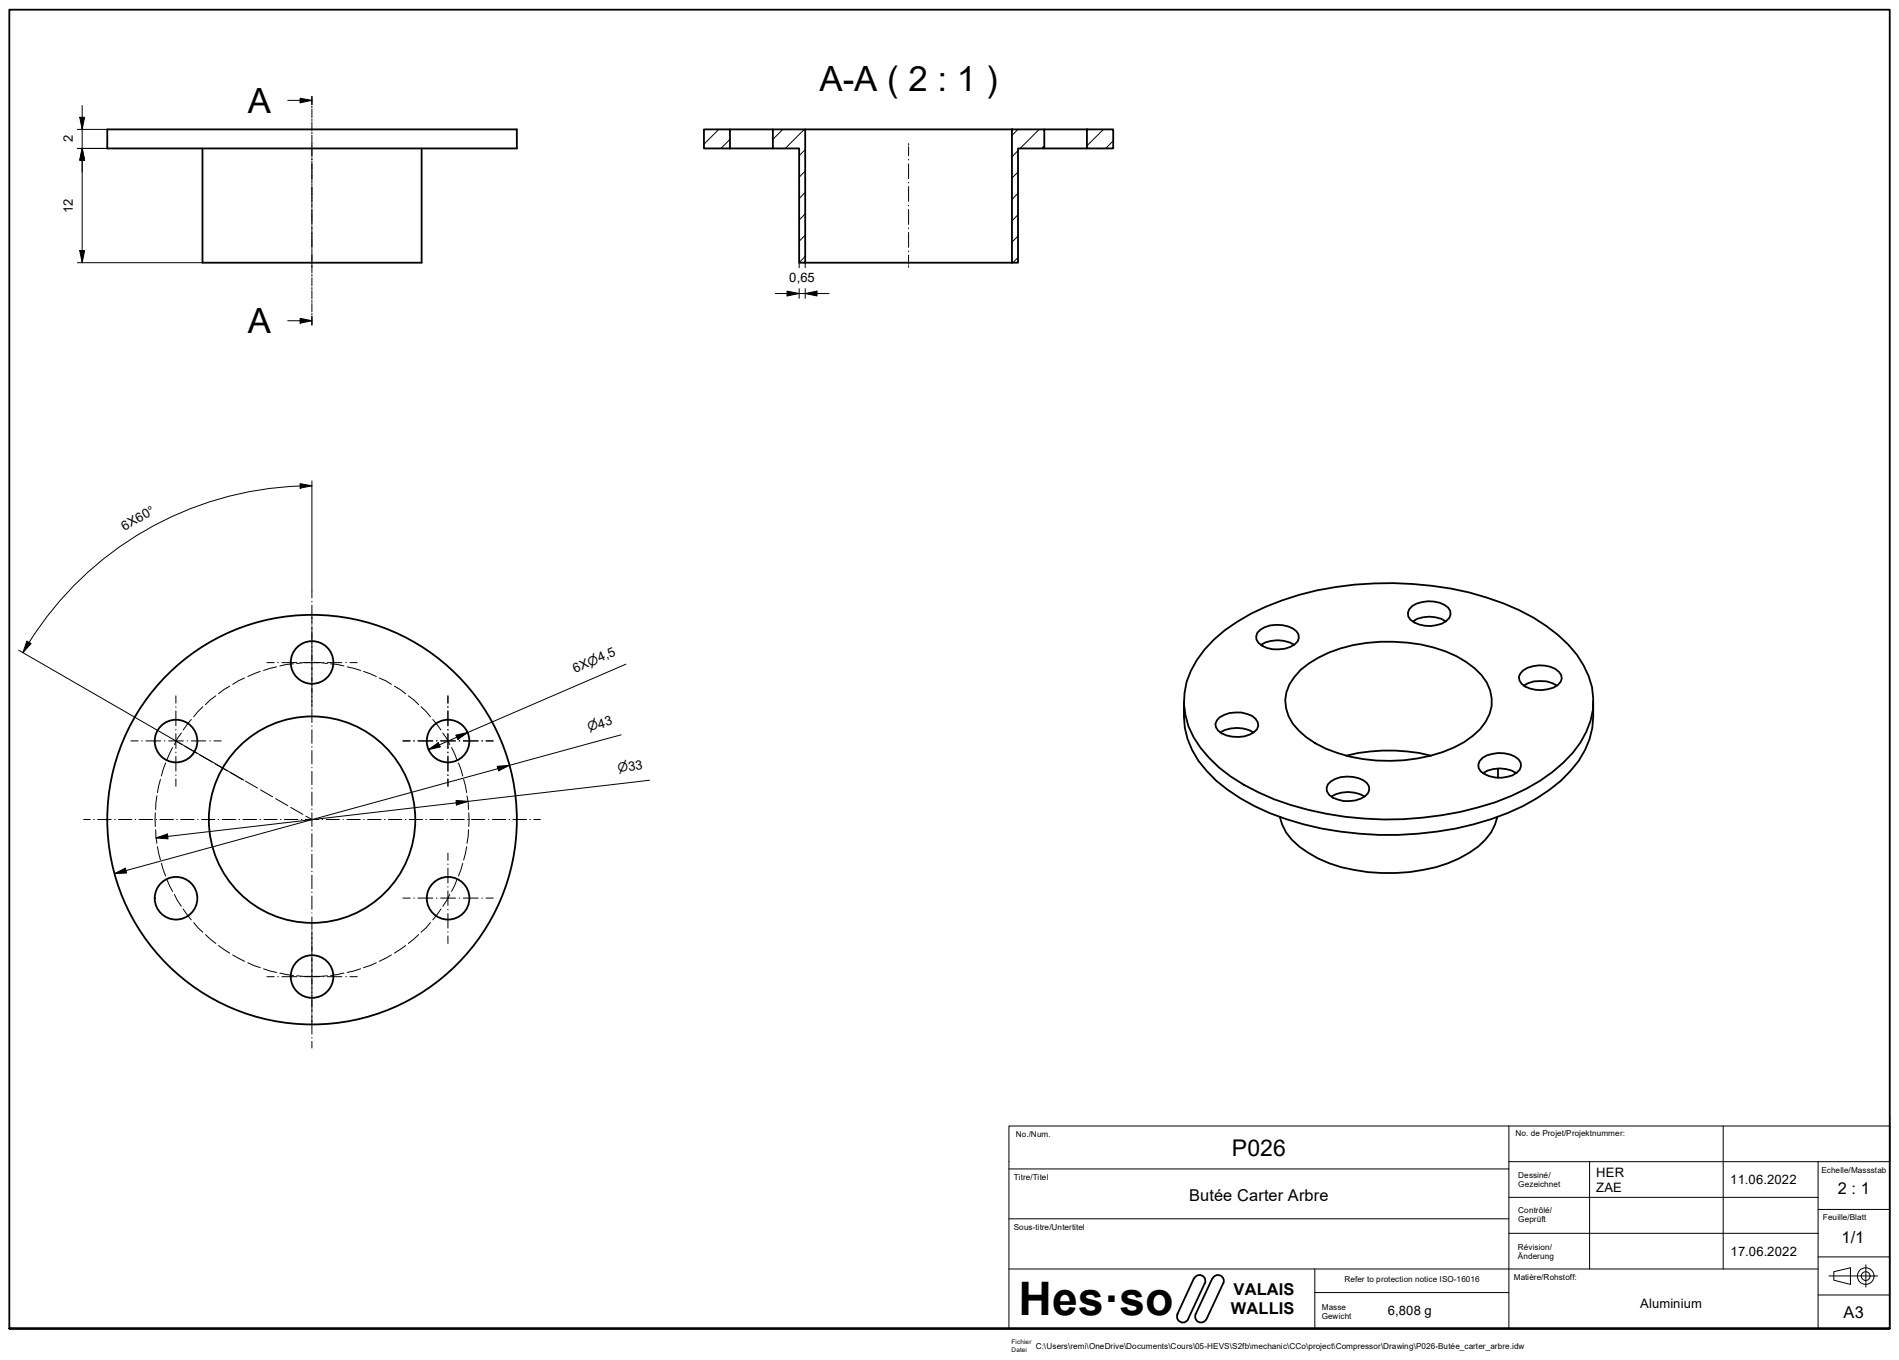
[picture p63: page 1]

No./Num. P026 | No. de Projet/Projektnummer:

Dessinp/ Gezeichnet | HER ZAE | 11.06.2022 | Echelle/Massstab 2 : 1

Butpe Carter Arbre

Contr{lp/ Geprüft

Sous-titre/Untertitel

Rpvision/ bnderung | | 17.06.2022

Hesso VALAIS WALLIS | Refer to protection notice ISO-16016 | Matiqre/Rohstoff: Aluminium

Masse 6,808 g Gewicht | | A3
