Klagarge/Compressor/PDF/P027-Segment.pdf

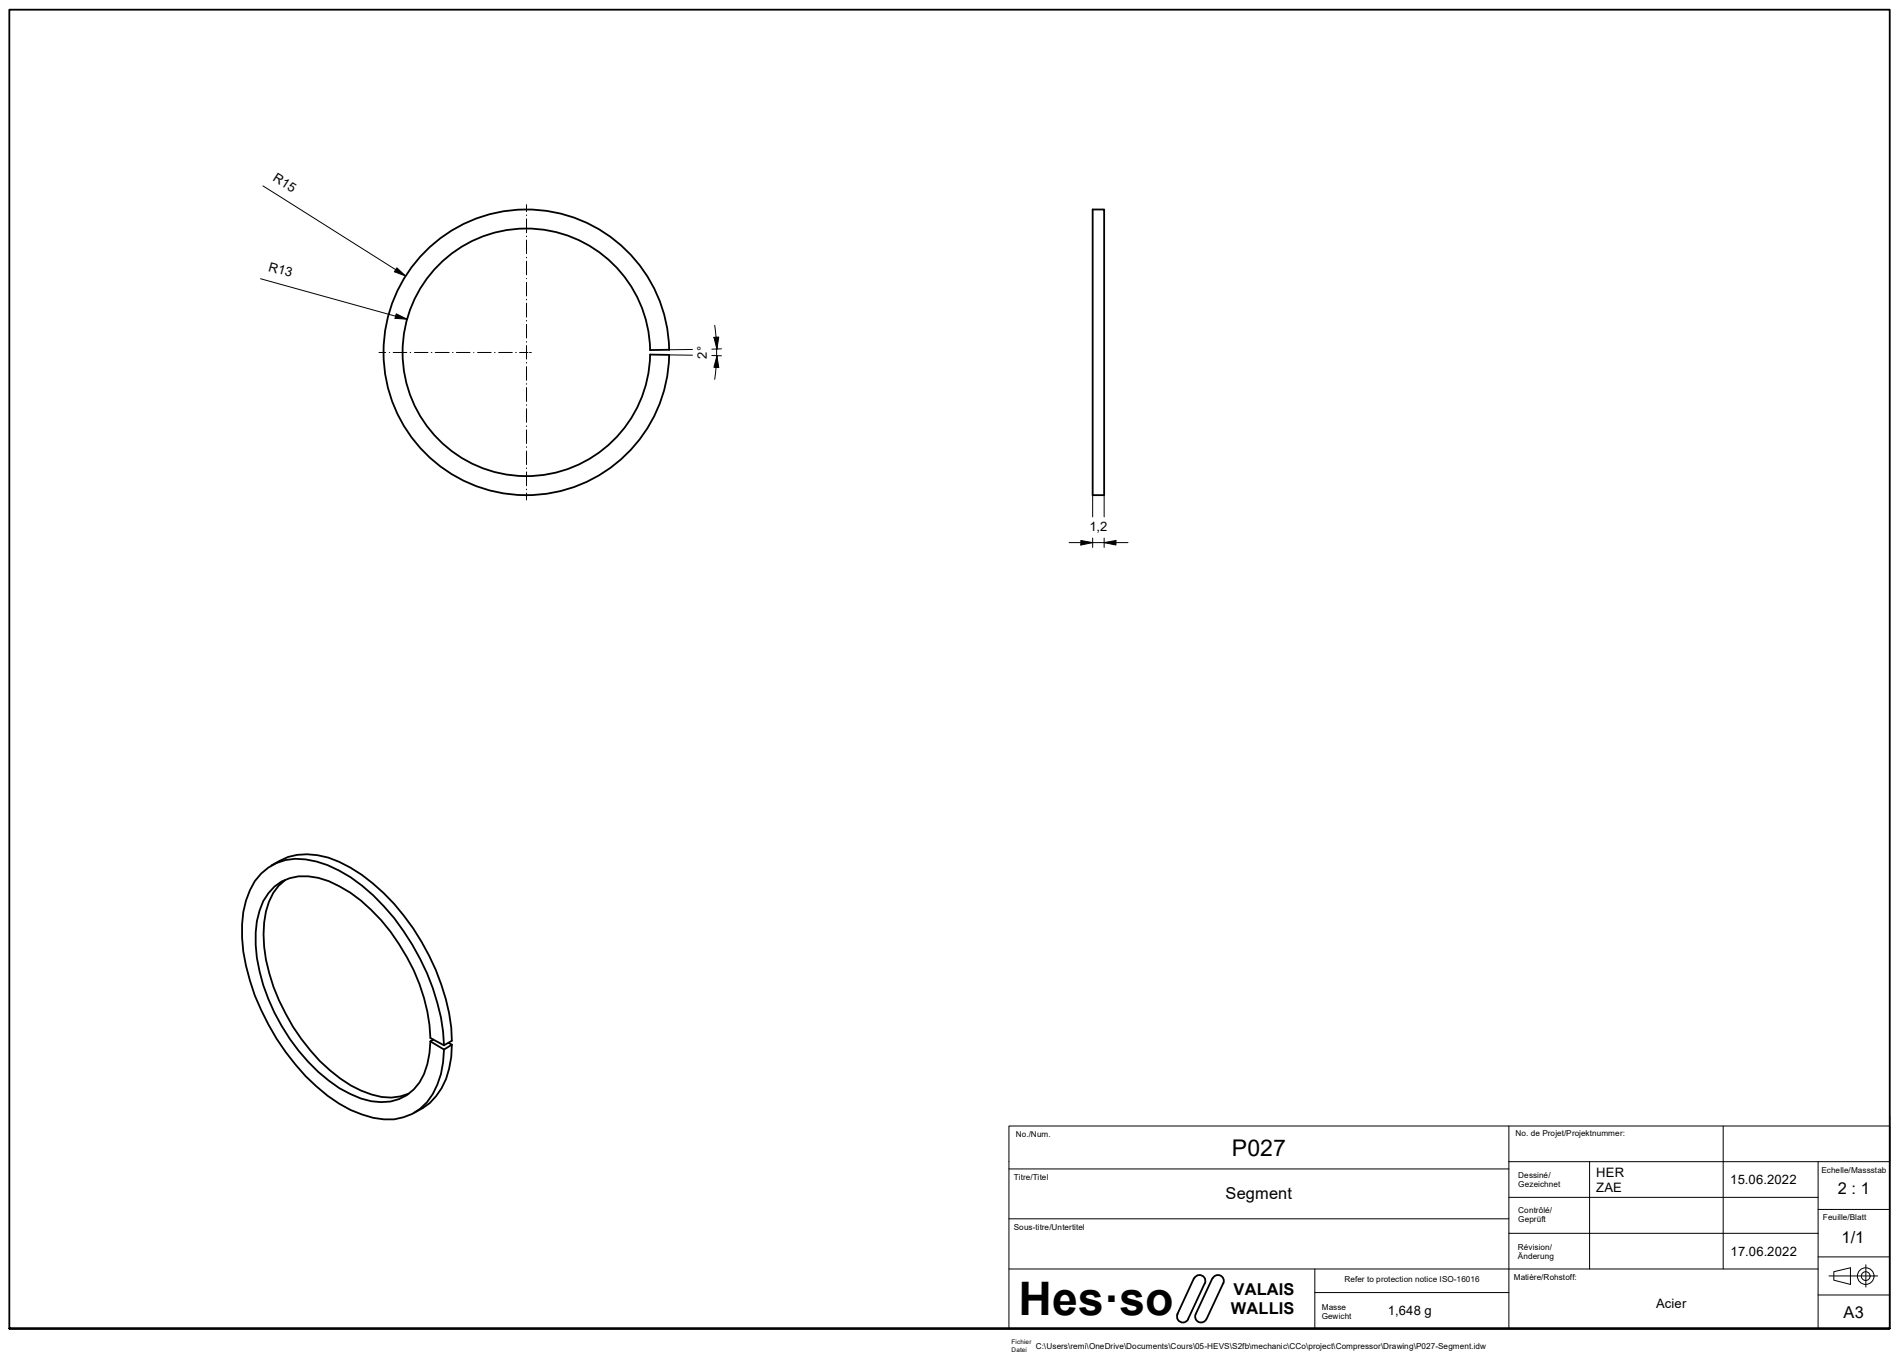
[picture p64: page 1]

No./Num. P027 | No. de Projet/Projektnummer:

Dessinp/ Gezeichnet | HER ZAE | 15.06.2022 | Echelle/Massstab 2 : 1

Contr{lp/ Geprüft

Sous-titre/Untertitel

Rpvision/ bnderung | | 17.06.2022

Hesso VALAIS WALLIS | Refer to protection notice ISO-16016 | Matiqre/Rohstoff: Acier

Masse 1,648 g Gewicht | | A3
