Klagarge/Compressor/PDF/P029-Ressort.pdf

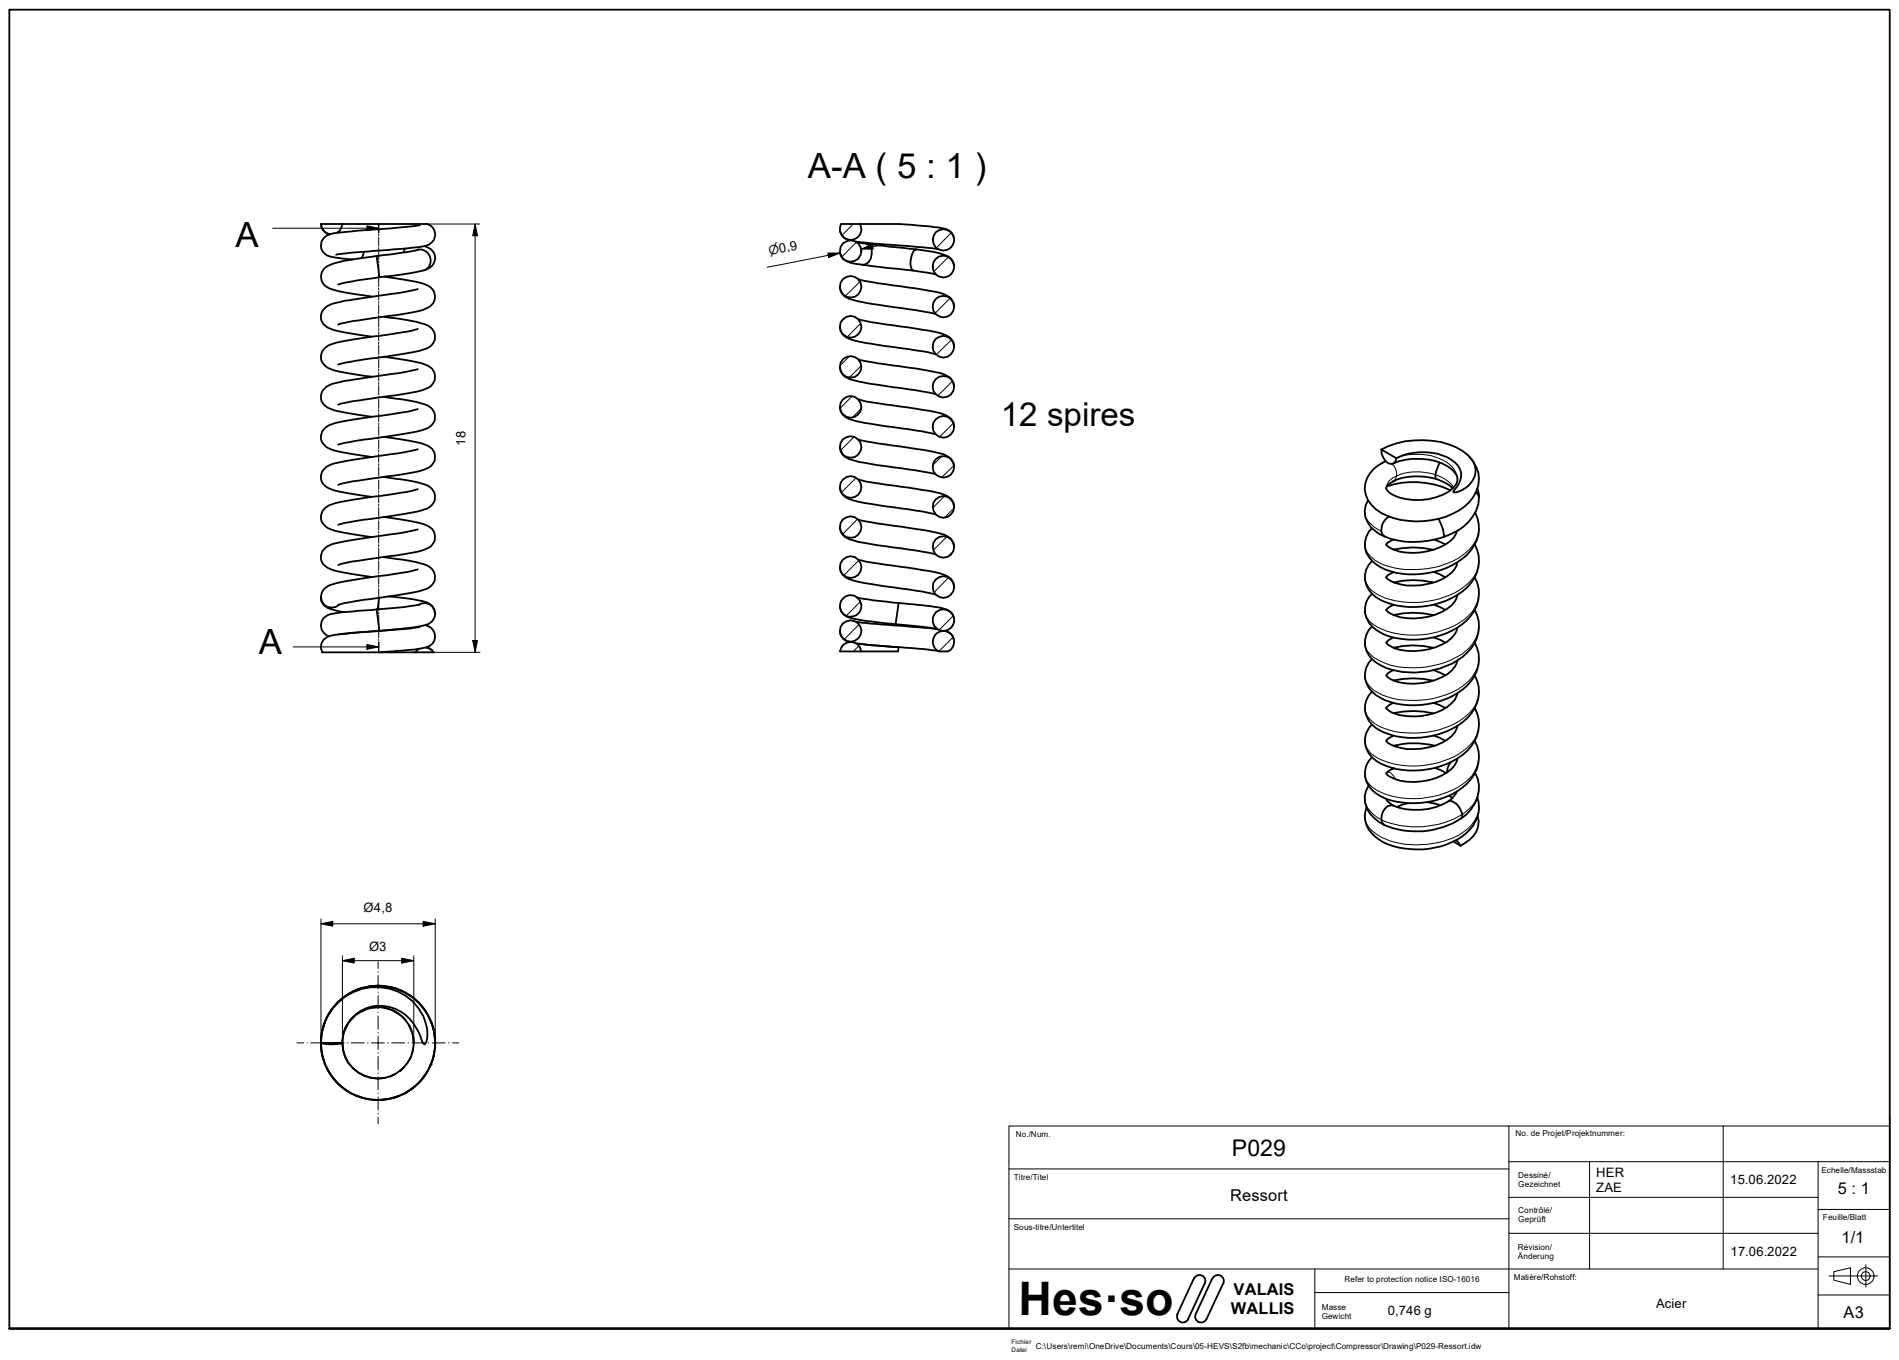
[picture p65: page 1]
12 spires

No./Num. P029 | No. de Projet/Projektnummer:

Dessinp/ Gezeichnet | HER ZAE | 15.06.2022 | Echelle/Massstab 5 : 1

Contr{lp/ Geprüft

Sous-titre/Untertitel

Rpvision/ bnderung | | 17.06.2022

Hesso VALAIS WALLIS | Refer to protection notice ISO-16016 | Matiqre/Rohstoff: Acier

Masse 0,746 g Gewicht | | A3
