Klagarge/Compressor/(commit log)

2022-03-18 ajouter piece p001
    [P001-Couverture.ipt, P002-Bati_chambre.ipt, P003-Corps_piston.ipt]
2022-03-24 mise en plan 3d
    [P003-Corps_piston.0002.ipt, P003-Corps_piston.ipt, P006-Soupape_entree.ipt, P011_Chapeau_chambre.ipt]
2022-03-30 Create P005_Axe_piston.ipt
    3d
    [P005_Axe_piston.ipt]
2022-03-31 work without coffee ;(
    [E000-Compresseur.0001.iam, E000-Compresseur.iam, E001-Chambre.0002.iam, E001-Chambre.iam, E002-Piston.0003.iam, E002-Piston.iam, E005-Bielle.0001.iam, E005-Bielle.iam]
2022-04-01 fix + vilbrequin
    [E000-Compresseur.0001.iam, E000-Compresseur.0003.iam, E000-Compresseur.iam, E001-Chambre.0002.iam, E001-Chambre.0004.iam, E001-Chambre.iam, E002-Piston.0003.iam, E002-Piston.0004.iam]
2022-04-01 fix content center + start carter
    [AS 1420 - 1973 - M3 x 6.0001.ipt, AS 1420 - 1973 - M3 x 6.ipt, AS 1420 - 1973 - M4 x 12.ipt, AS 1420 - 1973 - M4 x 20.ipt, AS 1420 - 1973 - M4 x 8.ipt, DIN 7985 (Z) - M2,5x3-Z.ipt, DIN 7985 (Z) - M2,5x5-Z.ipt, DIN 7985 (Z) - M4x10-Z.ipt]
2022-04-01 finish carter but not perfect
    [AS 1420 - 1973 - M3 x 8.ipt, E000-Compresseur.0004.iam, E000-Compresseur.0007.iam, E000-Compresseur.iam, E001-Chambre.0004.iam, E001-Chambre.0005.iam, E001-Chambre.iam, E006-Carter.0001.iam]
2022-04-01 finish carter
    fix length for compression chamber
    [E000-Compresseur.0007.iam, E000-Compresseur.0008.iam, E000-Compresseur.iam, E006-Carter.0005.iam, E006-Carter.0009.iam, E006-Carter.iam, P012-Corps_bielle.0009.ipt, P012-Corps_bielle.0011.ipt]
2022-04-01 Fix for rendering
    [E000-Compresseur.0008.iam, E000-Compresseur.0010.iam, E000-Compresseur.iam, E005-Bielle.0004.iam, E005-Bielle.0005.iam, E005-Bielle.iam, E006-Carter.0009.iam, E006-Carter.0012.iam]
2022-04-08 create soupape
    [E000-Compresseur.0010.iam, E000-Compresseur.0012.iam, E000-Compresseur.iam, E001-Chambre.0005.iam, E001-Chambre.0006.iam, E001-Chambre.iam, E002-Piston.0004.iam, E002-Piston.0005.iam]
2022-05-13 corrections done
    [E000-Compresseur.0012.iam, E000-Compresseur.0014.iam, E000-Compresseur.iam, E001-Chambre.0005.iam, E002-Piston.0004.iam, E005-Bielle.iam, E006-Carter.0014.iam, E006-Carter.0017.iam]
2022-05-20 for Elise
    [P015-Vilbrequin.0004.ipt, P015-Vilbrequin.0009.ipt, P015-Vilbrequin.0010.ipt, P015-Vilbrequin.ipt, SKF_W 61701-2RS1.iam, SKF_W 61701-2RS1_PART1.ipt, SKF_W 61701-2RS1_PART2.ipt, SKF_W 61701-2RS1_PART3.ipt]
2022-05-25 drawing
    drawing
    [P001-Couverture.idw, P002-Bati_chambre.idw, P003-Corps_piston.0001.idw, P003-Corps_piston.idw, P005-Axe_piston.idw, P006-Soupape_IN.idw, P006-Soupape_IN.ipt, P011-Chapeau_chambre.idw]
2022-05-26 cross your fingers
    [E000-Compresseur.0014.iam, E000-Compresseur.0016.iam, E000-Compresseur.iam, E006-Carter.0017.iam, E006-Carter.0019.iam, E006-Carter.iam, P012-Bielle.0013.ipt, P012-Bielle.0014.ipt]
2022-05-26 update vilbrequin
    u
    [P012-Bielle.0014.ipt, P012-Bielle.0015.ipt, P012-Bielle.ipt, P015-Vilbrequin.0011.ipt, P015-Vilbrequin.0012.ipt, P015-Vilbrequin.ipt]
2022-05-26 add skf
    [E000-Compresseur.0016.iam, E000-Compresseur.0017.iam, E000-Compresseur.iam, E002-Piston.0004.iam, E002-Piston.0005.iam, E002-Piston.0006.iam, E002-Piston.iam, E006-Carter.0019.iam]
2022-05-26 rayon sur vilbrequin
    [P015-Vilbrequin.0012.ipt, P015-Vilbrequin.0013.ipt, P015-Vilbrequin.ipt]
2022-05-26 probably somes problems
    [AS 1420 - 1973 - M3 x 8.0001.ipt, AS 1420 - 1973 - M3 x 8.ipt, AS 1420 - 1973 - M4 x 12.0001.ipt, AS 1420 - 1973 - M4 x 12.ipt, E000-Compresseur.0017.iam, E000-Compresseur.0020.iam, E000-Compresseur.iam, E001-Chambre.0005.iam]
2022-05-27 work at home
    [E000-Compresseur.0020.iam, E000-Compresseur.0023.iam, E000-Compresseur.iam, E001-Chambre.0008.iam, E001-Chambre.0009.iam, E001-Chambre.iam, E002-Piston.0009.iam, E002-Piston.0010.iam]
2022-05-28 joint chambre + carter
    [E000-Compresseur.0014.iam, E000-Compresseur.0016.iam, E000-Compresseur.0023.iam, E000-Compresseur.0026.iam, E000-Compresseur.iam, E001-Chambre.0009.iam, E001-Chambre.0013.iam, E001-Chambre.iam]
2022-05-28 chambre + ajustement carter + vis
    [E000-Compresseur.0026.iam, E000-Compresseur.0031.iam, E000-Compresseur.iam, E001-Chambre.0013.iam, E001-Chambre.0014.iam, E001-Chambre.iam, E006-Carter.0034.iam, E006-Carter.0040.iam]
2022-05-29 petit dessin
    [P001-Couverture.0001.idw, P001-Couverture.idw, P002-Bati_chambre.0001.idw, P002-Bati_chambre.0005.idw, P002-Bati_chambre.idw, P017-Carter_chapeau.0002.idw, P017-Carter_chapeau.idw, P018-Joint_carter_chapeau.idw]
2022-05-29 ajustement chapeau chambre
    [Compress Spring11.ipt, E000-Compresseur.0031.iam, E000-Compresseur.0033.iam, E000-Compresseur.iam, E001-Chambre.0014.iam, E001-Chambre.0019.iam, E001-Chambre.iam, E006-Carter.0040.iam]
2022-05-29 add vis
    [E000-Compresseur.0033.iam, E000-Compresseur.0034.iam, E000-Compresseur.iam, E001-Chambre.0019.iam, E001-Chambre.0021.iam, E001-Chambre.iam]
2022-05-29 modif haut soupape
    [Compress Spring13.ipt, E001-Chambre.0021.iam, E001-Chambre.0023.iam, E001-Chambre.iam, P006-Soupape.0005.ipt, P006-Soupape.0006.ipt, P006-Soupape.ipt, P006-Soupape_OUT.0001.ipt]
2022-05-29 soupapes done, reste ressorts
    [Compress Spring12.ipt, E000-Compresseur.0034.iam, E000-Compresseur.0038.iam, E000-Compresseur.iam, E001-Chambre.0023.iam, E001-Chambre.0031.iam, E001-Chambre.iam, E006-Carter.0042.iam]
2022-05-29 finish for today
    [E000-Compresseur.0043.iam, E000-Compresseur.0045.iam, E000-Compresseur.iam, E006-Carter.0049.iam, E006-Carter.0050.iam, E006-Carter.iam]
2022-06-02 add fix roulement-vilbrequin
    [AS 1420 - 1973 - M4 x 14.ipt, E000-Compresseur.0045.iam, E000-Compresseur.0047.iam, E000-Compresseur.iam, E002-Piston.0015.iam, E002-Piston.0016.iam, E002-Piston.iam, E006-Carter.0050.iam]
2022-06-03 correct size of some compenents
    [AS 1420 - 1973 - M4 x 8.0001.ipt, AS 1420 - 1973 - M4 x 8.ipt, E000-Compresseur.0047.iam, E000-Compresseur.0050.iam, E000-Compresseur.iam, E002-Piston.0016.iam, E002-Piston.0018.iam, E002-Piston.iam]
2022-06-06 début roulement arbre
    [E000-Compresseur.0050.iam, E000-Compresseur.0051.iam, E000-Compresseur.iam, E006-Carter.0058.iam, E006-Carter.0060.iam, E006-Carter.iam, P016-Carter_corps.0026.ipt, P016-Carter_corps.0028.ipt]
2022-06-11 fix arbre
    [E000-Compresseur.0052.iam, E000-Compresseur.0054.iam, E000-Compresseur.iam, E006-Carter.0064.iam, E006-Carter.0073.iam, E006-Carter.iam, ISO 2491 - A 6 x 4 x 14.ipt, ISO 3601-1 - B 0236 G 23(8).ipt]
2022-06-11 vidange huile
    [AS 1427 - M10 x 20(2).ipt, E000-Compresseur.0054.iam, E000-Compresseur.0055.iam, E000-Compresseur.iam, E006-Carter.0073.iam, E006-Carter.0079.iam, E006-Carter.iam, P015-Vilbrequin.0021.ipt]
2022-06-11 carter done
    [68978100.ipt, 68978100.stp, 68978300.ipt, E006-Carter.0079.iam, E006-Carter.0081.iam, E006-Carter.iam, P016-Carter_corps.0034.ipt, P016-Carter_corps.0035.ipt]
2022-06-11 bouchon carter
    [P021-Bouchon_carter_vilbrequin.0003.ipt, P021-Bouchon_carter_vilbrequin.0004.ipt, P021-Bouchon_carter_vilbrequin.ipt]
2022-06-12 Modif des propriété et des schéma
    [P003-Corps_piston.0005.idw, P003-Corps_piston.0006.idw, P003-Corps_piston.idw, P011-Chapeau_chambre.0009.idw, P011-Chapeau_chambre.0010.idw, P011-Chapeau_chambre.idw, P012-Bielle.0003.idw, P012-Bielle.0004.idw]
2022-06-14 juste check
    [E000-Compresseur.0058.iam, E000-Compresseur.0059.iam, E000-Compresseur.iam, P014-Chapeau_bielle.ipt]
2022-06-14 respirateur + alignement vis
    [8631T11_Breather Vent.ipt, E000-Compresseur.0059.iam, E000-Compresseur.0061.iam, E000-Compresseur.iam, E006-Carter.0083.iam, E006-Carter.0085.iam, E006-Carter.iam, P016-Carter_corps.0037.ipt]
2022-06-15 some change
    [09381-16002.SLDPRT, 12111-45002.SLDASM, 12111-45002.SLDPRT, 12111-45013.SLDPRT, 12140-45013.SLDASM, 12151-29001.SLDPRT, 64790021.stp, 64790059.stp]
2022-06-15 check drawing
    [Compress Spring11.ipt, Compress Spring12.ipt, Compress Spring13.ipt, Compress Spring14.ipt, Compress Spring15.ipt, E000-Compresseur.0004.idw, E000-Compresseur.0006.idw, E000-Compresseur.0062.iam]
2022-06-15 update masse
    [Compress Spring11.ipt, Compress Spring12.ipt, Compress Spring13.ipt, Compress Spring14.0001.ipt, Compress Spring14.ipt, Compress Spring15.0001.ipt, Compress Spring15.ipt, E000-Compresseur.0064.iam]
2022-06-15 add segments !
    [E000-Compresseur.0065.iam, E000-Compresseur.0068.iam, E000-Compresseur.iam, E001-Chambre.0038.iam, E001-Chambre.0042.iam, E001-Chambre.iam, E002-Piston.0022.iam, E002-Piston.0024.iam]
2022-06-15 i ve done it
    [P019-Chapeau_tete_chambre.0006.idw, P019-Chapeau_tete_chambre.0007.idw, P019-Chapeau_tete_chambre.idw, P021-Bouchon_carter_vilbrequin.0006.idw, P021-Bouchon_carter_vilbrequin.0008.idw, P021-Bouchon_carter_vilbrequin.idw]
2022-06-16 vraiment caca
    [P028-Segment_racleur.0001.idw, P028-Segment_racleur.idw]
2022-06-16 change joint
    [P018-Joint_carter_chapeau.0006.idw, P018-Joint_carter_chapeau.0007.idw, P018-Joint_carter_chapeau.idw, P022-Joint_carter_bouchon_vilbrequin.0003.idw, P022-Joint_carter_bouchon_vilbrequin.0004.idw, P022-Joint_carter_bouchon_vilbrequin.idw, P025-Joint_carter_arbre.0003.idw, P025-Joint_carter_arbre.0004.idw]
2022-06-16 on a fini
    [P002-Bati_chambre.0011.idw, P002-Bati_chambre.0012.idw, P002-Bati_chambre.idw, P005-Axe_piston.0003.idw, P005-Axe_piston.0004.idw, P005-Axe_piston.idw]
2022-06-16 export pdf
    [E000-Compresseur.0006.idw, E000-Compresseur.0007.idw, E000-Compresseur.0068.iam, E000-Compresseur.0069.iam, E000-Compresseur.iam, E000-Compresseur.idw, E001-Chambre.0008.idw, E001-Chambre.0009.idw]
2022-06-16 modif bull
    [E006-Carter.0005.idw, E006-Carter.0006.idw, E006-Carter.idw]
2022-06-17 correct drawing
    [E000-Compresseur.0008.idw, E000-Compresseur.0009.idw, E000-Compresseur.0069.iam, E000-Compresseur.0070.iam, E000-Compresseur.iam, E000-Compresseur.idw, E001-Chambre.0010.idw, E001-Chambre.0011.idw]
2022-06-17 fix masse
    [E000-Compresseur.0009.idw, E000-Compresseur.0010.idw, E000-Compresseur.0070.iam, E000-Compresseur.0071.iam, E000-Compresseur.iam, E000-Compresseur.idw, E001-Chambre.0011.idw, E001-Chambre.0012.idw]
2022-06-17 change drawing
    [E000-Compresseur.0010.idw, E000-Compresseur.0011.idw, E000-Compresseur.0071.iam, E000-Compresseur.0072.iam, E000-Compresseur.iam, E000-Compresseur.idw, E001-Chambre.0012.idw, E001-Chambre.0013.idw]
