Klagarge/Compressor/(notices)

Notices in the files:
Circlips/ungespannt_61799403.stp:
FILE_NAME( 'C:/Users/Stangenbergd/Documents/CAD_Step/1/ungespannt_61799403.stp', '2020-09-05T13:04:42', ( 'License CC BY-ND 4.0' ), ( 'CADENAS' ), ' ', 'PARTsolutions', ' ' );
Circlips/einbaufertig_61799403.stp:
FILE_NAME( 'C:/Users/Stangenbergd/Documents/CAD_Step/1/einbaufertig___gespannt_61799403.stp', '2020-09-05T13:07:03', ( 'License CC BY-ND 4.0' ), ( 'CADENAS' ), ' ', 'PARTsolutions', ' ' );
